flapkit/FLAP-0-BD3/hardware/bd3_rev01/exports/BD3_A3CY050B_B18A_REV01_20251206_TOP.jpeg

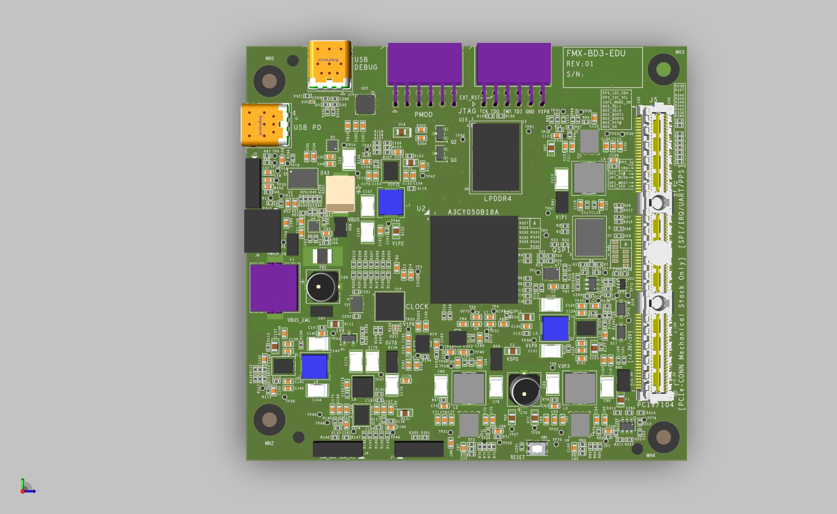
hardware/bd3_rev01/exports/BD3_A3CY050B_B18A_REV01_20251206_TOP.jpeg
