flapkit/FLAP-0-BD3/README.md

# FLAP-0 BD3  
**Open FPGA CubeSat Development Board**

<br>


<br>

## Overview

FLAP-0 BD3 is an open-source FPGA-based CubeSat development board designed for education, research, and early-stage space systems prototyping. The board enables experimentation with reconfigurable logic, control systems, sensor interfacing, and hardware–software co-design using fully open design files and documentation.

BD3 serves as the foundational hardware platform in the FLAP-0 family.

## Intended Use

- CubeSat avionics learning and prototyping  
- FPGA-based reconfigurable logic experimentation  
- Control systems and payload interfacing  
- Hardware–software co-design education  
- Ground-in-the-loop and hardware-in-the-loop testing  

## Repository Contents

- Schematics  
- PCB layout files  
- Bill of materials  
- Assembly outputs  
- Software and reference designs  
- Documentation and lab materials  

All files are provided in editable source formats.

## Licensing

- Hardware license: CERN-OHL-S v2  
- Software license: MIT  
- Documentation license: CC-BY-SA-4.0  

## Open Source Hardware Certification

FLAP-0 BD3 is certified as **Open Source Hardware** by the Open Source Hardware Association (OSHWA)

- Certification authority. OSHWA  
- Project name. FLAP-0 BD3 – Open FPGA CubeSat Board  
- Hardware version. BD3 Rev 01  
- Certification UID. To be added once issued  
- Documentation repository. https://github.com/flapkit/FLAP-0-BD3  

All design files, schematics, PCB layouts, bill of materials, and documentation are publicly available in editable formats in accordance with OSHWA certification requirements.

## Disclaimer

FLAP-0 BD3 is a foundational FPGA CubeSat development board intended for education, research, and space systems prototyping, and it does not claim or provide space-qualified capabilities.

## Citation

If you use FLAP-0 BD3 in academic or research work, please cite the repository and reference this hardware version.

## Contact

 Email: info@flapkit.org
