flapkit/FLAP-0-BD3/CERTIFICATION.md

# Open Source Hardware Certification

FLAP-0 BD3 is certified as **Open Source Hardware** by the Open Source Hardware Association (OSHWA).

## Certification Details

- **Certification Authority**: OSHWA
- **Project Name**: FLAP-0 BD3 – Open FPGA CubeSat Board
- **Hardware Version**: BD3 Rev 01
- **Certification UID**: To be added once issued
- **Documentation Repository**: https://github.com/flapkit/FLAP-0-BD3

## Compliance

All design files, schematics, PCB layouts, bill of materials, and documentation are publicly available in editable formats in accordance with OSHWA certification requirements.

## License

- **Hardware**: CERN-OHL-S v2 (see LICENSE-HARDWARE)
- **Software**: MIT (see LICENSE-SOFTWARE)
- **Documentation**: CC-BY-SA-4.0 (see LICENSE-DOCUMENTATION)

## Certification Requirements Met

- [x] Hardware design files available in editable formats
- [x] Documentation provided in open formats
- [x] Bill of materials (BOM) provided
- [x] Assembly instructions provided
- [x] Clear licensing for hardware, software, and documentation
- [x] Source files maintained in public repository
