flapkit/FLAP-0-BD3/hardware/bd3_rev01/bom/BD3_A3CY050B_REV01_20251206.xlsx

BD3_A3CY050B_REV01 Revised: December 06, 2025
Revision: 01
Item | Quantity | Reference | Part | Description | PCB Footprint | Manufacture | Manufacture PN | Distributer | Distr PN
1 | 6 | C1,C16,C17,C28,C29,C35 | 4.7uF | CAP-CER,SMD;4.7uF,20%,0402,6.3V,X5R | C0402 | TAIYO YUDEN | JMK105BBJ475MV-F | DIGIKEY | 587-2787-1-ND
2 | 39 | C2,C59,C60,C72,C73,C76,C86,C91,C92,C94,C104,C108,C109,C111,C121,C126,C127,C136,C138,C141,C150,C152,C153,C164,C167,C168,C169,C170,C178,C179,C180,C184,C189,C190,C193,C279,C280,C286,C297 | 0.1uF | CAP-CER,SMD;0.1uF,10%,0603,50V,X7R | C0603 | MURATA | GRM188R71H104KA93D | DIGIKEY | 490-1519-2-ND
3 | 8 | C3,C87,C88,C105,C122,C135,C149,C163 | 1uF | CAP-CER,SMD;1uF,10%,0603,50V,X5R | C0603 | MURATA | GRM188R61H105KAALD | DIGIKEY | 490-10732-2-ND
4 | 8 | C4,C5,C6,C7,C8,C9,C14,C15 | 47uF | CAP CER 47UF 6.3V X5R 0603 | C0603 | Murata Electronics | ZRB18AR60J476ME01L | Digikey | 490-13255-1-ND
5 | 17 | C10,C11,C12,C13,C18,C20,C27,C30,C36,C37,C194,C219,C240,C254,C260,C266,C276 | 10uF | CAP CER 10UF 10V X5R 0402 | C0402 | Samsung Electro-Mechanics | CL05A106MP8NUB8 | Digikey | 1276-6830-1-ND
6 | 18 | C19,C21,C22,C23,C24,C25,C26,C31,C32,C33,C34,C38,C39,C40,C41,C42,C43,C44 | 1uF | CAP CER 1UF 10V X5R 0201 | C0201 | Taiyo Yuden | LMK063BBJ105MPLF | Digikey | 587-6263-1-ND
7 | 15 | C45,C46,C48,C49,C50,C84,C85,C102,C103,C119,C120,C134,C148,C162,C301 | 0.01uF | CAP-CER,SMD;0.01uF,10%,0603,100V,X7R | C0603 | MURATA | GRM188R72A103KA01D | DIGIKEY | 490-6438-2-ND
8 | 20 | C47,C61,C71,C74,C75,C89,C90,C93,C106,C107,C110,C124,C125,C139,C140,C154,C155,C166,C171,C300 | 10uF | CAP CER 10UF 35V X5R 0603 | C0603 | Murata Electronics | GRM188R6YA106MA73D | Digikey | 490-13248-1-ND
9 | 3 | C51,C52,C53 | 22uF | CAP-CER,SMD;22uF,10%,1210,25V,X5R | C1210 | MURATA | GRM32ER61E226KE15L | DIGIKEY | 490-3889-1-ND
10 | 2 | C54,C55 | 330pF | CAP CER 330PF 50V X7R 0603 | C0603 | YAGEO | CC0603KRX7R9BB331 | Digikey | 311-1186-1-ND
11 | 3 | C56,C57,C58 | 10uF | CAP CER 10UF 6.3V X5R 0603 | C0603 | Murata Electronics | GRM188R60J106ME84D | Digikey | 490-7316-1-ND
12 | 1 | C62 | 2200pF | CAP-CER,SMD;2200pF,10%,0402,50V,X7R | C0402 | MURATA | GRM155R71H222KA01D | DIGIKEY | 490-1305-2-ND
13 | 12 | C63,C82,C83,C100,C101,C117,C118,C133,C147,C161,C290,C294 | 1000pF | CAP-CER,SMD;1000pF,10%,0402,50V,X7R | C0402 | MURATA | GRM155R71H102KA01D | DIGIKEY | 490-1303-2-ND
14 | 2 | C64,C284 | 0.01uF | CAP-CER,SMD;0.01uF,10%,0402,50V,X7R | C0402 | MURATA | GRM155R71H103KA88J | DIGIKEY | 490-6351-2-ND
15 | 4 | C65,C66,C67,C68 | 4.7uF | CAP CER 4.7UF 50V X7R 1206 | C1206 | Murata Electronics | GRM31CR71H475KA12L | Digikey | 490-6521-1-ND
16 | 2 | C69,C70 | 47uF | CAP ALUM 47UF 20% 50V SMD | EEE-FN1H470XP | Panasonic Electronic Components | EEE-FN1H470XP | Digikey | 10-EEE-FN1H470XPCT-ND
17 | 5 | C77,C95,C128,C142,C156 | 33pF | CAP-CER,SMD;33pF,1%,0402,50V,NP0 | C0402 | MURATA | GRM1555C1H330FA01D | DIGIKEY | 490-6231-1-ND
18 | 30 | C78,C79,C80,C81,C96,C97,C98,C99,C113,C114,C115,C116,C129,C130,C131,C132,C143,C144,C145,C146,C157,C158,C159,C160,C172,C173,C174,C175,C176,C177 | 47uF | CAP-CER,SMD;47uF,10%,1210,16V,X5R | C1210 | MURATA | GRM32ER61C476KE15K | DIGIKEY | 490-6538-1-ND
19 | 3 | C112,C187,C281 | 100pF | CAP-CER,SMD;100pF,5%,0402,50V,NP0 | C0402 | MURATA | GRM1555C1H101JA01D | DIGIKEY | 490-5922-1-ND
20 | 3 | C123,C137,C151 | 0.47uF | CAP-CER,SMD;0.47uF,10%,0805,50V,X7R | C0805 | MURATA | GRM21BR71H474KA88K | DIGIKEY | 490-8319-2-ND
21 | 1 | C165 | 0.22uF | CAP-CER,SMD;0.22uF,10%,0402,16V,X7R | C0402 | MURATA | GRM155R71C224KA12D | DIGIKEY | 490-5418-2-ND
22 | 7 | C181,C185,C186,C188,C191,C192,C282 | 2.2uF | CAP-CER,SMD;2.2uF,10%,0603,16V,X5R | C0603 | MURATA | GRM188R61C225KE15D | DIGIKEY | 490-3296-2-ND
23 | 3 | C182,C298,C299 | 47pF | CAP-CER,SMD;47pF,5%,0402,50V,X5R | C0402 | MURATA | GRM1555C1H470JA01D | DIGIKEY | 490-5942-1-ND
24 | 1 | C183 | 4.7uF | CAP CER 4.7UF 10V X5R 0402 | C0402 | Murata Electronics | GRM155R61A475MEAAD | Digikey | 490-14306-1-ND
25 | 52 | C195,C196,C197,C198,C199,C200,C201,C202,C203,C204,C205,C206,C207,C208,C209,C210,C211,C212,C213,C214,C215,C216,C217,C218,C220,C221,C222,C223,C224,C225,C226,C227,C228,C229,C230,C231,C232,C233,C234,C235,C236,C237,C238,C239,C241,C242,C243,C244,C245,C246,C247,C248 | 0.1uF | CAP-CER,SMD;0.1uF,10%,0201,10V,X5R | C0201 | MURATA | GRM033R61A104KE15D | DIGIKEY | 490-5881-1-ND
26 | 2 | C251,C252 | 18pF | CAP-CER,SMD;18pF,1%,0402,50V,NP0 | C0402 | MURATA | GRM1555C1H180FA01D | DIGIKEY | 490-6203-1-ND
27 | 13 | C253,C255,C256,C259,C261,C262,C263,C264,C265,C267,C269,C275,C277 | 1uF | CAP-CER,SMD;1uF,10%,0402,10V,X5R | C0402 | MURATA | GRM155R61A105KE15D | DIGIKEY | 490-3890-1-ND
28 | 18 | C257,C258,C268,C270,C271,C272,C273,C274,C278,C283,C287,C288,C289,C291,C292,C293,C295,C296 | 0.1uF | CAP-CER,SMD;0.1uF,10%,0402,25V,X7R | C0402 | TDK | C1005X7R1E104K050BB | DIGIKEY | 445-7348-2-ND
29 | 1 | C285 | 1000pF | CAP-CER,SMD;1000pF,10%,0402,25V,X5R | C0402 | MURATA | GRM155R61E102KA01D | DIGIKEY | 490-6315-2-ND
30 | 2 | C302,C303 | 2200pF | CAP-CER,SMD;2200pF,10%,1808,,2KV,X7R | PA_SMC1808A | YAGEO | CC1808KKX7RDBB222 | DIGIKEY | 311-4538-2-ND
31 | 4 | D1,D2,D3,D4 | PESD2V0Y1BSFYL | 3V (Typ) Clamp 6A (8/20µs) Ipp Tvs Diode Surface Mount DSN0603-2 | PESD2V0Y1BSFYL | Nexperia USA Inc. | PESD2V0Y1BSFYL | Digikey | 1727-PESD2V0Y1BSFYLCT-ND
32 | 1 | D5 | 22V, TVS2200DRVR | UNIDIR PRECISION SURGE DIODE | TVS2200DRVR | Texas Instruments | TVS2200DRVR | Digikey | 296-52187-1-ND
33 | 25 | D8,D9,D10,D11,D12,D13,D14,D15,D20,D23,D24,D25,D26,D27,D28,D29,D33,D34,D35,D36,D37,D38,D39,D40,D41 | GG040203100N2P | TVS DIODE 3.3VWM 10VC 0402 | GG040203100N2P | KYOCERA AVX | 478-GG040203100N2PCT-ND | Digikey | 478-GG040203100N2PCT-ND
34 | 1 | D16 | RED GREEN | LED-SMD;2.1V-1.95V,20mA-20mA,0805,GREEN-RED,APHBM2012SURKCGKC | LED_RG_0805 | KINGBRIGHT | APHBM2012SURKCGKC | DIGIKEY | 754-1093-2-ND
35 | 3 | D17,D18,D19 | 1N5819 | DIODE SCHOTTKY 40V 1A SOD123 | 1N5819_SOD123 | Diodes | 1N5819HW-7-F | Digikey | 1N5819HW-FDICT-ND
36 | 1 | D30 | ESD441DPLR | TVS DIODE 5.5VWM 7.6VC 2X2SON | ESD441DPLR | Texas Instruments | ESD441DPLR | Digikey | 296-ESD441DPLRCT-ND
37 | 2 | D31,D32 | ESD321DPYR | TVS DIODE 3.6VWM 6.8VC 2X1SON | ESD321DPYR | Texas Instruments | ESD321DPYR | Digikey | 296-51108-1-ND
38 | 2 | D42,D43 | B560C-13-F | DIODE SCHOTTKY 60V 5A SMC | B560C-13-F | Diodes Incorporated | B560C-13-F | DIGIKEY | B560C-FDICT-ND
39 | 1 | FB1 | 600 Ohm @ 100 MHz | FERRITE BEAD 600 OHM 0402 1LN | FB0402 | Murata Electronics | BLM15PX601SN1D | Digikey | 490-9657-1-ND
40 | 3 | FB2,FB3,FB10 | 26 Ohms @ 100 MHz | FERRITE BEAD 26 OHM 0603 1LN | FB0603 | Murata Electronics | BLM18KG260TN1D | Digikey | 490-5252-1-ND
41 | 5 | FB4,FB6,FB7,FB8,FB9 | 22 Ohms @ 100 MHz | FERRITE BEAD 22 OHM 0603 1LN | FB0603 | Murata Electronics | BLM18SN220TZ1D | Digikey | 490-13960-1-ND
42 | 1 | FB5 | 56 Ohms @ 100 MHz | FERRITE BEAD 56 OHM 1612 1LN | FB1612 | Würth Elektronik | 74279223560 | Digikey | 732-3421-1-ND
43 | 2 | F1,F2 | PTSLR08058V400 | PTC RESET FUSE 4A 8V 0805 | PTSLR08058V400 | Eaton - Electronics Division | PTSLR08058V400 | Digikey | 283-PTSLR08058V400CT-ND
44 | 2 | J1,J6 | PPPC062LJBN-RC | CONN HDR 12POS 0.1 GOLD PCB R/A | PPPC062LJBN-RC | Sullins Connector Solutions | PPPC062LJBN-RC | Digikey | S5559-ND
45 | 2 | J2,J10 | 12402012E212A | CONN RCP USB2.0 TYP C 24P SMD RA | 12402012E212A | Amphenol ICC (Commercial Products) | 12402012E212A | Digikey | 664-12402012E212ACT-ND
46 | 3 | J3,J4,J7 | CONN 4POS 2.54MM | CONN HEADER VERT 4POS 2.54MM | 1X4POS_2P54MM | Würth Elektronik | 61300411121 | Digikey | 732-5317-ND
47 | 1 | J5 | ASP-129637-03 | CONN HDR 156POS SMD GOLD | ASP-129637-03 | Samtec Inc. | ASP-129637-03 | Digikey | SAM10405-ND
48 | 1 | J8 | CSS-1210TB | SWITCH SLIDE SPDT 100MA 12V | CSS-1210TB | Nidec Components Corporation | CSS-1210TB | Digikey | 563-1091-1-ND
49 | 1 | L1 | 4.7uH | FIXED IND 4.7UH 10A 15.5MOHM SMD | L_PA4342_472NLT | Pulse Electronics | PA4342.472NLT | Digikey | 553-3001-1-ND
50 | 3 | L2,L3,L4 | 0.68uH | IND 7X6.6X1.8MM 0.68UH20% 10.5A | L_7M0x6M6x2M0 | Bourns Inc. | SRP7020TA-R68M | Digikey | 118-SRP7020TA-R68MCT-ND
51 | 3 | L5,L6,L7 | 5.6uH | IND SMD 5.6UH 3.6A | L_5M7x5M2x3M0 | Bourns Inc. | SRP5030CC-5R6M | Digikey | 118-SRP5030CC-5R6MCT-ND
52 | 1 | L8 | 100nH | FIXED IND 100NH 25.8A 1.8MOHM SM | L_4M0x4Mx3M2 | Coilcraft | XEL4030-101MEC | Digikey | 2457-XEL4030-101MEC-ND
53 | 4 | MH1,MH2,MH3,MH4 | MH_D170C600 | MH-PLATE;170MIL_600MIL | M3_MH
54 | 3 | Q1,Q2,Q3 | SSM3K2615R,LF | MOSFET N-CH 60V 2A SOT23 | SSM3K2615R | Toshiba Semiconductor and Storage | SSM3K2615R,LF | Digikey | SSM3K2615RLFCT-ND
55 | 51 | R1,R2,R3,R7,R11,R12,R14,R15,R16,R17,R18,R26,R27,R28,R30,R45,R48,R54,R94,R123,R127,R129,R149,R157,R240,R293,R294,R295,R296,R299,R300,R301,R307,R309,R312,R317,R336,R337,R338,R339,R340,R341,R342,R343,R344,R345,R346,R347,R348,R349,R350 | 10K | RES-SMD;10KOHM,1%,0402,1/16W | R0402 | YAGEO | RC0402FR-0710KL | DIGIKEY | 311-10.0KLRTR-ND
56 | 8 | R4,R5,R6,R8,R29,R31,R135,R141 | 22 | RES-SMD;22OHM,1%,0402,1/16W | R0402 | YAGEO | RC0402FR-0722RL | DIGIKEY | 311-22.0LRTR-ND
57 | 1 | R9 | 2K | RES-SMD;2KOHM,1%,0402,1/16W | R0402 | YAGEO | RC0402FR-072KL | DIGIKEY | 311-2KLRTR-ND
58 | 36 | R10,R13,R67,R68,R73,R75,R78,R79,R84,R85,R88,R89,R90,R95,R96,R97,R98,R100,R102,R108,R110,R119,R121,R130,R132,R133,R139,R140,R146,R147,R148,R154,R160,R161,R162,R163 | 0 | RES-SMD;0OHM,JUM,0402,1/16W | R0402 | YAGEO | RC0402JR-070RL | DIGIKEY | 311-0.0JRCT-ND
59 | 12 | R19,R20,R21,R22,R23,R24,R305,R306,R310,R311,R313,R315 | 4.7K | RES-SMD;4.7KOHM,1%,0402,1/16W | R0402 | YAGEO | RC0402FR-074K7L | DIGIKEY | 311-4.7KLRTR-ND
60 | 28 | R25,R71,R82,R93,R105,R113,R124,R136,R151,R152,R155,R158,R180,R195,R196,R197,R198,R200,R201,R202,R204,R205,R206,R207,R208,R209,R210,R239 | 1K | RES-SMD;1KOHM,1%,0402,1/16W | R0402 | YAGEO | RC0402FR-071KL | DIGIKEY | 311-1.00KLRTR-ND
61 | 3 | R32,R156,R159 | 240 | RES-SMD;240OHM,1%,0402,1/16W | R0402 | YAGEO | RC0402FR-07240RL | DIGIKEY | 311-240LRTR-ND
62 | 8 | R33,R34,R166,R167,R186,R297,R308,R314 | 0 | RES-SMD;0OHM,JUM,0402,1/10W | R0402 | PANASONIC | ERJ-2GE0R00X | DIGIKEY | P0.0JTR-ND
63 | 29 | R35,R36,R37,R38,R39,R40,R41,R42,R43,R44,R165,R169,R283,R284,R285,R286,R287,R288,R289,R290,R327,R328,R329,R330,R331,R332,R333,R334,R335 | 0 | RES-SMD;0OHM,JUM,0201,1/20W | R0201 | YAGEO | RC0201JR-070RL | DIGIKEY | YAG1244CT-ND
64 | 2 | R47,R55 | 200K | RES-SMD;200KOHM,5%,0402,1/16W | R0402 | YAGEO | RC0402JR-07200KL | DIGIKEY | 311-200KJRCT-ND
65 | 2 | R49,R50 | 169K | RES 169K OHM 1% 1/16W 0402 | R0402 | YAGEO | RC0402FR-07169KL | Digikey | YAG3000CT-ND
66 | 2 | R51,R52 | 3.3K | RES-SMD;3.3KOHM,1%,0603,1/10W | R0603 | YAGEO | RC0603FR-073K3L | DIGIKEY | 311-3.30KHRTR-ND
67 | 2 | R56,R57 | 40.2K | RES SMD 40.2K OHM 1% 1/16W 0402 | R0402 | YAGEO | AC0402FR-0740K2L | Digikey | YAG3486CT-ND
68 | 1 | R58 | 0 | RES-SPECIAL;0OHM,JUM,R10A,10A | R10A | SELF DEFINE | R-0OHM-PCB-10A
69 | 9 | R59,R65,R70,R74,R81,R116,R138,R144,R145 | 100K | RES-SMD;100KOHM,1%,0402,1/16W | R0402 | YAGEO | RC0402FR-07100KL | DIGIKEY | 311-100KLRTR-ND
70 | 1 | R60 | 97.6K | RES-SMD;97.6KOHM,1%,0402,1/16W | R0402 | YAGEO | RC0402FR-0797K6L | DIGIKEY | 311-97.6KLRTR-ND
71 | 2 | R61,R76 | 15K | RES-SMD;15KOHM,1%,0402,1/16W | R0402 | YAGEO | RC0402FR-0715KL | DIGIKEY | 311-15.0KLRTR-ND
72 | 4 | R62,R106,R114,R117 | 20K | RES-SMD;20KOHM,1%,0402,1/16W | R0402 | YAGEO | RC0402FR-0720KL | DIGIKEY | 311-20.0KLRTR-ND
73 | 1 | R63 | 2.2K | RES-SMD;2.2KOHM,1%,0402,1/16W | R0402 | YAGEO | RC0402FR-072K2L | DIGIKEY | 311-2.20KLRTR-ND
74 | 1 | R64 | 5.76K | RES 5.76K OHM 1% 1/16W 0402 | R0402 | YAGEO | RC0402FR-075K76L | DIGIKEY | YAG3196CT-ND
75 | 9 | R66,R77,R87,R103,R111,R122,R131,R153,R242 | 0 | RES-SMD;0OHM,1%,0805,1/8W | R0805 | YAGEO | RC0805JR-070RL | DIGIKEY | 311-0.0ARCT-ND
76 | 4 | R69,R80,R91,R134 | 0 | RES 0 OHM JUMPER 1/2W 1210 | R1210 | YAGEO | RC1210JR-070RL | Digikey | YAG3375CT-ND
77 | 1 | R72 | 13.7K | RES SMD 13.7KOHM 0.1% 1/16W 0402 | R0402 | Panasonic Electronic Components | ERA-2AEB1372X | Digikey | P13.7KDCCT-ND
78 | 1 | R83 | 22.1K | RES-SMD;22.1KOHM,1%,0402,1/16W | R0402 | YAGEO | RC0402FR-0722K1L | DIGIKEY | 311-22.1KLRTR-ND
79 | 1 | R86 | 16.9K | RES SMD 16.9K OHM 1% 1/16W 0402 | R0402 | YAGEO | AC0402FR-0716K9L | Digikey | YAG5638CT-ND
80 | 1 | R92 | 8.45K | RES 8.45K OHM 1% 1/16W 0402 | R0402 | YAGEO | RC0402FR-078K45L | Digikey | YAG3254CT-ND
81 | 1 | R99 | 34.8k | RES 34.8K OHM 1% 1/16W 0402 | R0402 | YAGEO | RC0402FR-0734K8L | Digikey | YAG3125CT-ND
82 | 9 | R101,R109,R120,R187,R190,R199,R203,R291,R292 | 0 | RES-SMD;0OHM,JUM,0603,1/10W | R0603 | YAGEO | RC0603JR-070RL | DIGIKEY | 311-0.0GRTR-ND
83 | 1 | R104 | 5.11K | RES-SMD;5.11KOHM,1%,0402,1/16W | R0402 | YAGEO | RC0402FR-075K11L | DIGIKEY | 311-5.11KLRTR-ND
84 | 3 | R107,R115,R126 | 71.5K | RES 71.5K OHM 1% 1/16W 0402 | R0402 | YAGEO | RC0402FR-0771K5L | Digikey | YAG3222CT-ND
85 | 1 | R112 | 25.5k | RES SMD 25.5K OHM 1% 1/16W 0402 | R0402 | YAGEO | AC0402FR-0725K5L | Digikey | YAG5657CT-ND
86 | 1 | R118 | 38.3k | RES 38.3K OHM 1% 1/16W 0402 | R0402 | YAGEO | RC0402FR-0738K3L | Digikey | YAG3141CT-ND
87 | 1 | R125 | 19.1K | RES-SMD;19.1KOHM,1%,0402,1/16W | R0402 | YAGEO | RC0402FR-0719K1L | DIGIKEY | 311-19.1KLRTR-ND
88 | 1 | R128 | 17.4K | RES-SMD;17.4KOHM,1%,0402,1/16W | R0402 | YAGEO | RC0402FR-0717K4L | DIGIKEY | 311-17.4KLRTR-ND
89 | 1 | R137 | 2.2 | RES 2.2 OHM 1% 1/16W 0402 | R0402 | YAGEO | RC0402FR-072R2L | Digikey | 311-2.20LRCT-ND
90 | 2 | R150,R241 | 560 | RES-SMD;560OHM,1%,0402,1/16W | R0402 | YAGEO | RC0402FR-07560RL | DIGIKEY | 311-560LRTR-ND
91 | 1 | R211 | 100 | RES-SMD;100OHM,1%,0201,1/20W | R0201 | YAGEO | RC0201JR-07100RL | DIGIKEY | 311-100NTR-ND
92 | 8 | R275,R276,R277,R278,R279,R280,R281,R282 | 10K | RES-SMD;10KOHM,1%,0201,1/20W | R0201 | YAGEO | RC0201FR-0710KL | DIGIKEY | 311-10.0KMCT-ND
93 | 1 | R298 | 130K | RES-SMD;130KOHM,1%,0402,1/16W | R0402 | YAGEO | RC0402FR-07130KL | DIGIKEY | YAG2969CT-ND
94 | 2 | R302,R304 | 1.5K | RES-SMD;1.5KOHM,1%,0603,1/10W | R0603 | YAGEO | RC0603FR-071K5L | DIGIKEY | 311-1.50KHRTR-ND
95 | 1 | R303 | 49.9K | RES-SMD;49.9KOHM,1%,0402,1/16W | R0402 | YAGEO | RC0402FR-0749K9L | DIGIKEY | 311-49.9KLRTR-ND
96 | 3 | R316,R319,R320 | 27 | RES-SMD;27OHM,1%,0402,1/16W | R0402 | SAMSUNG | RC1005F270CS | DIGIKEY | 1276-3907-1-ND
97 | 1 | R318 | 49.9 | RES-SMD;49.9OHM,1%,0402,1/16W | R0402 | YAGEO | RC0402FR-0749R9L | DIGIKEY | 311-49.9LRTR-ND
98 | 2 | R321,R322 | 5.1K | RES-SMD;5.1KOHM,1%,0402,1/16W | R0402 | YAGEO | RC0402FR-075K1L | DIGIKEY | 311-5.10KLRTR-ND
99 | 1 | R324 | 1M | RES-SMD;1MOHM,1%,1206,1/4W
 | PA_SMR1206 | STACKPOLE ELECTRONICS, INC. | RMCF1206FT1M00 | DIGIKEY
101 | 1 | R325 | 1M | RES D,1206, 1M OHM,1%,1/4W
 | PA_SMR1206 | STACKPOLE ELECTRONICS, INC. | RMCF1206FT1M00 | DIGIKEY
102 | 1 | SW1 | 435451019820 | Tactile Switch SPST-NO Top Actuated Surface Mount | 435451019820 | Würth Elektronik | 435451019820 | Digikey | 732-435451019820CT-ND
103 | 70 | TP1,TP2,TP3,TP4,TP5,TP6,TP7,TP8,TP9,TP10,TP11,TP12,TP13,TP14,TP18,TP19,TP20,TP21,TP22,TP23,TP24,TP25,TP26,TP27,TP28,TP29,TP30,TP31,TP32,TP33,TP34,TP35,TP36,TP37,TP38,TP39,TP40,TP41,TP42,TP43,TP44,TP45,TP46,TP47,TP48,TP49,TP50,TP51,TP52,TP53,TP54,TP55,TP56,TP57,TP58,TP59,TP60,TP61,TP62,TP63,TP66,TP67,TP68,TP69,TP70,TP71,TP72,TP73,TP74,TP75 | TP_50 | TP-SMD;50MIL | TP_50
104 | 1 | U1 | MT25QU512ABB8E12-0SIT | IC FLASH 512MBIT SPI 24TPBGA | MT25QU512A_24TPBGA | Micron Technology Inc. | MT25QU512ABB8E12-0SIT | Digikey | MT25QU512ABB8E12-0SIT-ND
105 | 1 | U2 | A3CY050B B18A | IC FGPA Altera Agilex 3 A3CY050B | A3CY100B_B18A | Altera | A3CY050B | Altera | A3CY050B
106 | 1 | U3 | USB, Type-C Controller | USB, Type-C Controller PMIC 38-WQFN (4x6) | TPS25730DREFR | Texas Instruments | TPS25730DREFR | Digikey | 296-TPS25730DREFRCT-ND
107 | 1 | U4 | LM73100RPWR | 2.7-V TO 23-V, 5.5-A IDEAL DIODE | VFQFN10_LM73100 | Texas Instruments | LM73100RPWR | Digikey | 296-LM73100RPWRCT-ND
108 | 3 | U5,U6,U7 | MPQ4371GVE-1000-AEC1-P | 36V, 6A TO 11A, LOW-EMI, SYNCHRO | QFN23_MPQ4371 | Monolithic Power Systems Inc. | MPQ4371GVE-1000-AEC1-P | Digikey | 1589-MPQ4371GVE-1000-AEC1-PCT-ND
109 | 3 | U8,U9,U10 | MPQ4324GLE-2001-AEC1-Z | 36V, 0.5A TO 4A PEAK, ULTRA-COMP | QFN12_MPQ4324 | Monolithic Power Systems Inc. | MPQ4324GLE-2001-AEC1-Z | Digikey | 1589-MPQ4324GLE-2001-AEC1-ZTR-ND
110 | 1 | U11 | MPQ2287GLE-0016-AEC1-Z | IC REG BUCK PROG 12A 18QFN | QFN18_MPQ2287 | Monolithic Power Systems Inc. | MPQ2287GLE-0016-AEC1-Z | N/A | N/A
111 | 1 | U12 | TLV75533PDYDR | IC REG LINEAR 3.3V 0.5A SOT23-5 | SOT23_5_TLV75533 | Texas Instruments | TLV75533PDYDR | Digikey | 296-TLV75533PDYDRCT-ND
112 | 2 | U13,U17 | TPS22917DBVR | IC PWR SWITCH P-CHAN 1:1 SOT23-6 | SOT23_6_TPS22917 | Texas Instruments | TPS22917DBVR | Digikey | 296-50498-1-ND
113 | 1 | U14 | TLV75518PDBVR | IC REG LINEAR 1.8V 500MA SOT23-5 | SOT23_5_TLV75533 | Texas Instruments | TLV75518PDBVR | Digikey | 296-50410-1-ND
114 | 1 | U15 | MT53E512M32D1ZW-046_ITB | SDRAM - Mobile LPDDR4 Memory IC 16Gbit Parallel 2.133 GHz 3.5 ns 200-TFBGA (10x14.5) | BGA200C65X80P22X12_1500X1000X114N
115 | 1 | U16 | SI5332L-D-GM3 | IC CLOCK GENERATOR 48QFN | SI5332L_48LGA | Skyworks Solutions Inc. | SI5332L-D-GM3 | Digikey | 863-SI5332L-D-GM3-ND
116 | 1 | U18 | TPS3895ADRYR | IC SUPERVISOR 1 CHANNEL 6SON | TPS3895ADRYR | Texas Instruments | TPS3895ADRYR | Digikey | 296-29806-1-ND
117 | 2 | U19,U20 | TPS3808G01DBVR | IC SUPERVISOR 1 CHANNEL SOT23-6 | TPS3808G01DBVR | Texas Instruments | TPS3808G01DBVR | Digikey | 296-17188-1-ND
118 | 1 | U21 | 74AUP1T34GW,125 | IC BUFF NON-INVERT 3.6V 5-TSSOP | 74AUP1T34GW | Nexperia USA Inc. | 74AUP1T34GW,125 | Digikey | 1727-6030-1-ND
119 | 1 | U22 | FT231XQ-T | IC USB SERIAL FULL UART 20QFN | FT231XQ-T | FTDI, Future Technology Devices International Ltd | FT231XQ-T | Digikey | 768-1155-ND
120 | 1 | Y1 | 100 MHz | 100 MHz XO (Standard) CMOS Oscillator 1.8V Enable/Disable 4-SMD, No Lead | 510KBB100M000CAG | Skyworks Solutions Inc. | 510KBB100M000CAG | Digikey | 863-510KBB100M000CAGTR-ND
121 | 1 | Y2 | 25.000MHz | CRYSTAL;25.0000MHz,10ppm,10PF,5MX3M2X1M05,405C11A25M00000 | XTAL4_5MX3M2X1M | CTS ELECTROCOMPONENTS | 405C11A25M00000 | DIGIKEY | CTX837CT-ND
