flapkit/FLAP-0-BD3/CHANGELOG.md

# Changelog

All notable changes to the FLAP-0 BD3 project will be documented in this file.

The format is based on [Keep a Changelog](https://keepachangelog.com/en/1.0.0/),
and this project adheres to [Semantic Versioning](https://semver.org/spec/v2.0.0.html).

## [Unreleased]

### Added
- Initial repository structure
- Hardware design files for BD3 Rev 01
- Manufacturing outputs and documentation
- OSHWA certification documentation

## [BD3 Rev 01] - 2024-01-01

### Added
- Initial release of FLAP-0 BD3 development board
- Complete hardware design files (schematics, PCB layout)
- Bill of materials (BOM)
- Assembly documentation
- Manufacturing files (Gerber, drill files, pick-and-place)
- Educational documentation and lab guides

[Unreleased]: https://github.com/flapkit/FLAP-0-BD3/compare/bd3-rev01...HEAD
[BD3 Rev 01]: https://github.com/flapkit/FLAP-0-BD3/releases/tag/bd3-rev01
