flapkit/FLAP-0-BD3/hardware/bd3_rev01/assembly/BD3_A3CY050B_B18A_REV01_20251206_ASSEMBLY_BOTTOM.PDF

# ASSEMBLY_BOTTOM

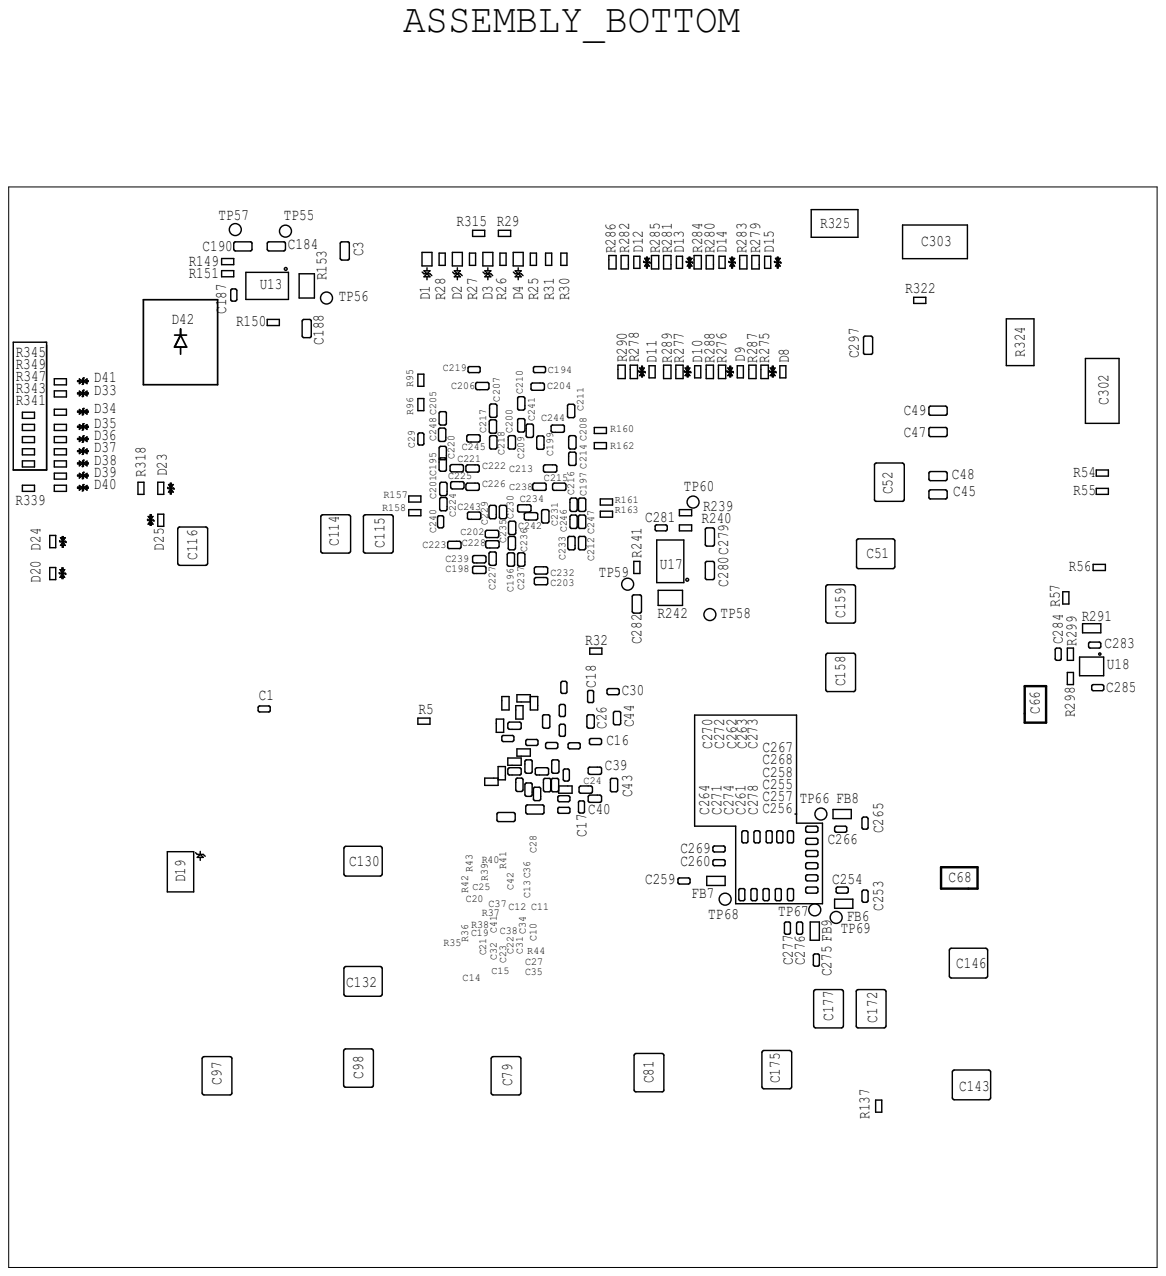
[picture p3: page 1]
