flapkit/FLAP-0-BD3/hardware/bd3_rev01/assembly/BD3_A3CY050B_B18A_REV01_20251206_ASSEMBLY_TOP.pdf

# ASSEMBLY_TOP

J10

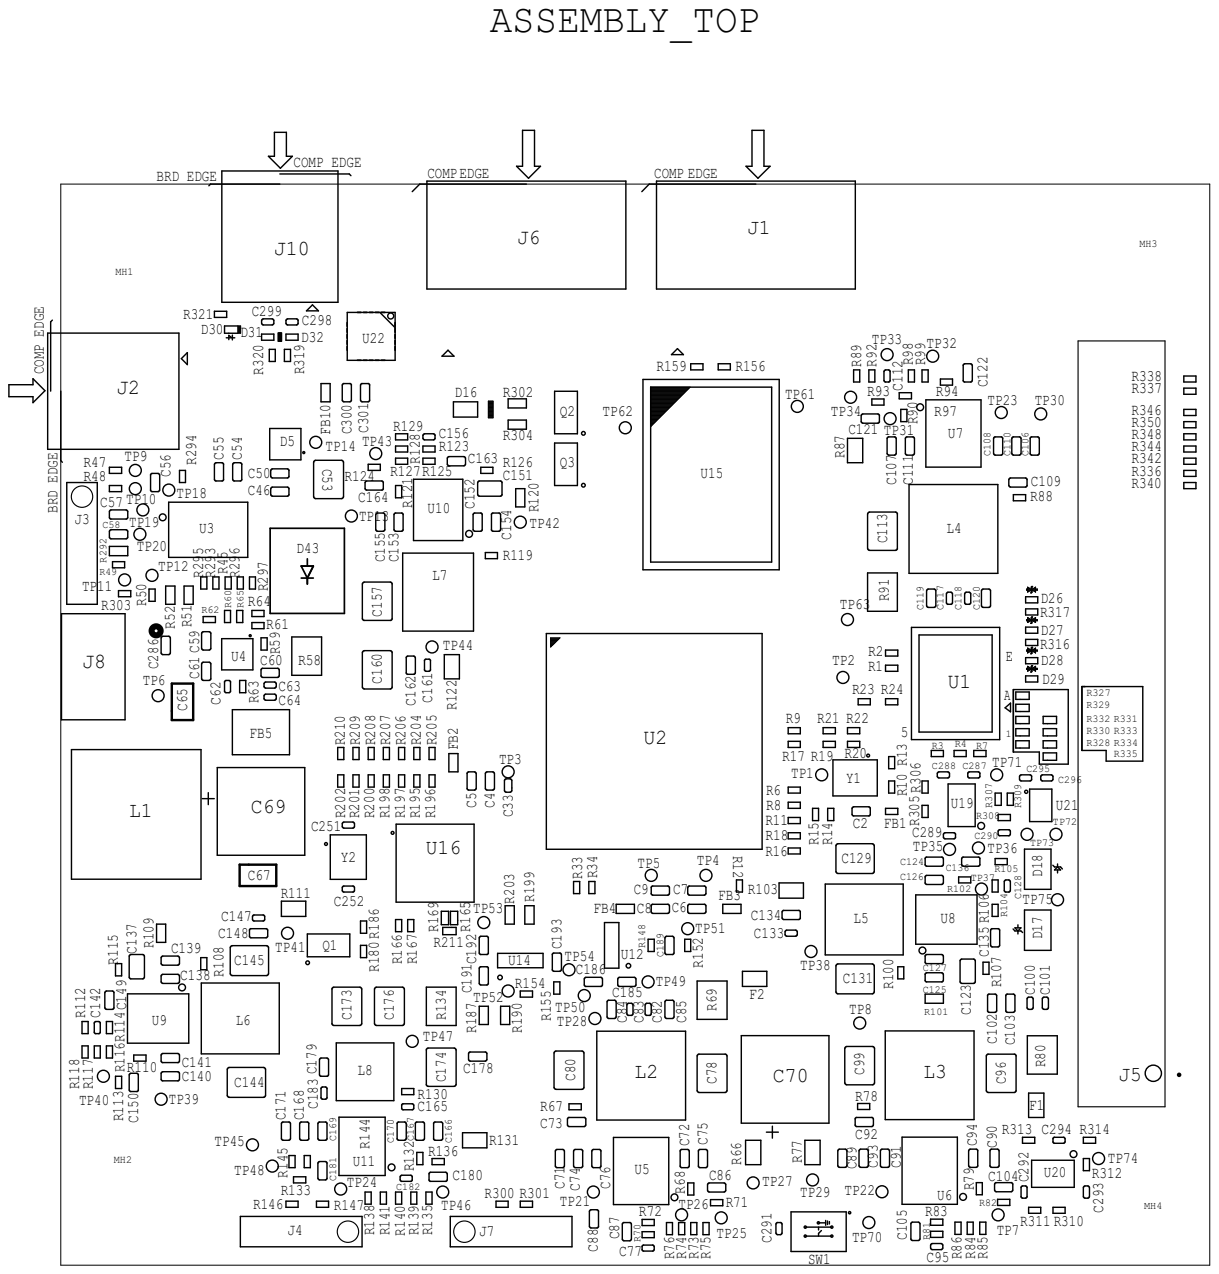
[picture p4: page 1]
