flapkit/FLAP-0-BD3/hardware/bd3_rev01/schematics/BD3_A3CY050B_REV01_20251206.pdf

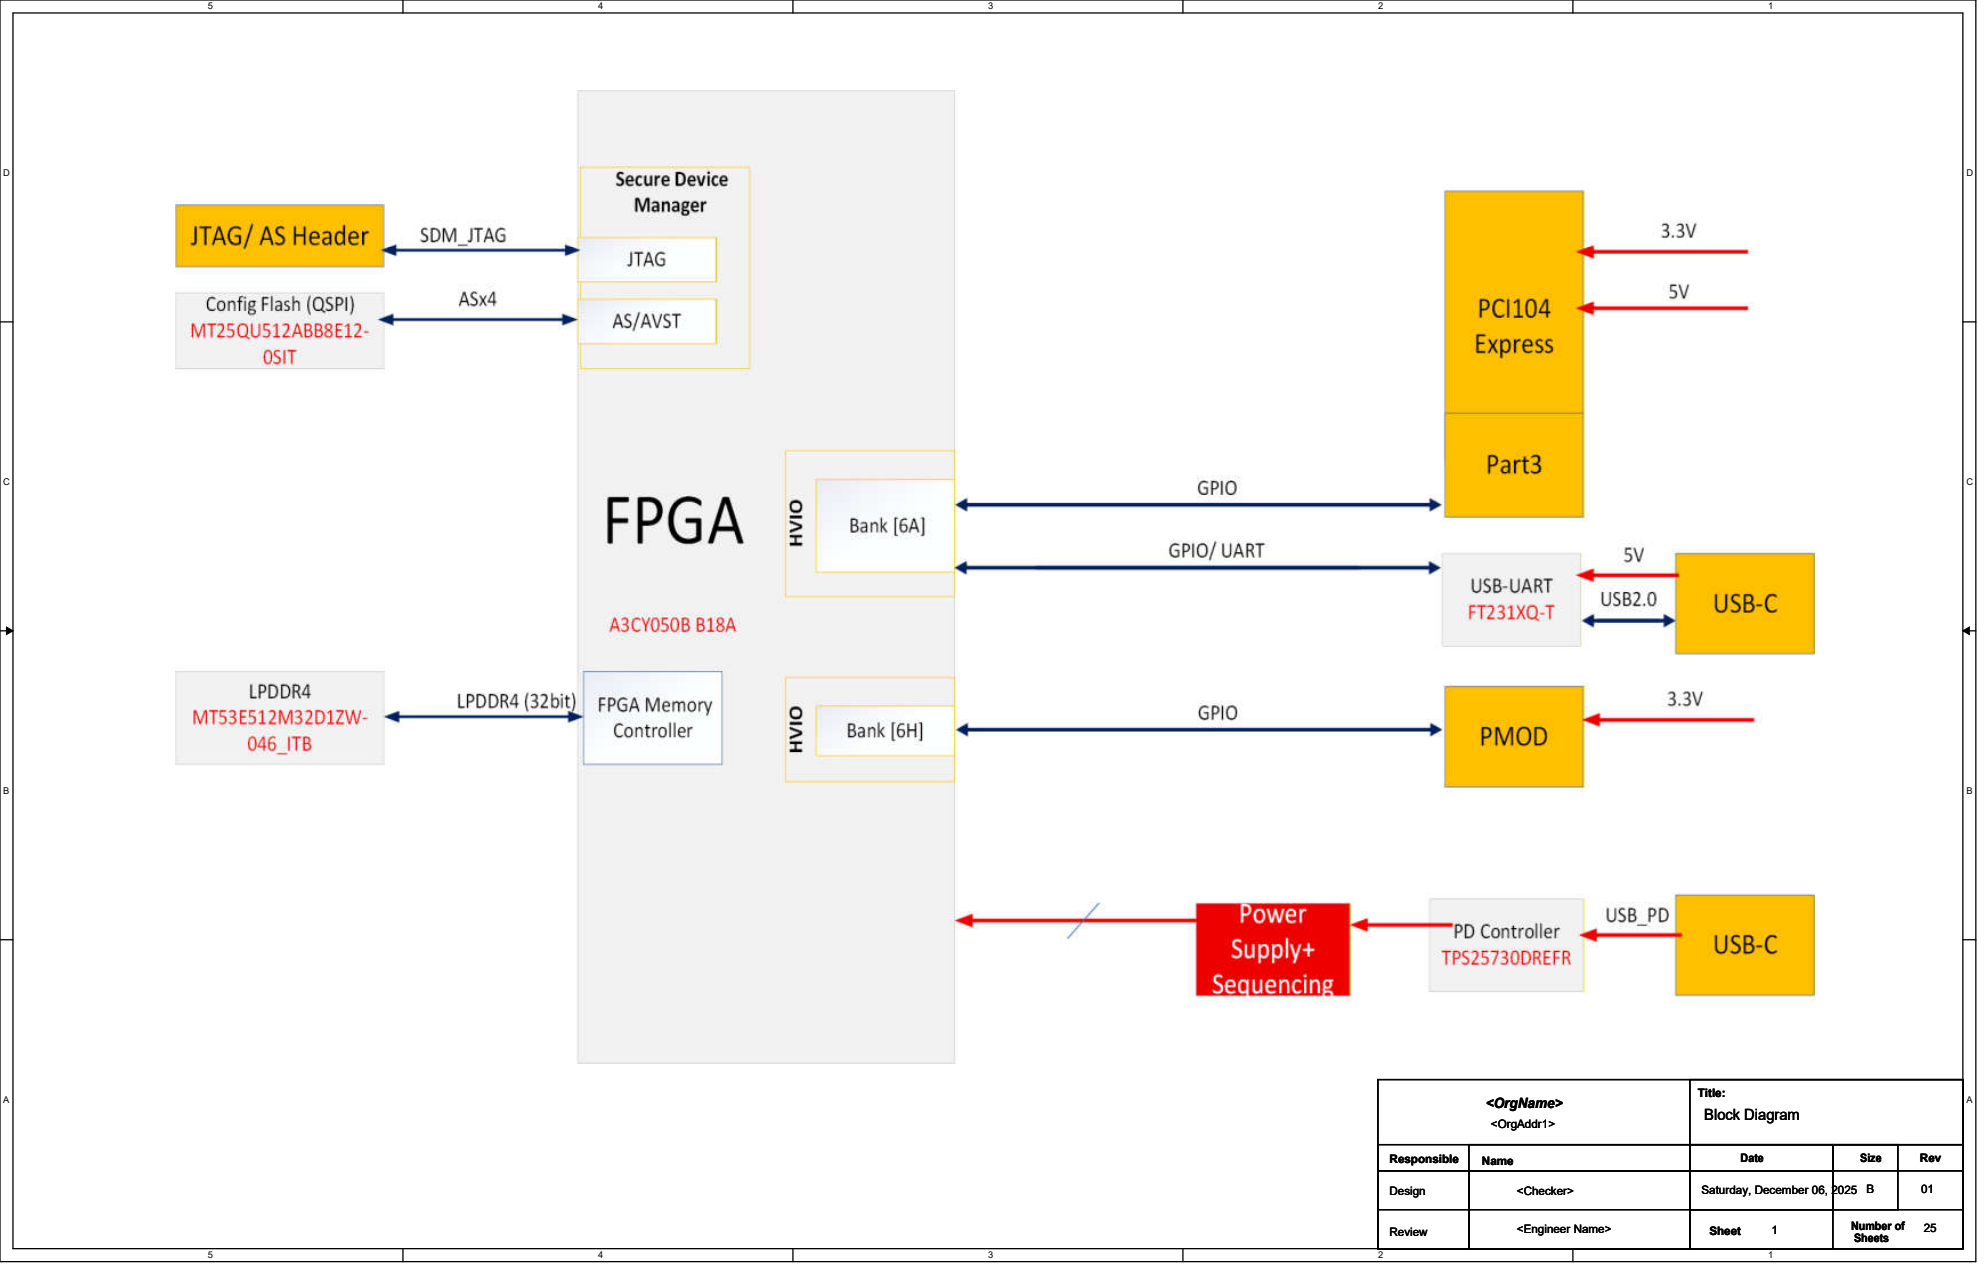
[picture p5: page 1]
A Title:; Size; Rev; Review; Sheet; Number of; Sheets; Design; Responsible; Name; Date; <OrgAddr1>; <Checker>; <Engineer Name>; Saturday, December 06, 2025; Title:

Block Diagram <OrgName>

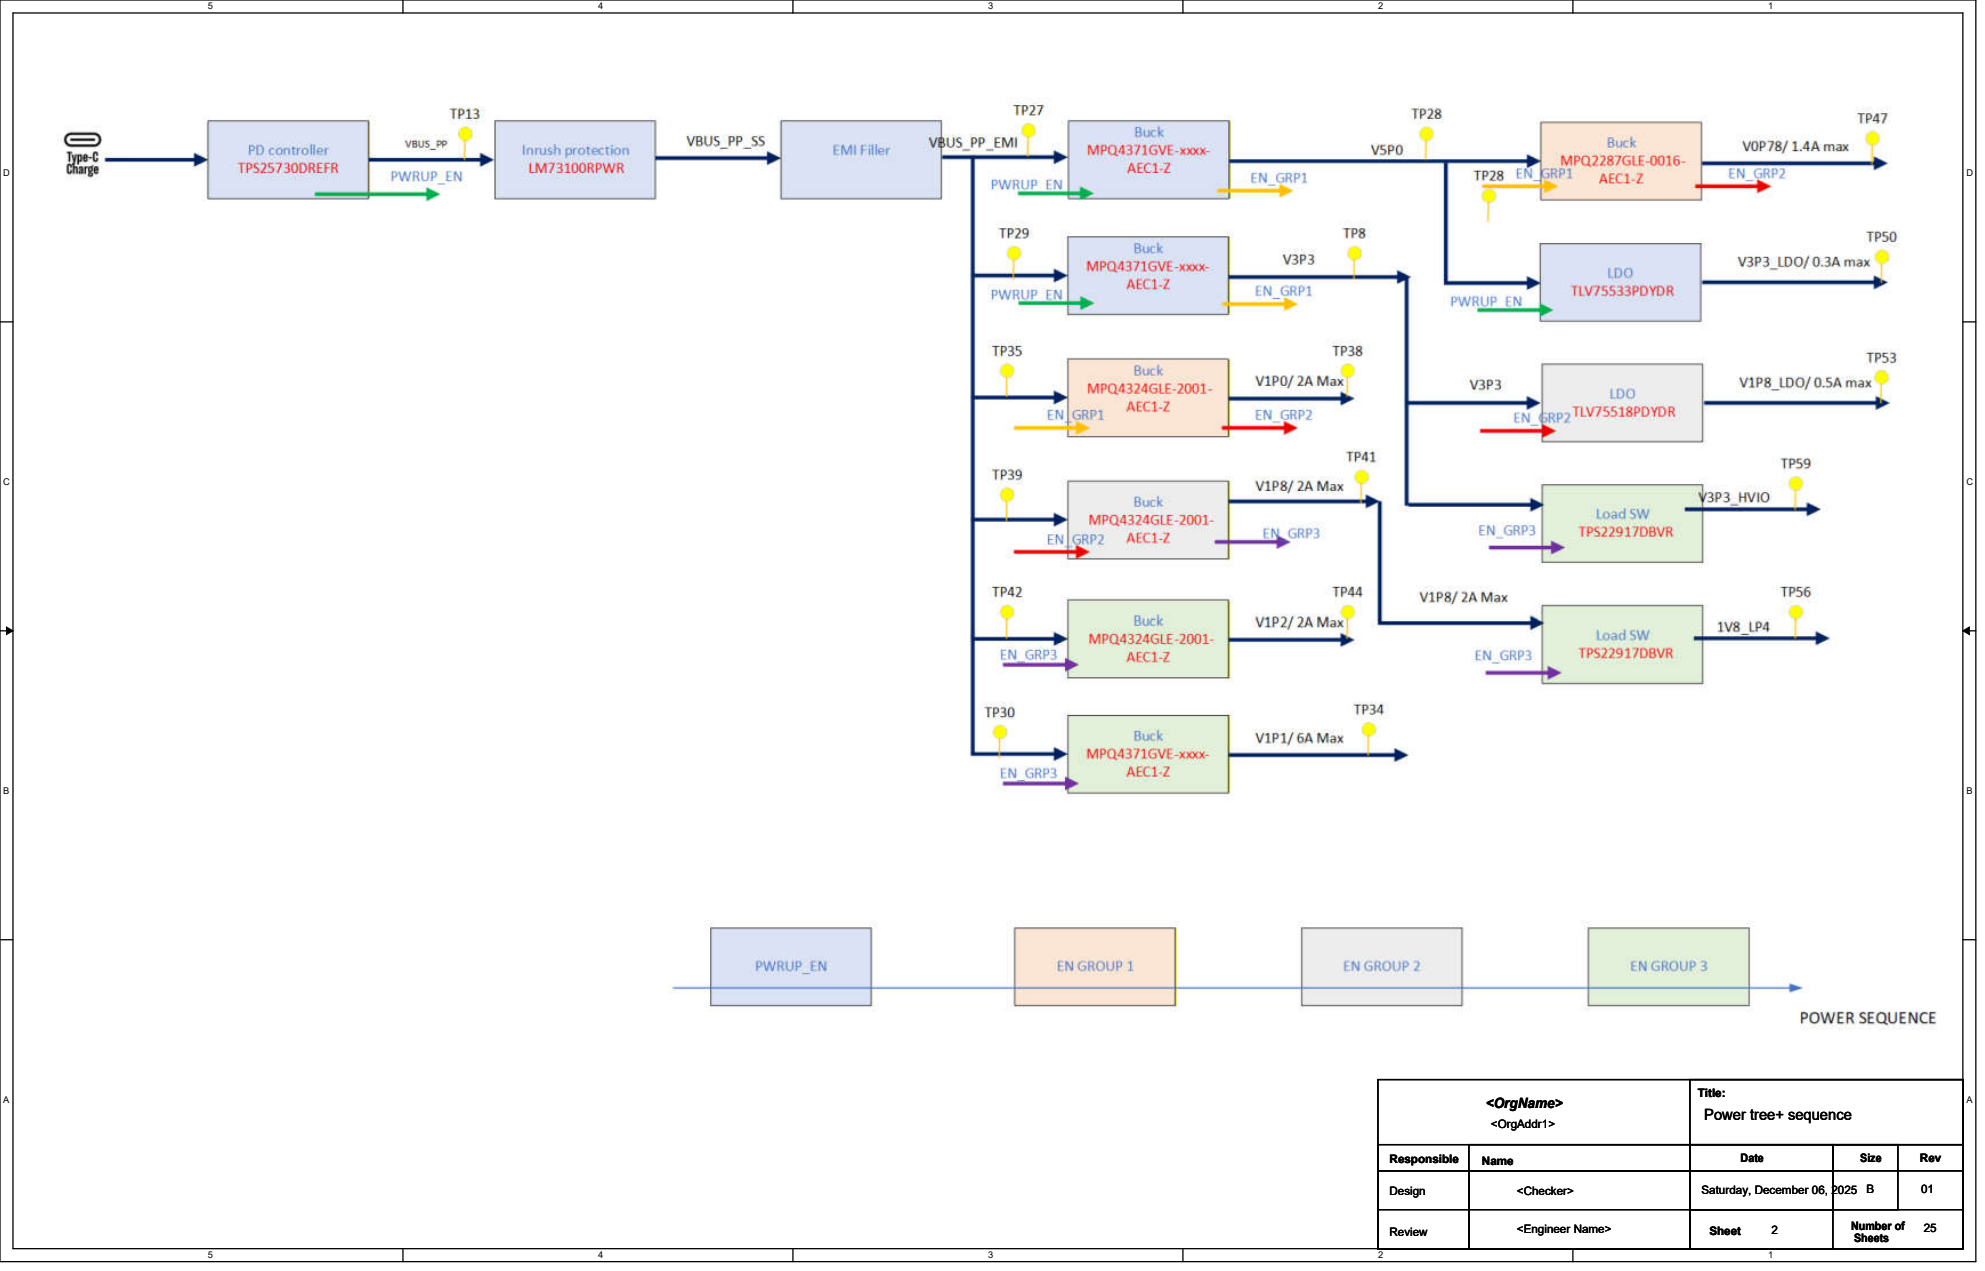
[picture p6: page 2]
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

Power tree+ sequence <OrgName>

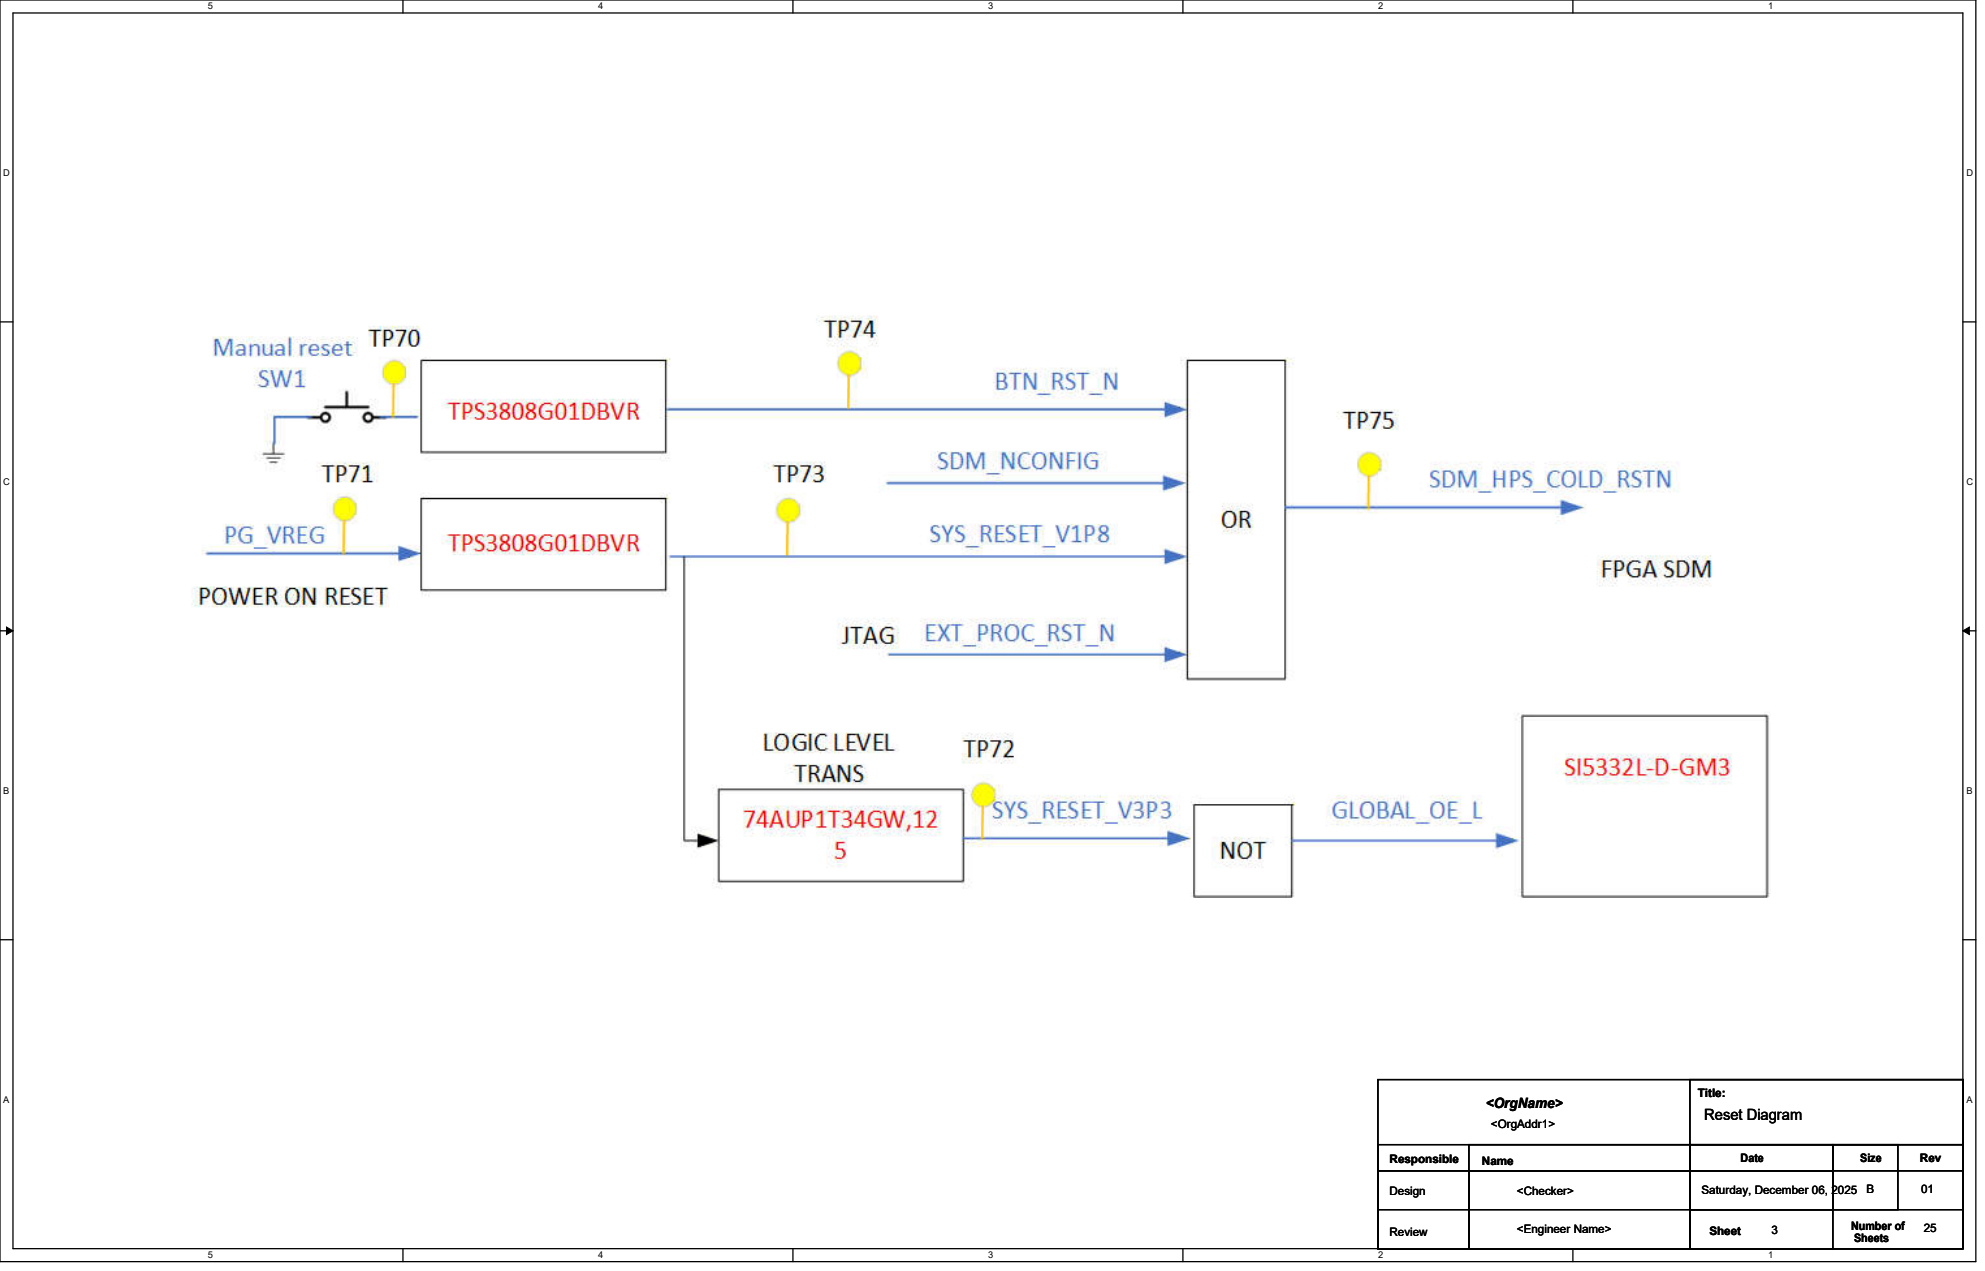
[picture p7: page 3]
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

Reset Diagram <OrgName>

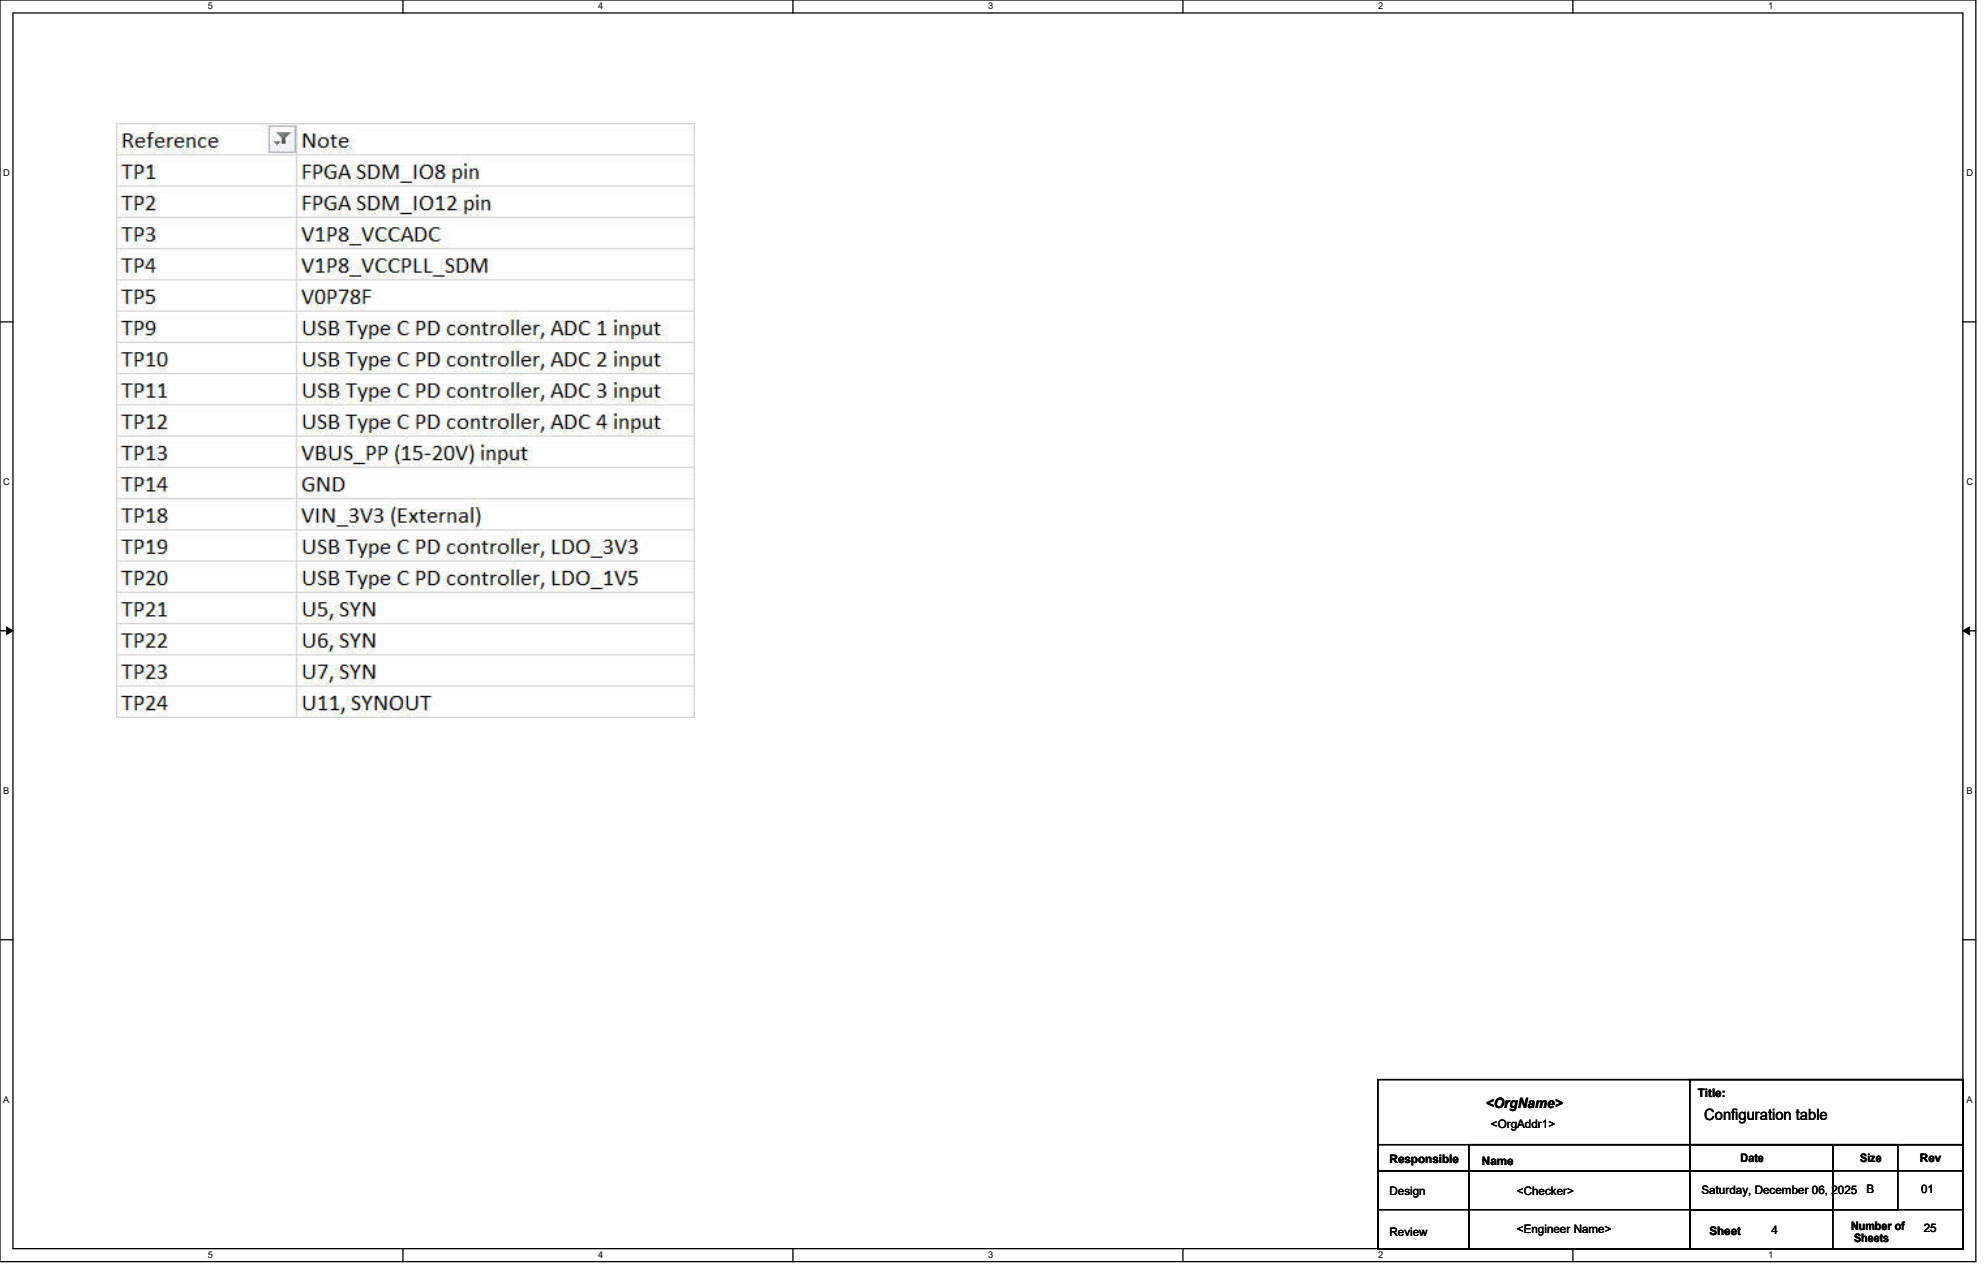
[picture p8: page 4]
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

Configuration table <OrgName>

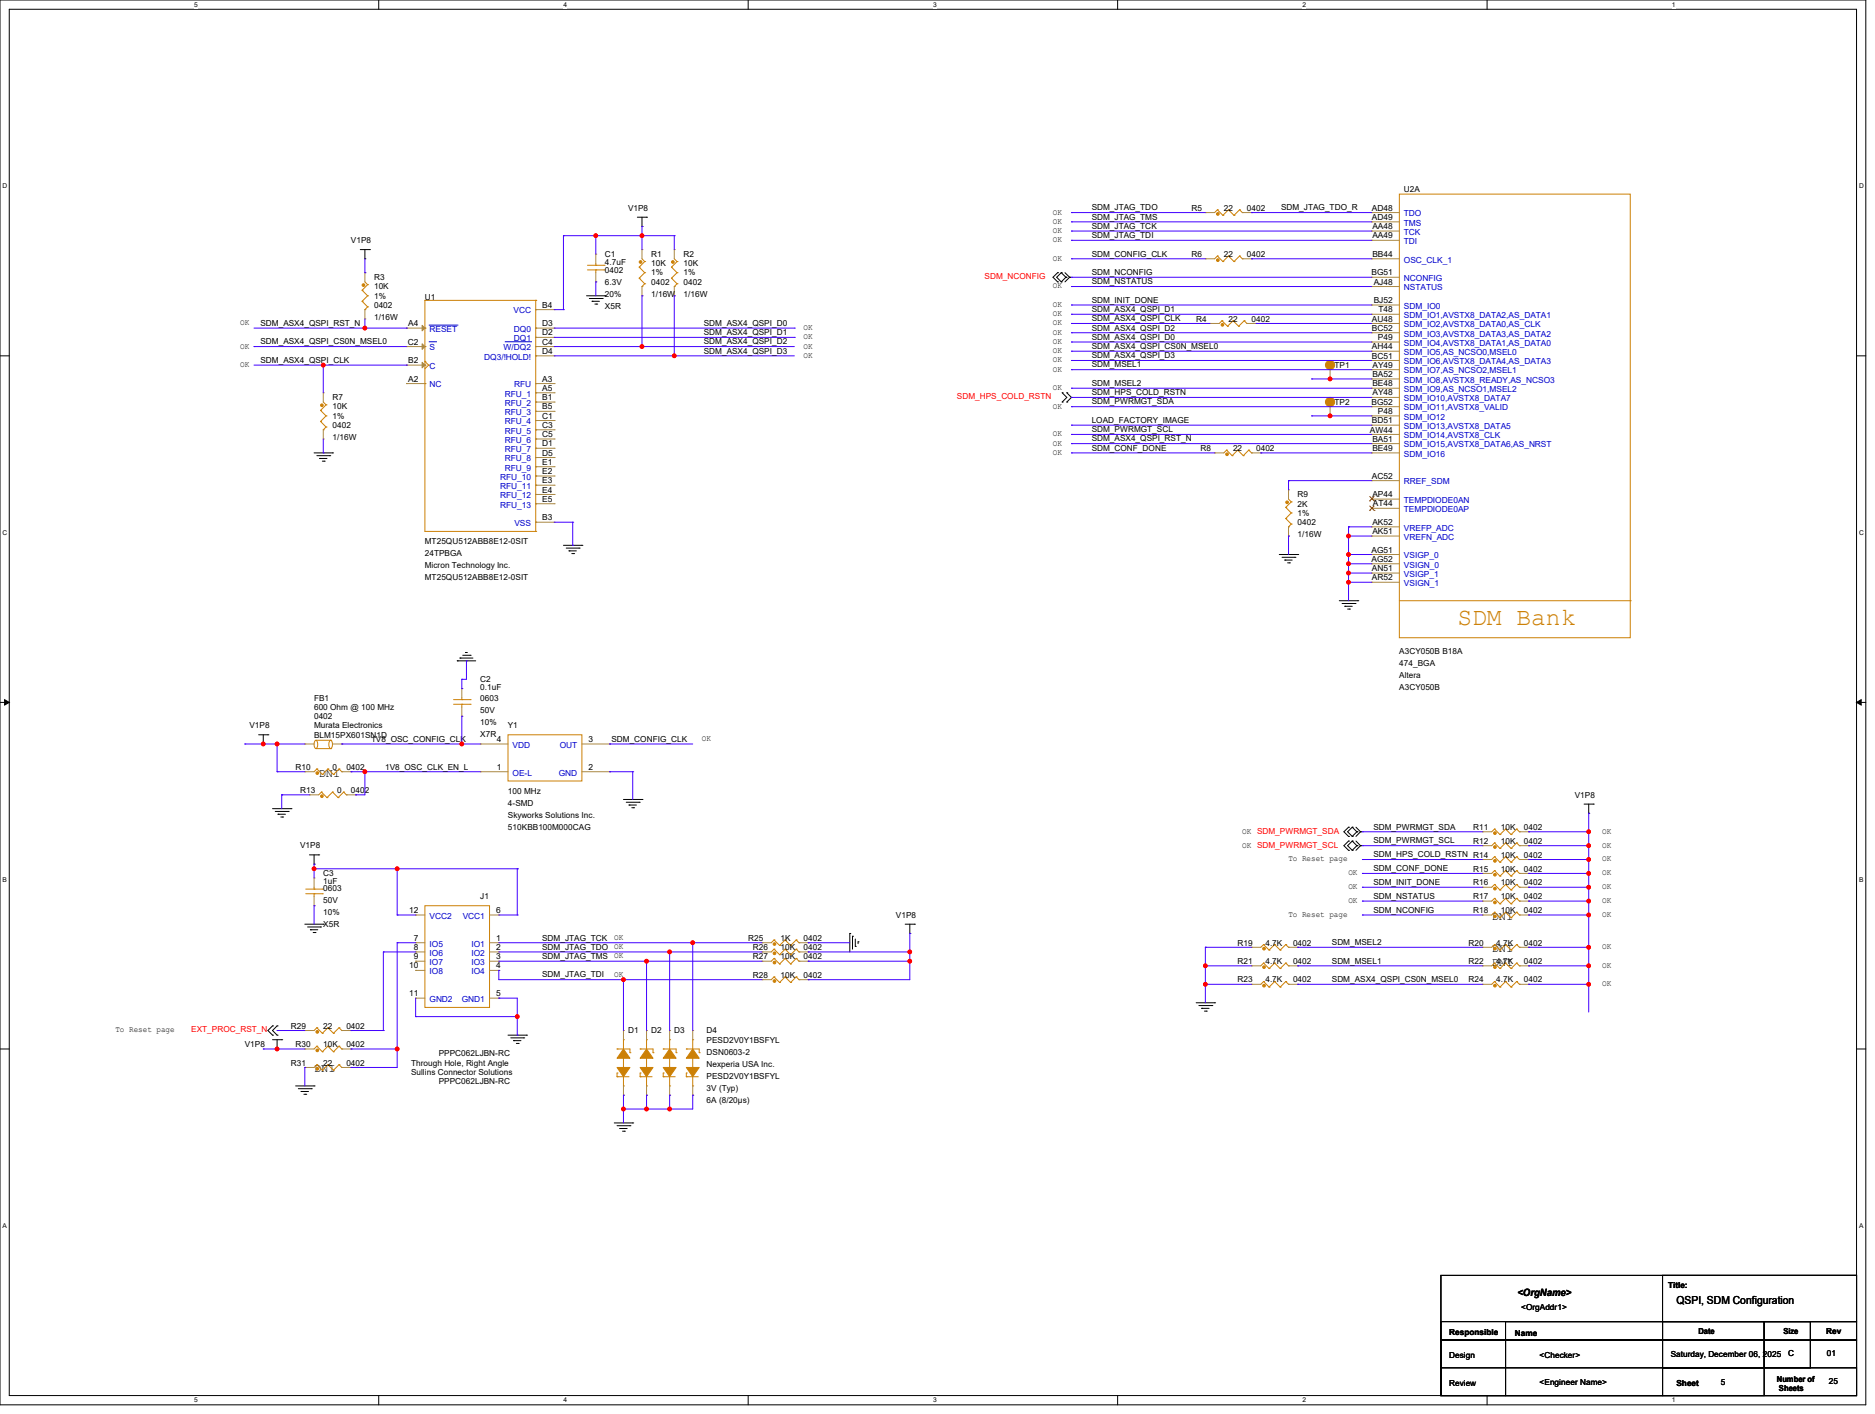
[picture p9: page 5]

Through Hole, Right Angle
Sullins Connector Solutions

QSPI, SDM Configuration <OrgName>
<OrgAddr1>

# Bank 3A, 1.1V

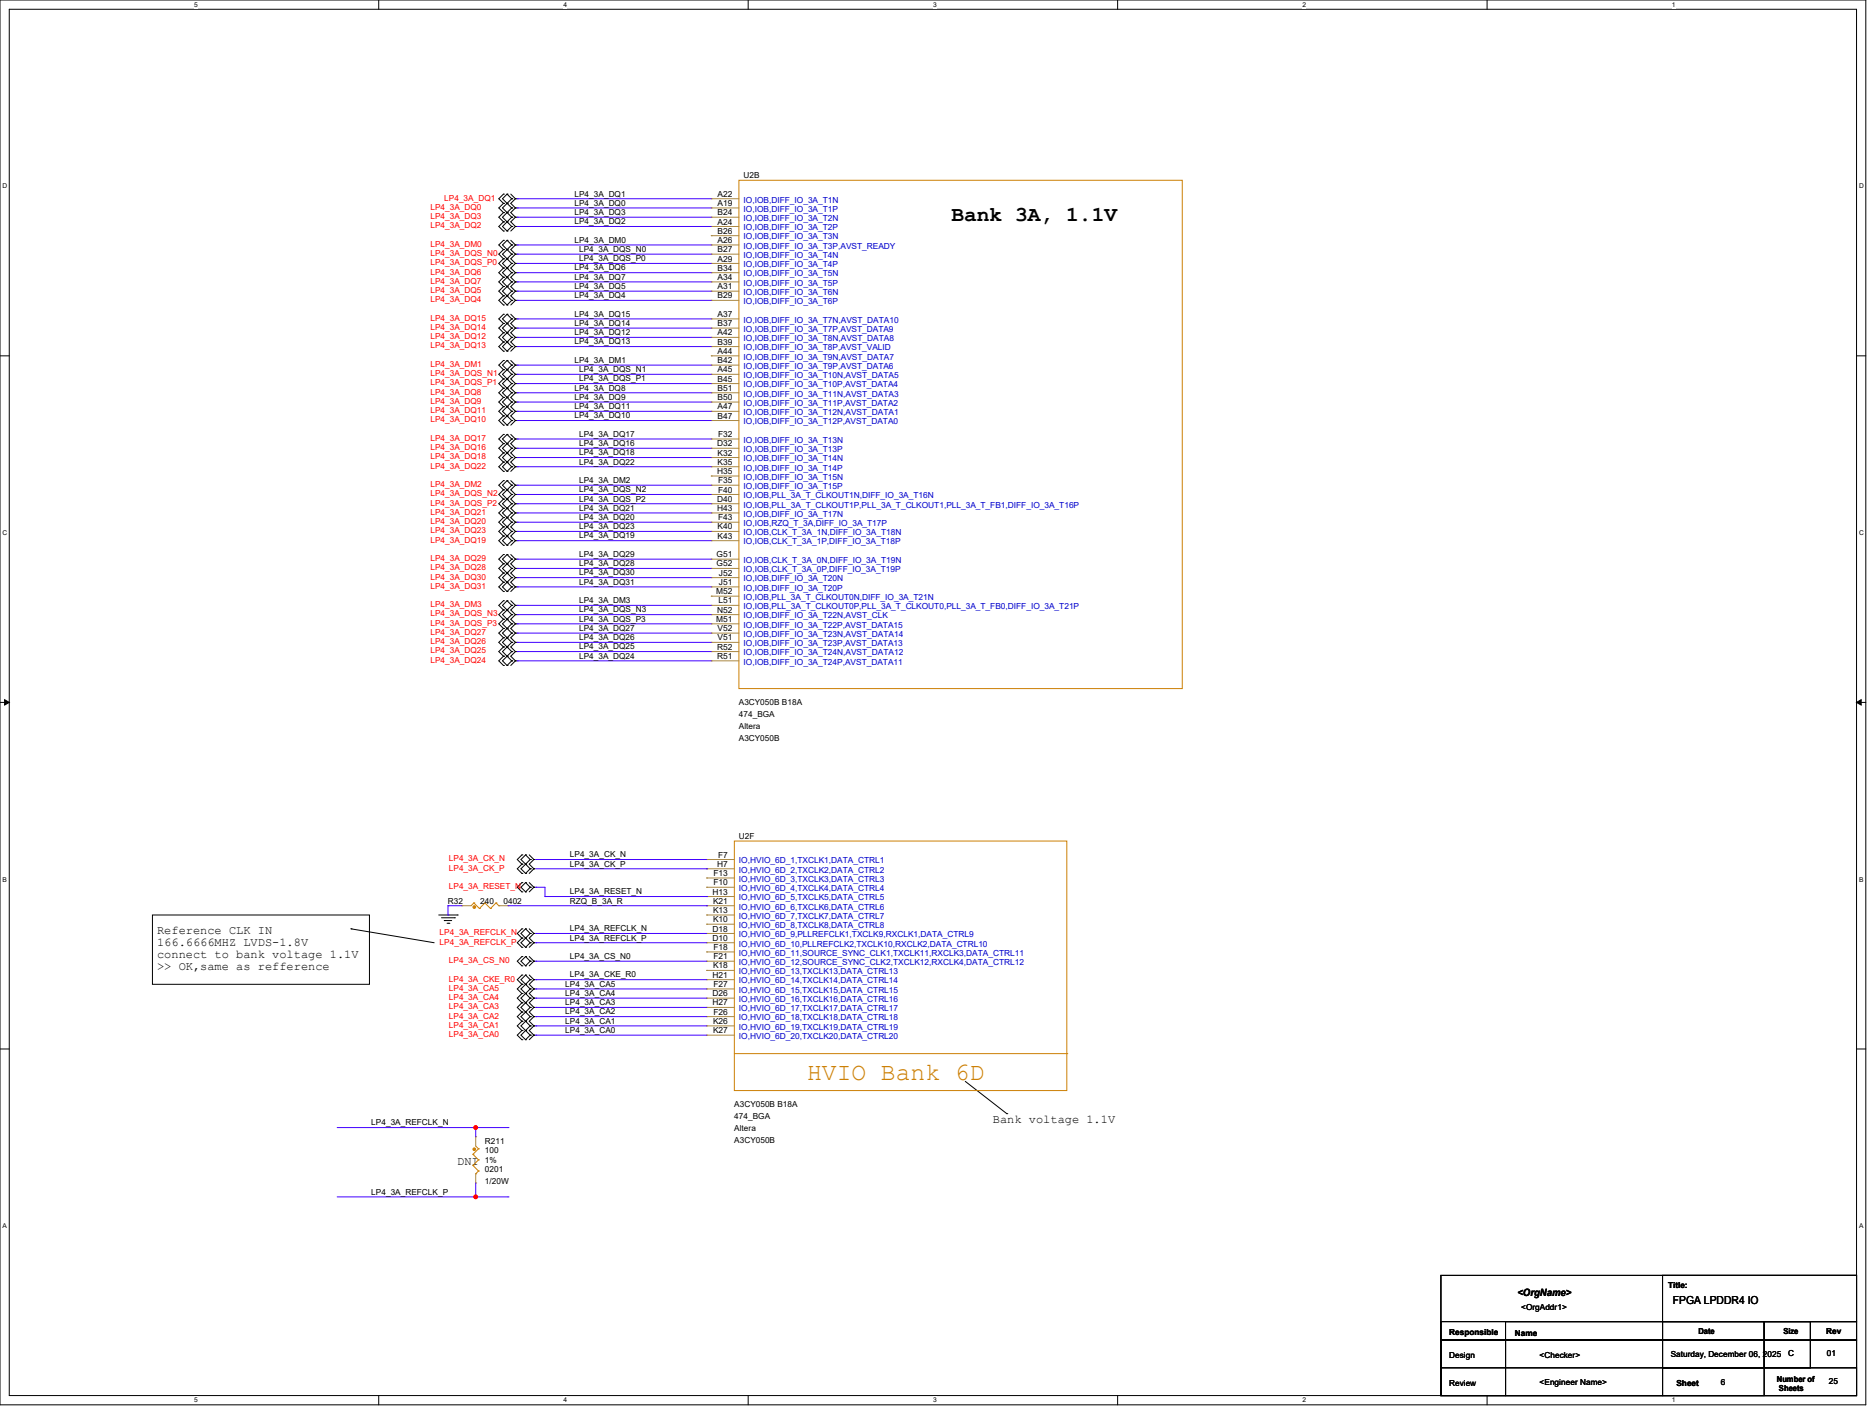
[picture p10: page 6]

Reference CLK IN
166.6666MHZ LVDS-1.8V
connect to bank voltage 1.1V
>> OK,same as refference

## HVIO Bank 6E

## HVIO Bank 6A

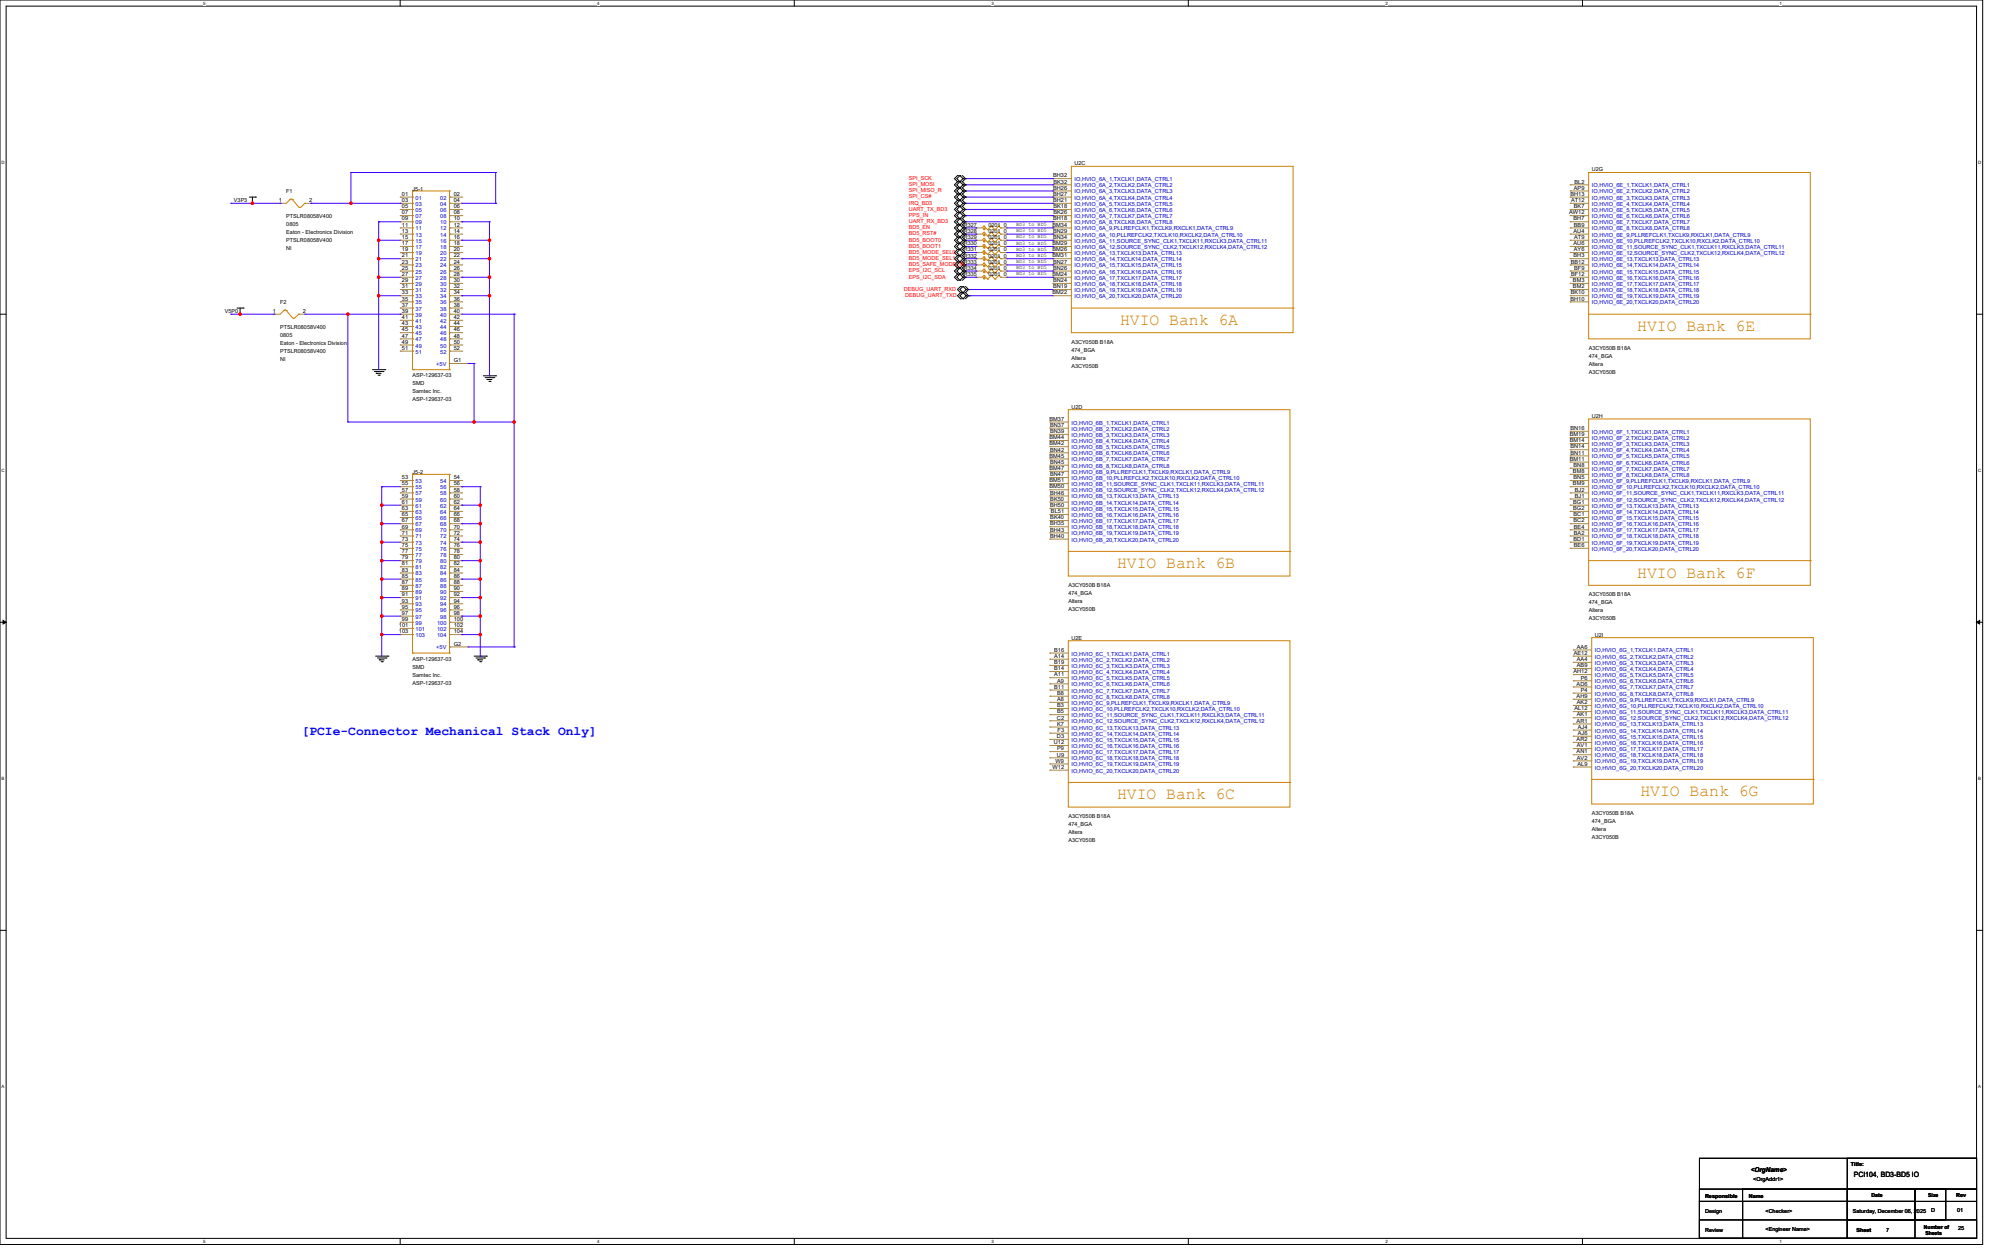
[picture p11: page 7]

[PCIe-Connector Mechanical Stack Only]

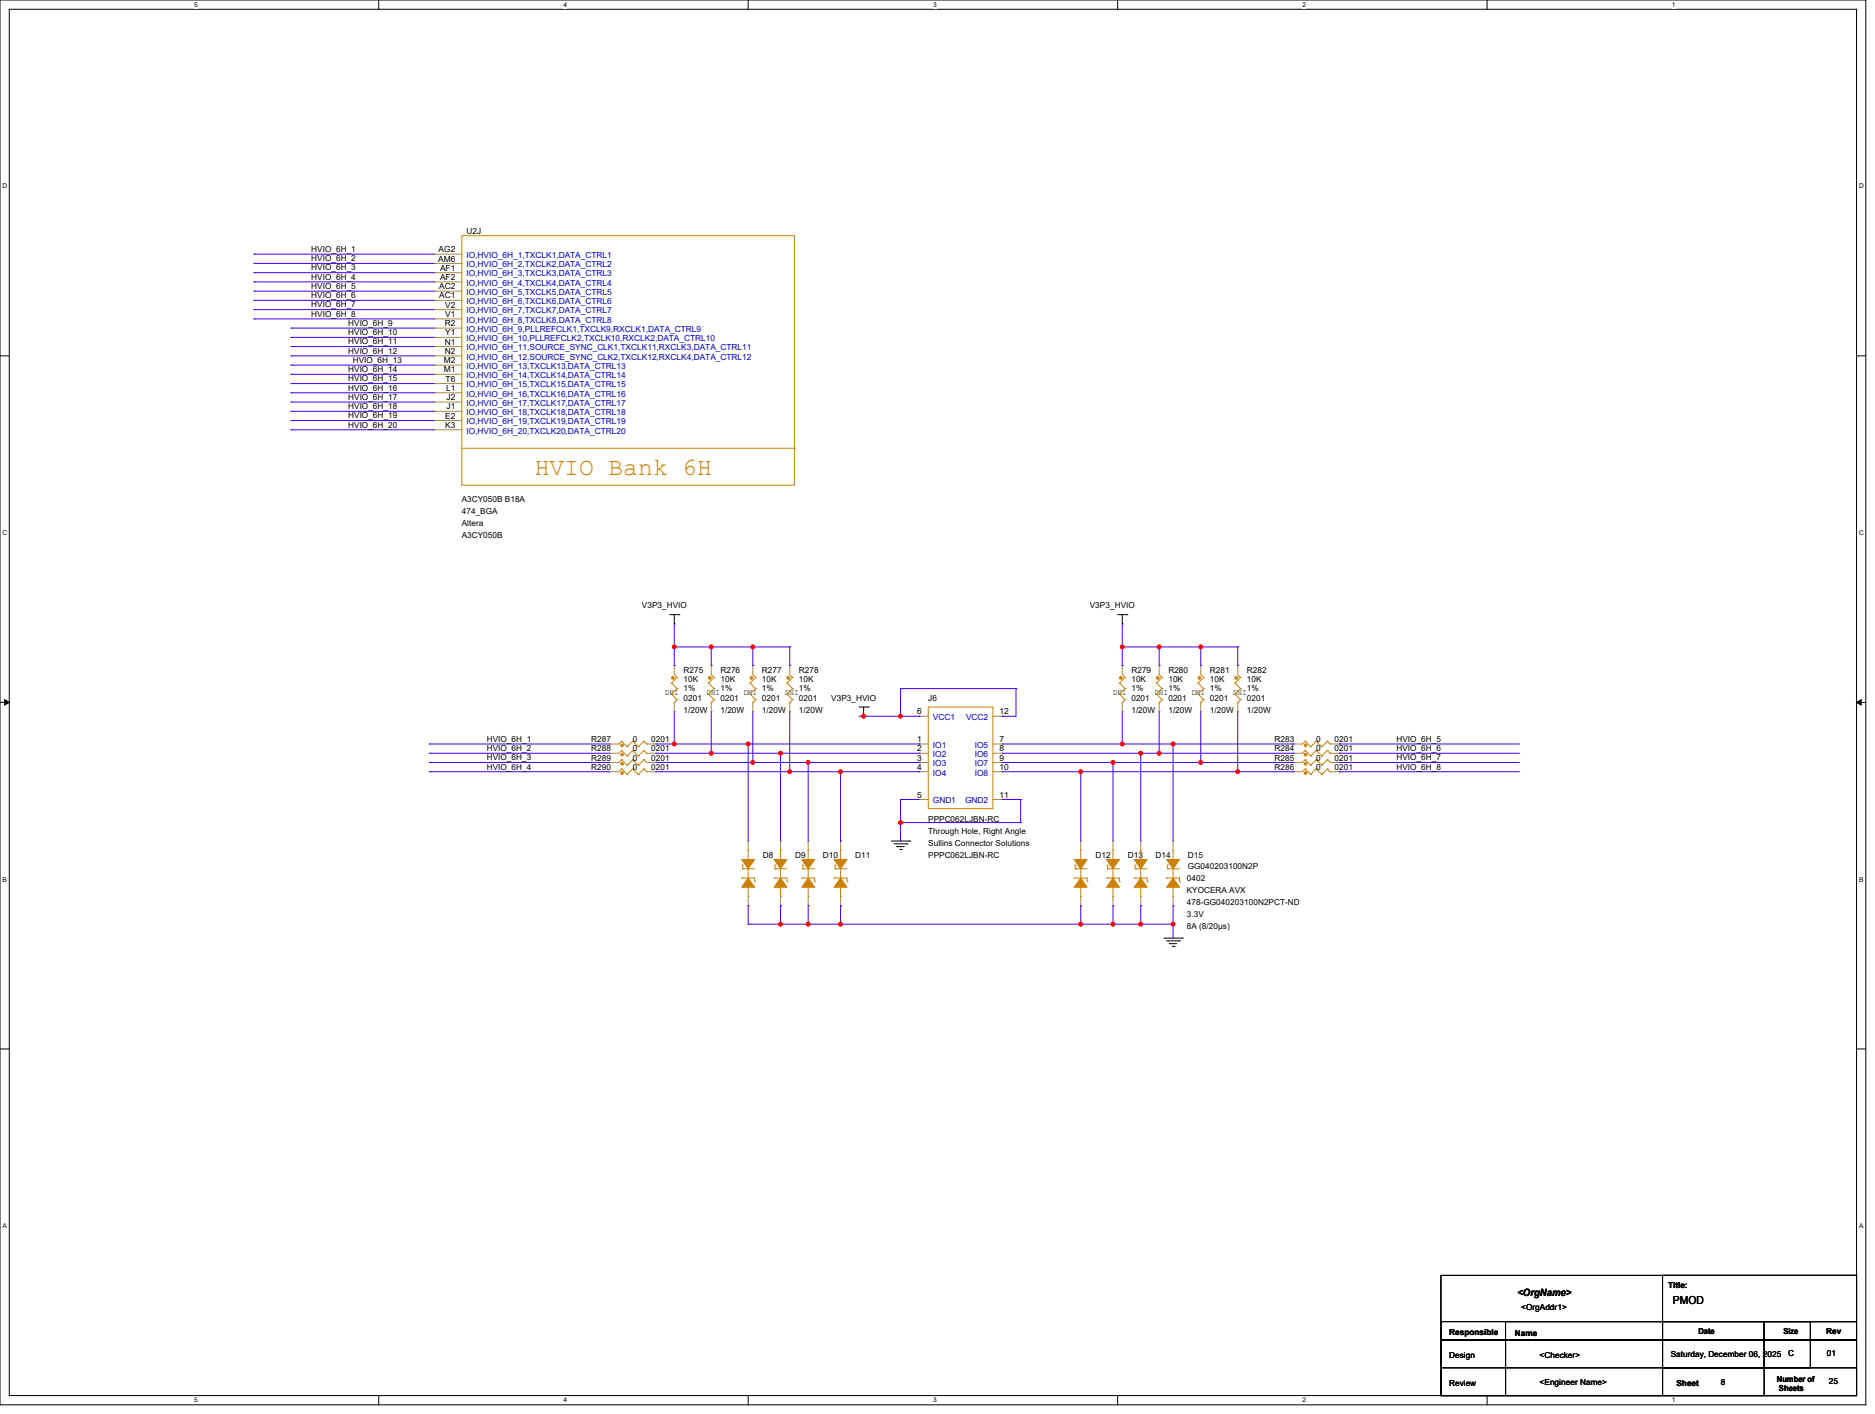
[picture p12: page 8]

PPPC062LJBN-RC
Through Hole, Right Angle
Sullins Connector Solutions

## Power supply from BD5 to BD3

### V3P3_HVIO

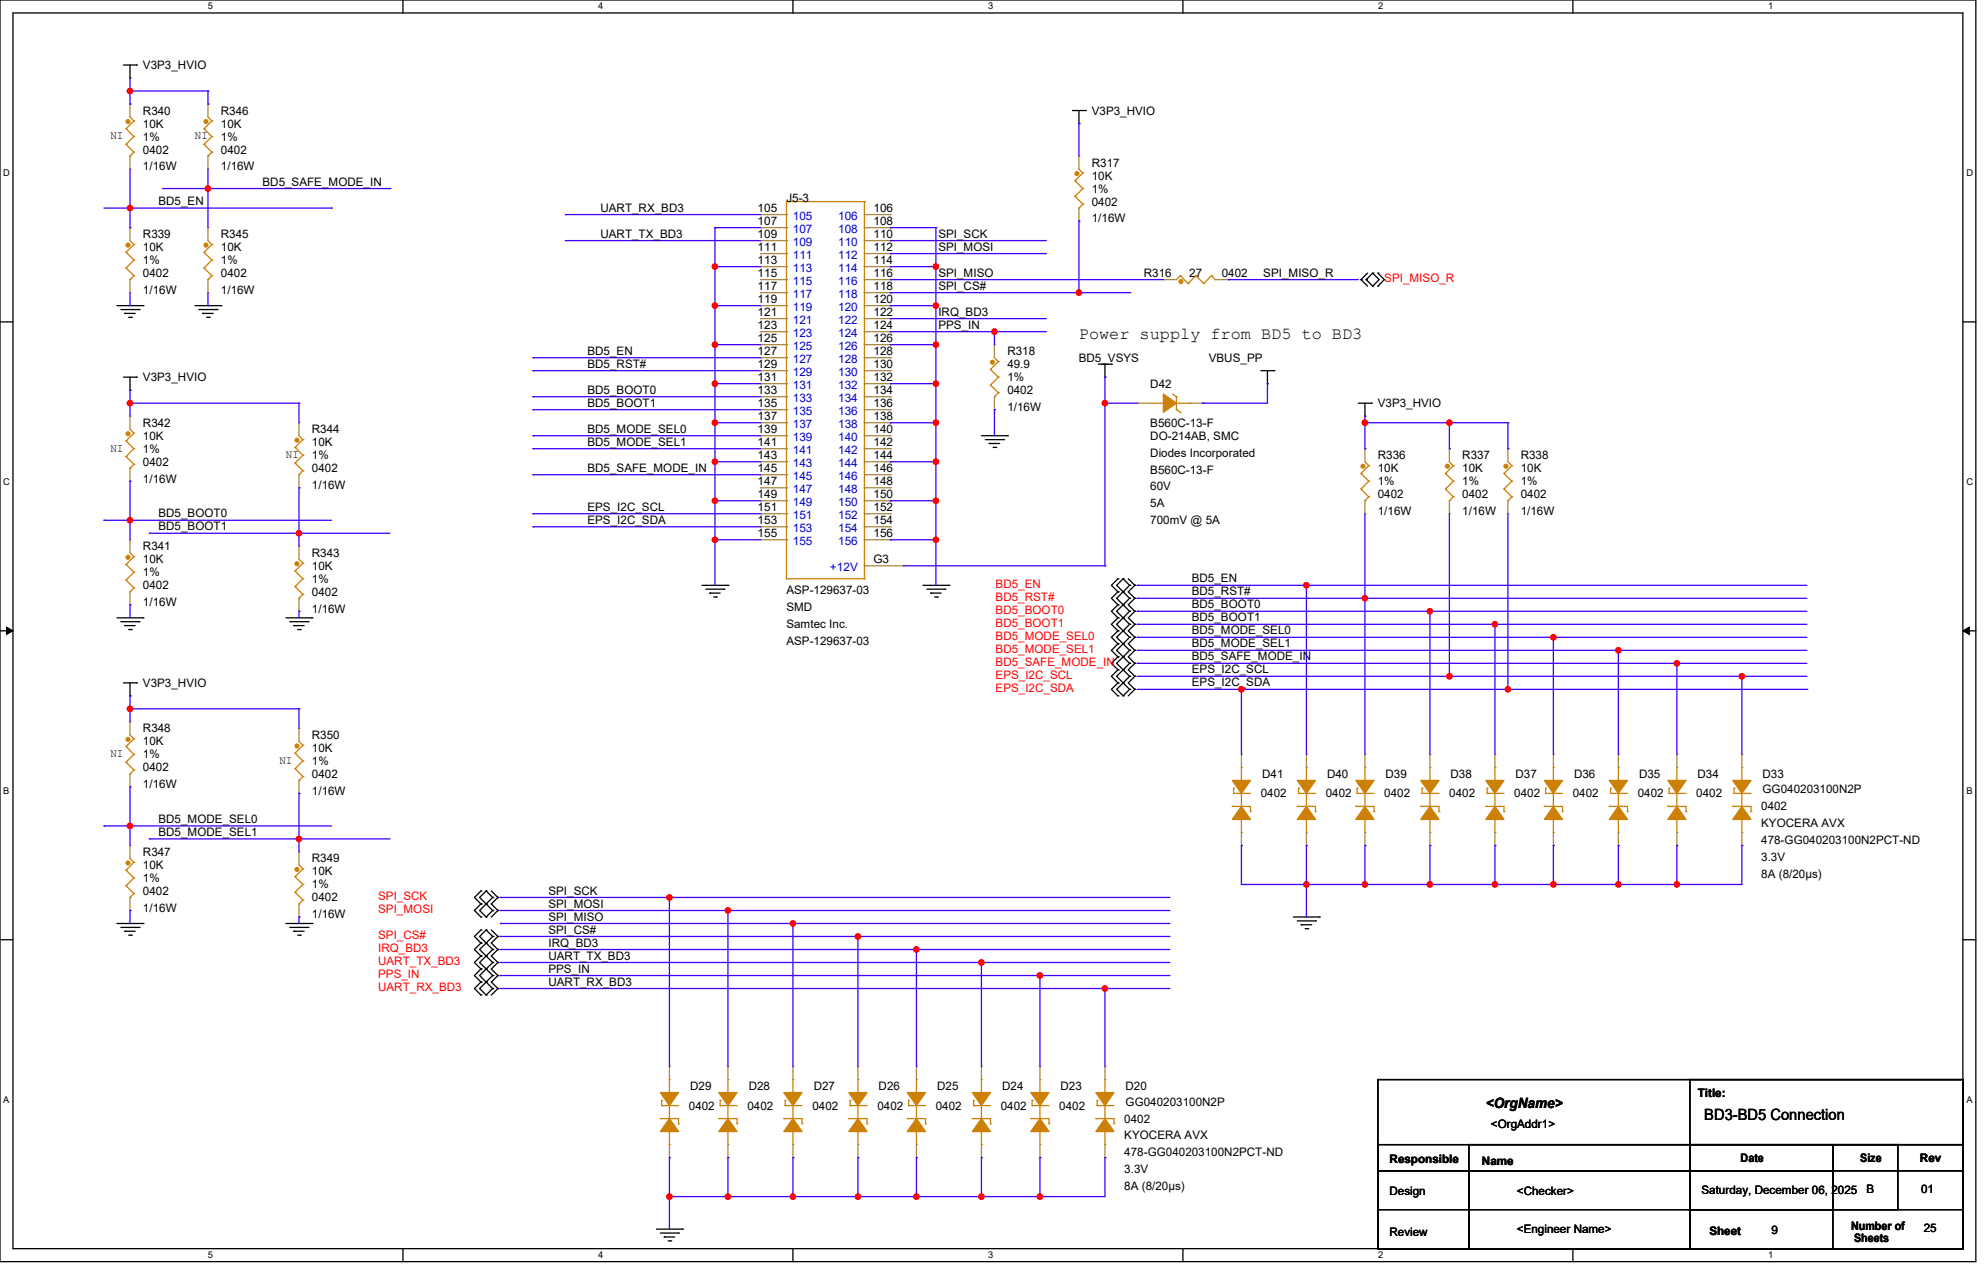
[picture p13: page 9]

R321
5.1K

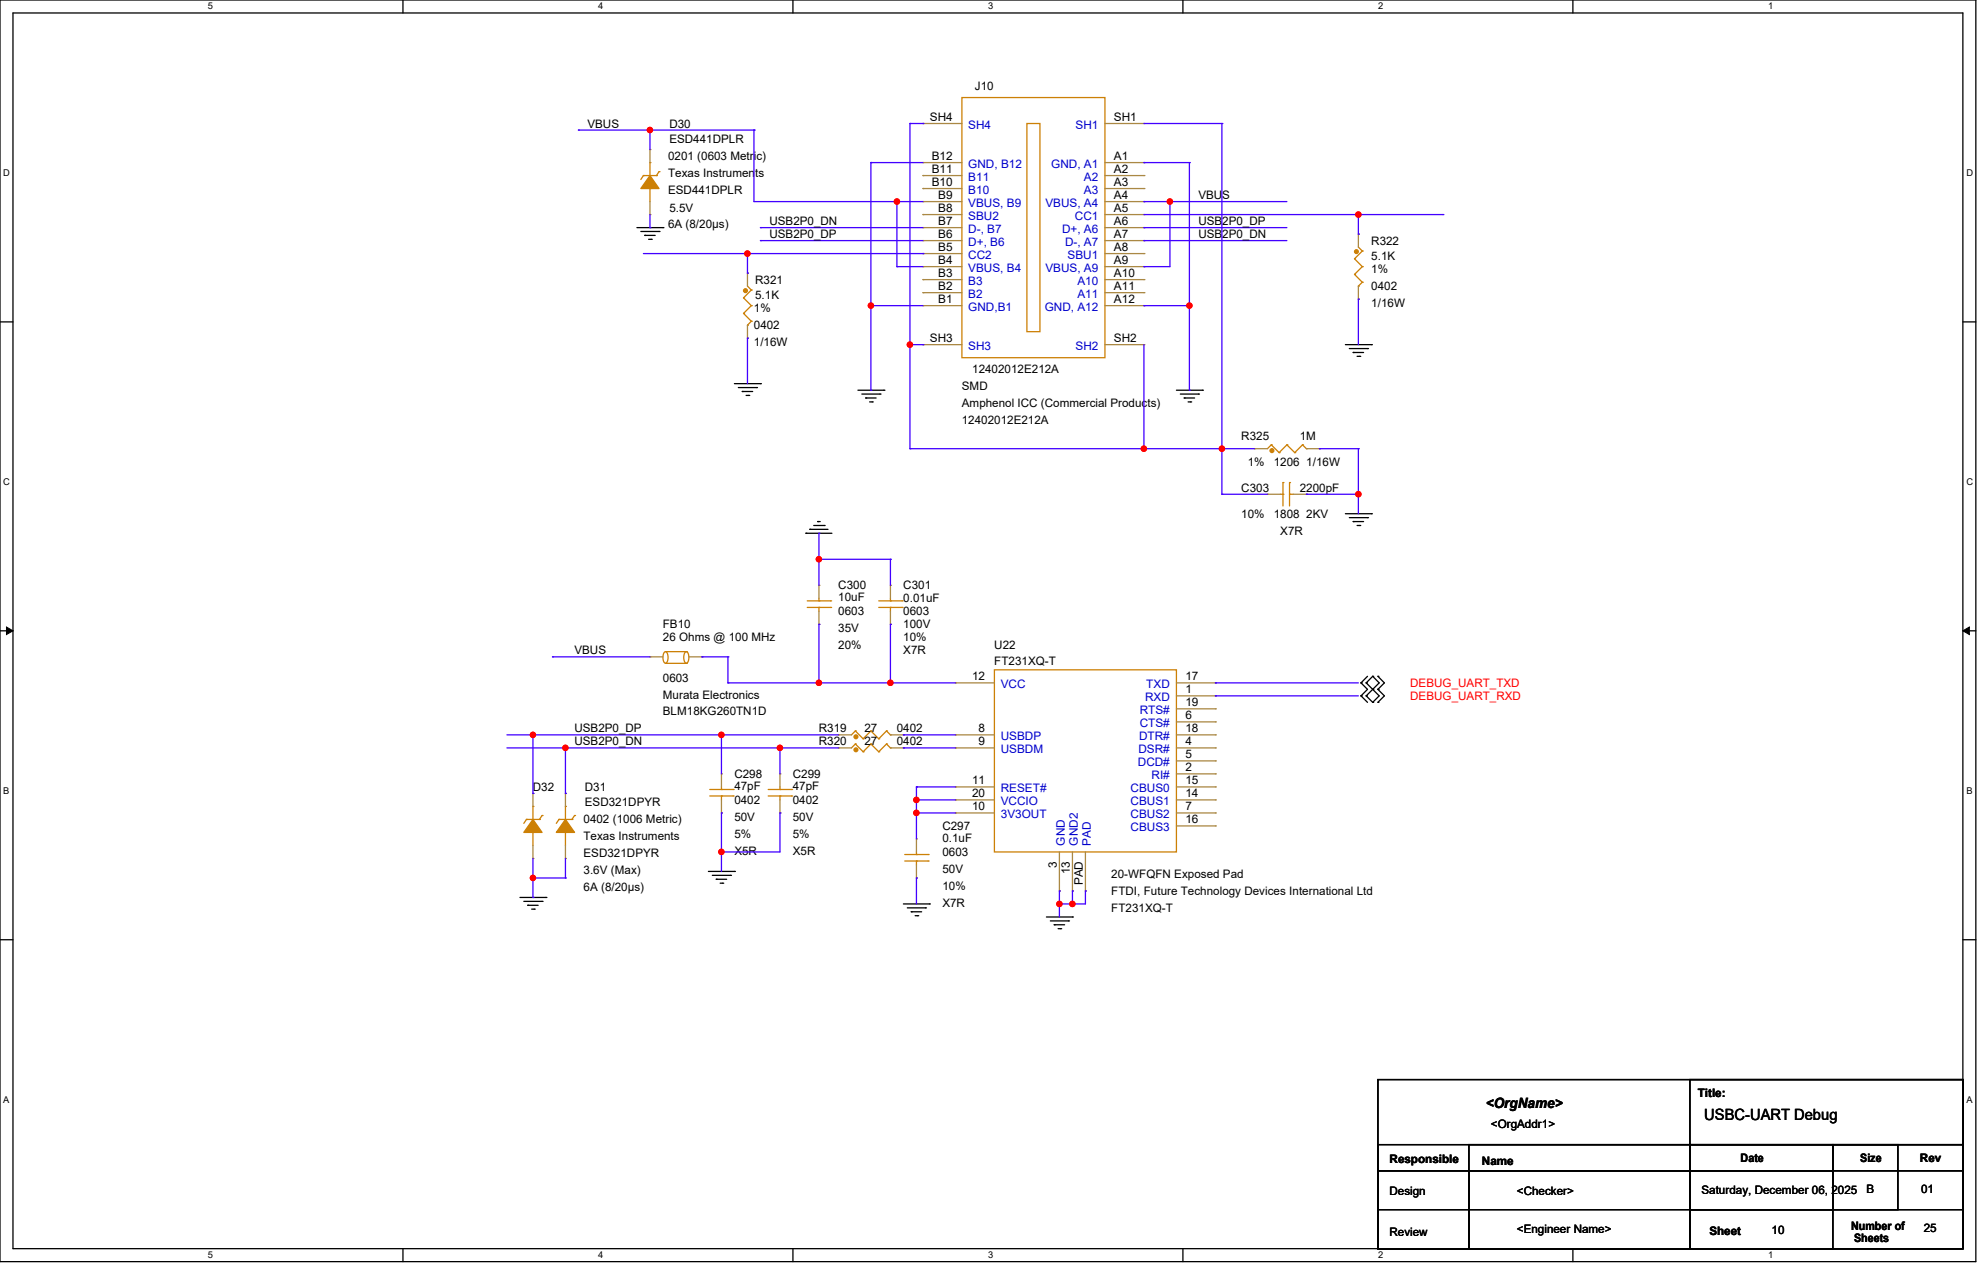
[picture p14: page 10]

20-WFQFN Exposed Pad
FTDI, Future Technology Devices International Ltd

USBC-UART Debug <OrgName>

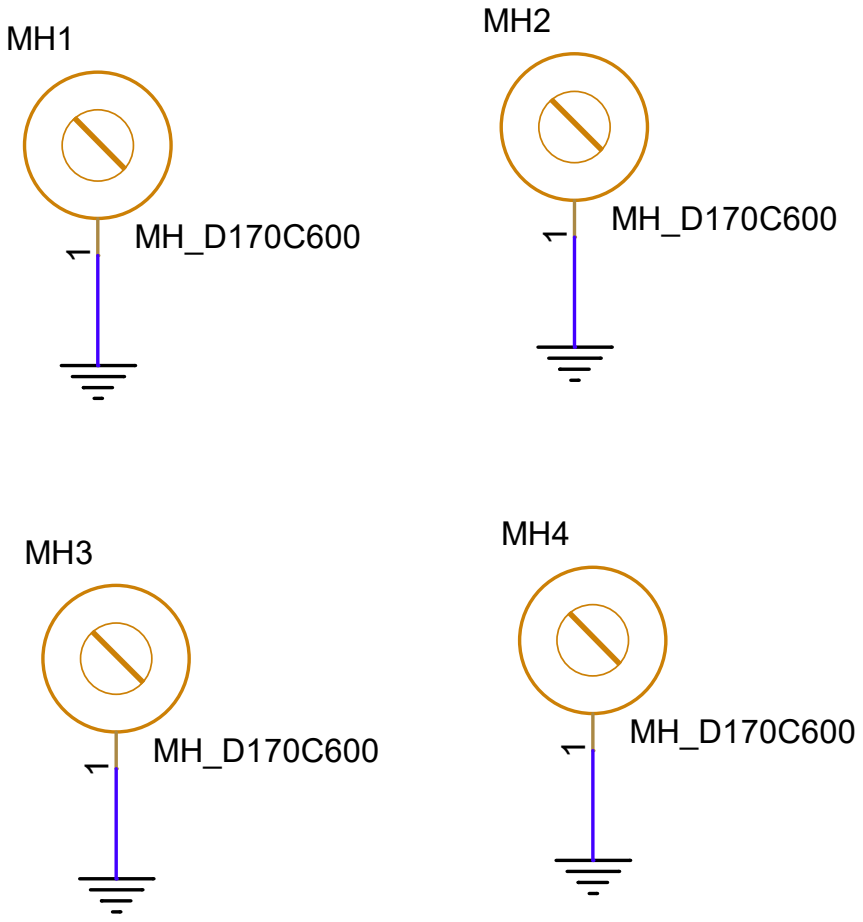
[picture p15: page 11]
Title: Mechanical <OrgName>

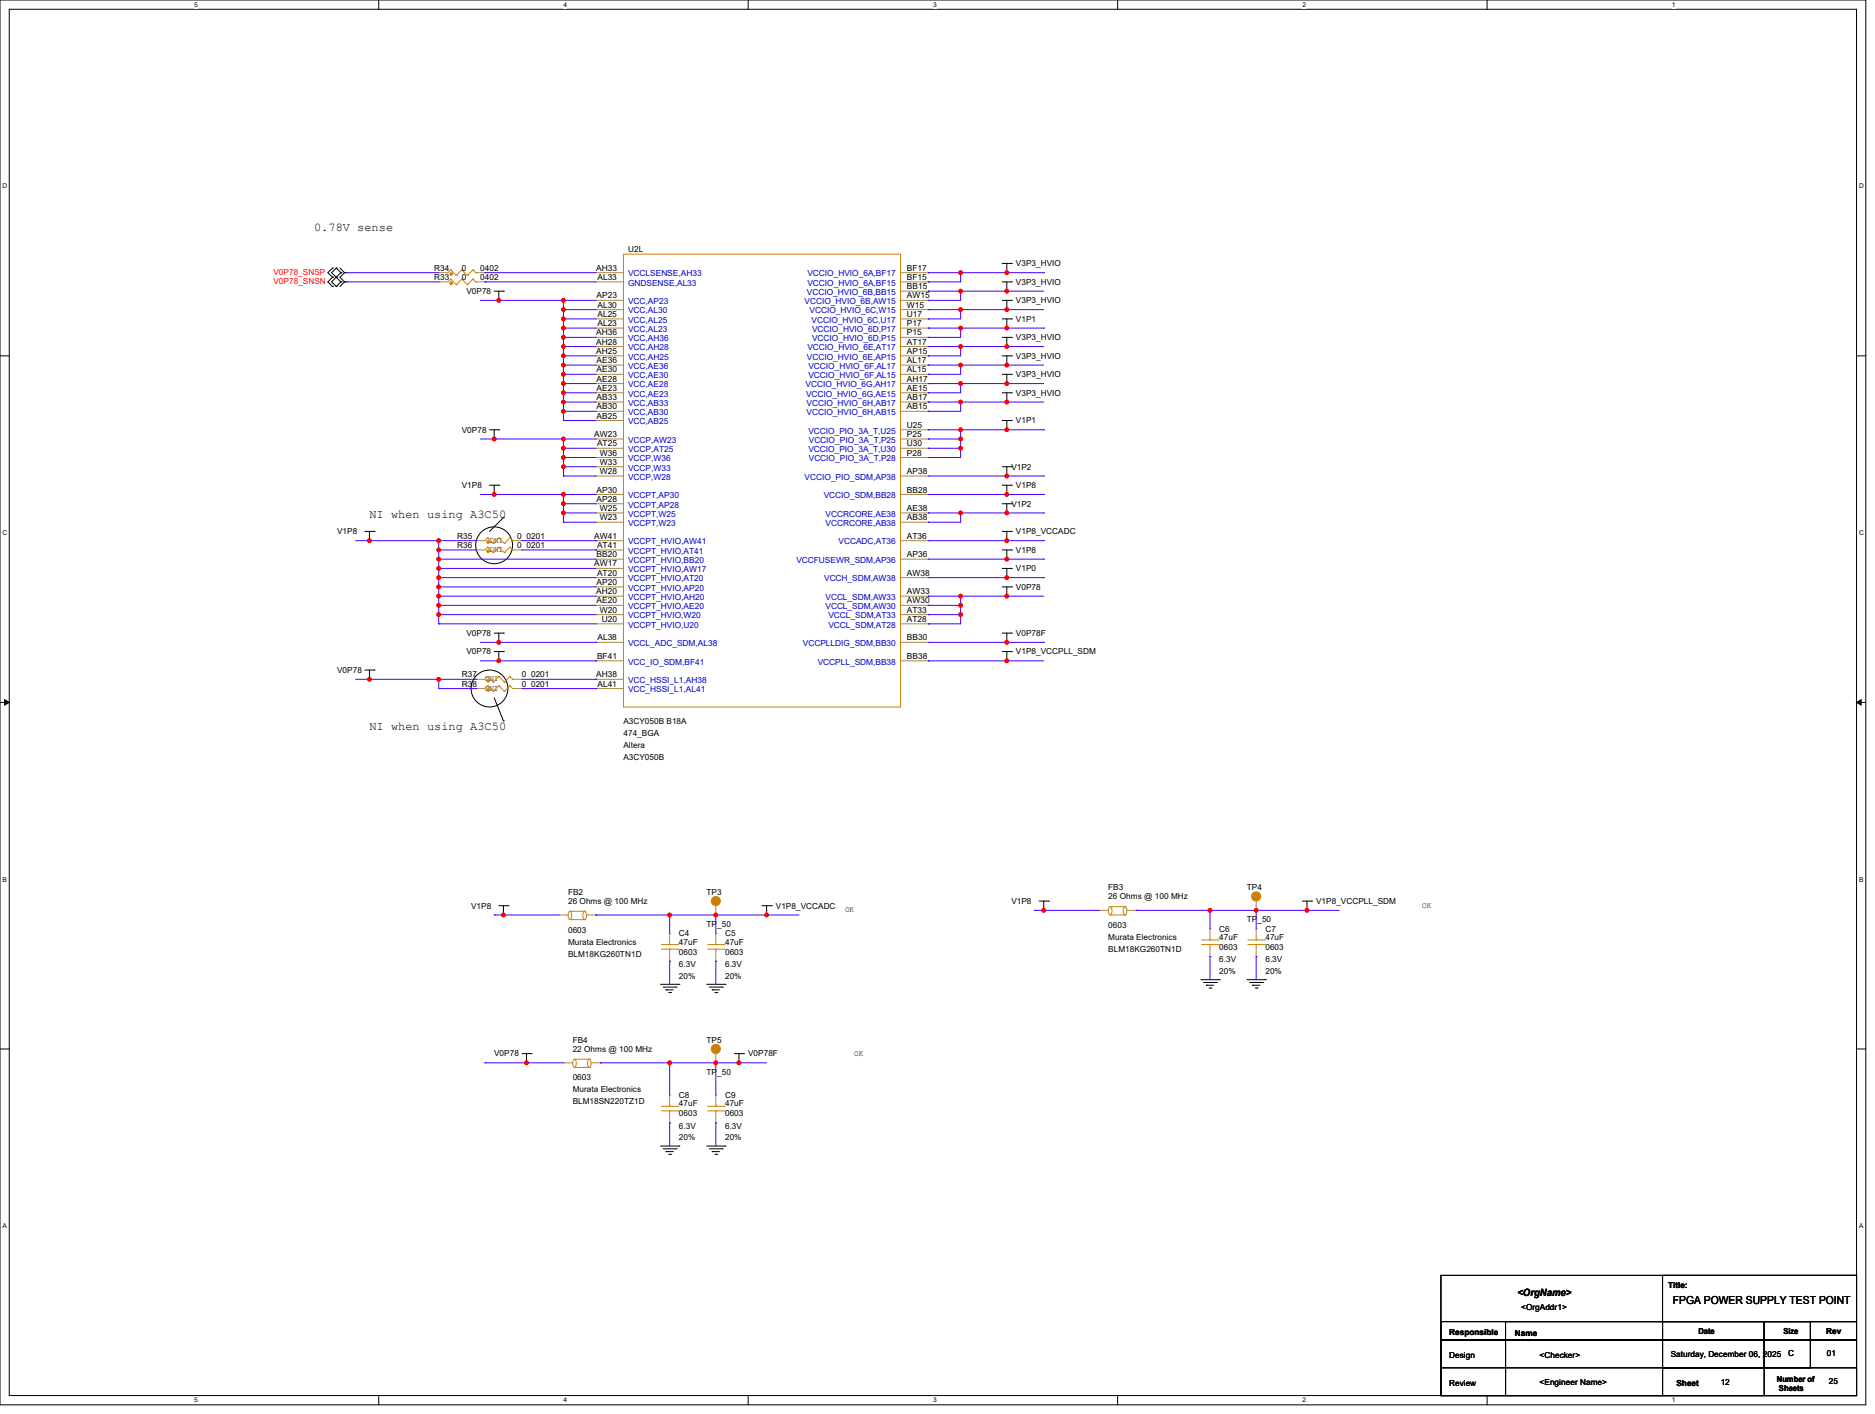
[picture p16: page 12]

FPGA POWER SUPPLY TEST POINT <OrgName>

U2K

### DNU,AV52 AV52

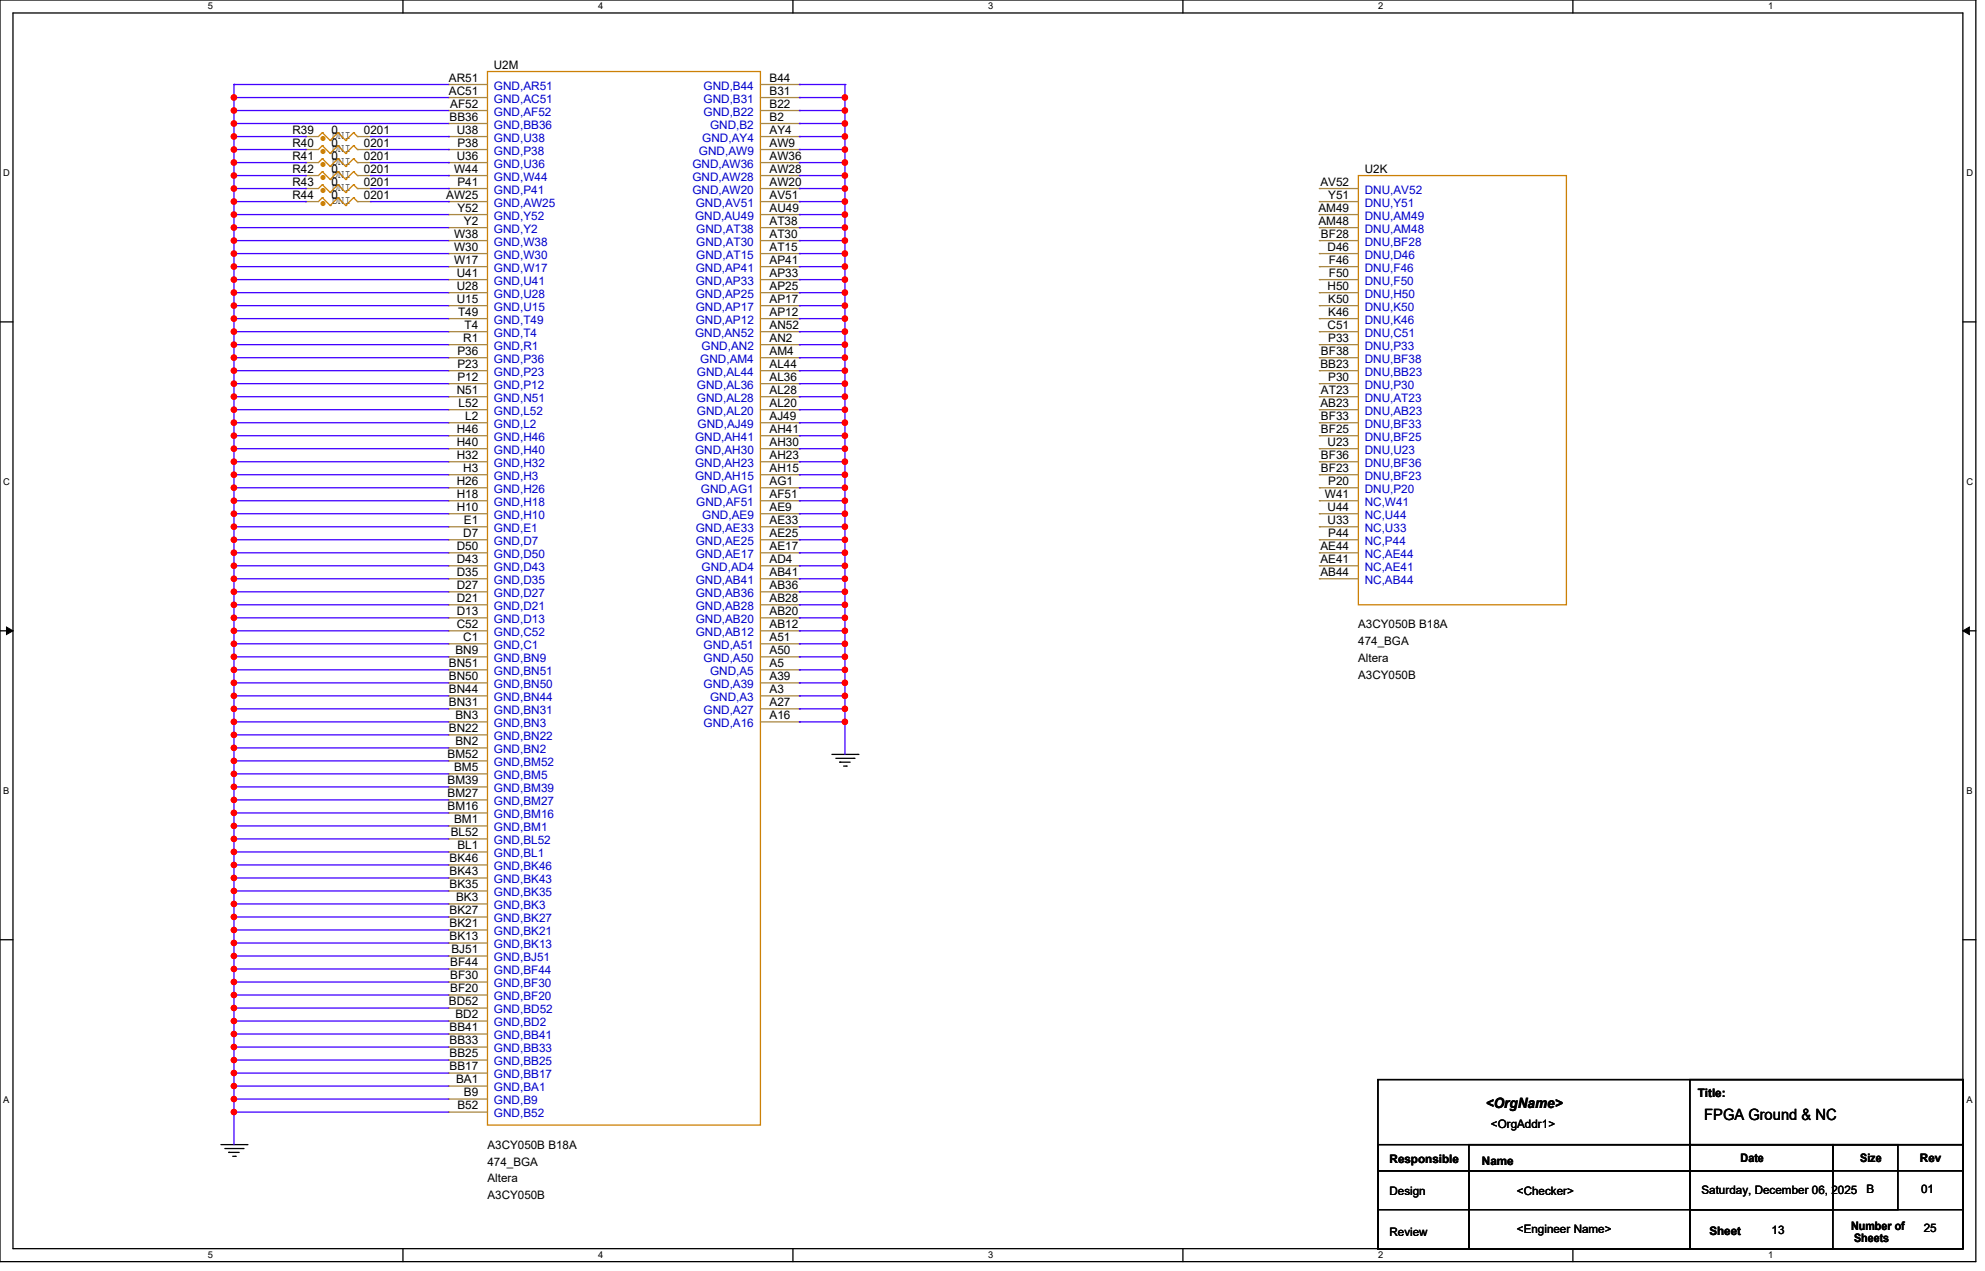
[picture p17: page 13]

FPGA Ground & NC <OrgName>

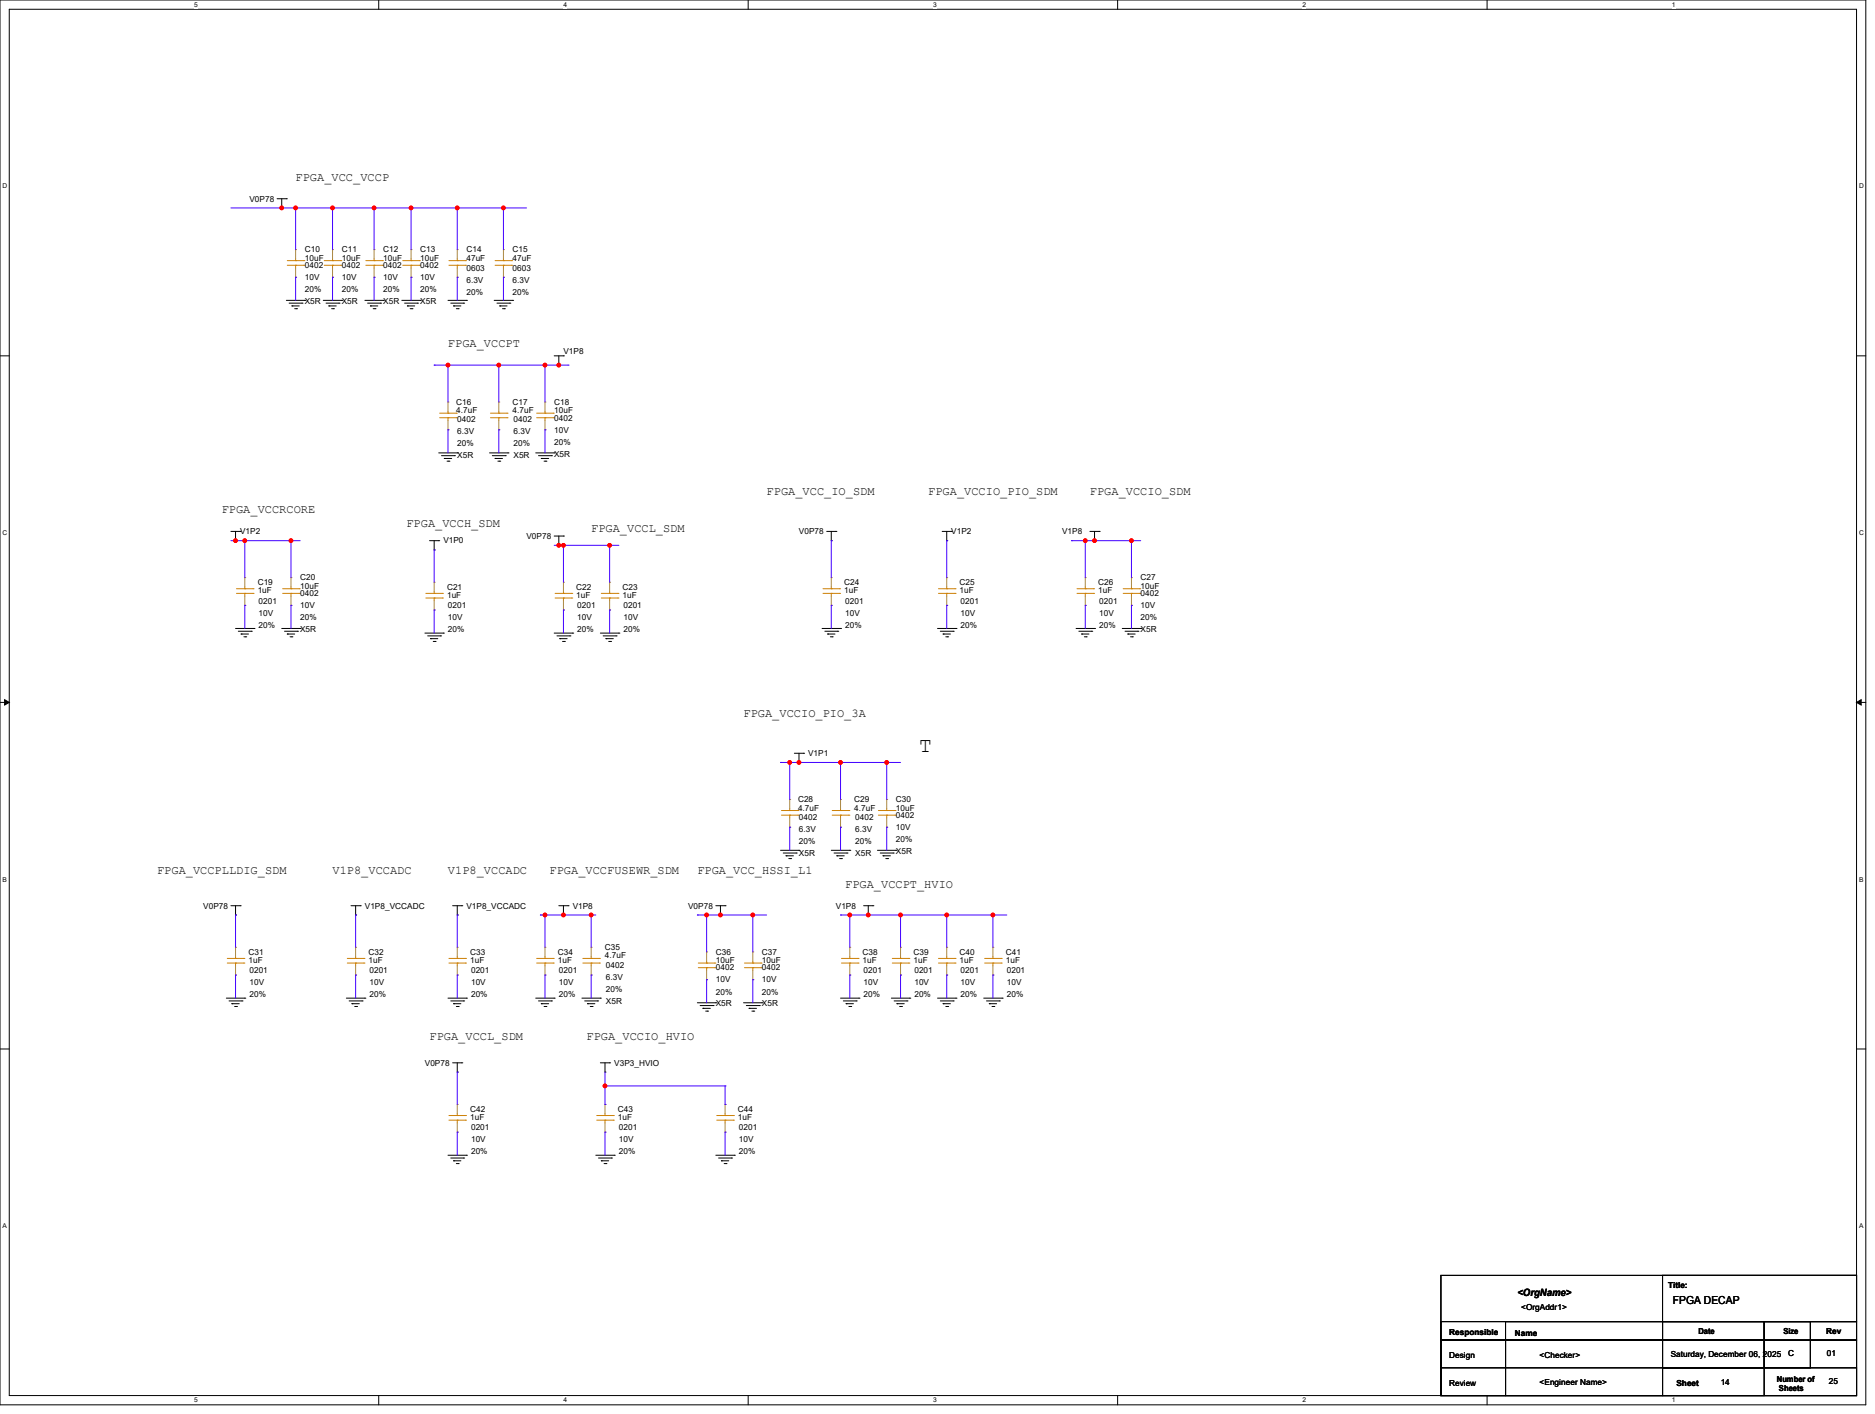
[picture p18: page 14]

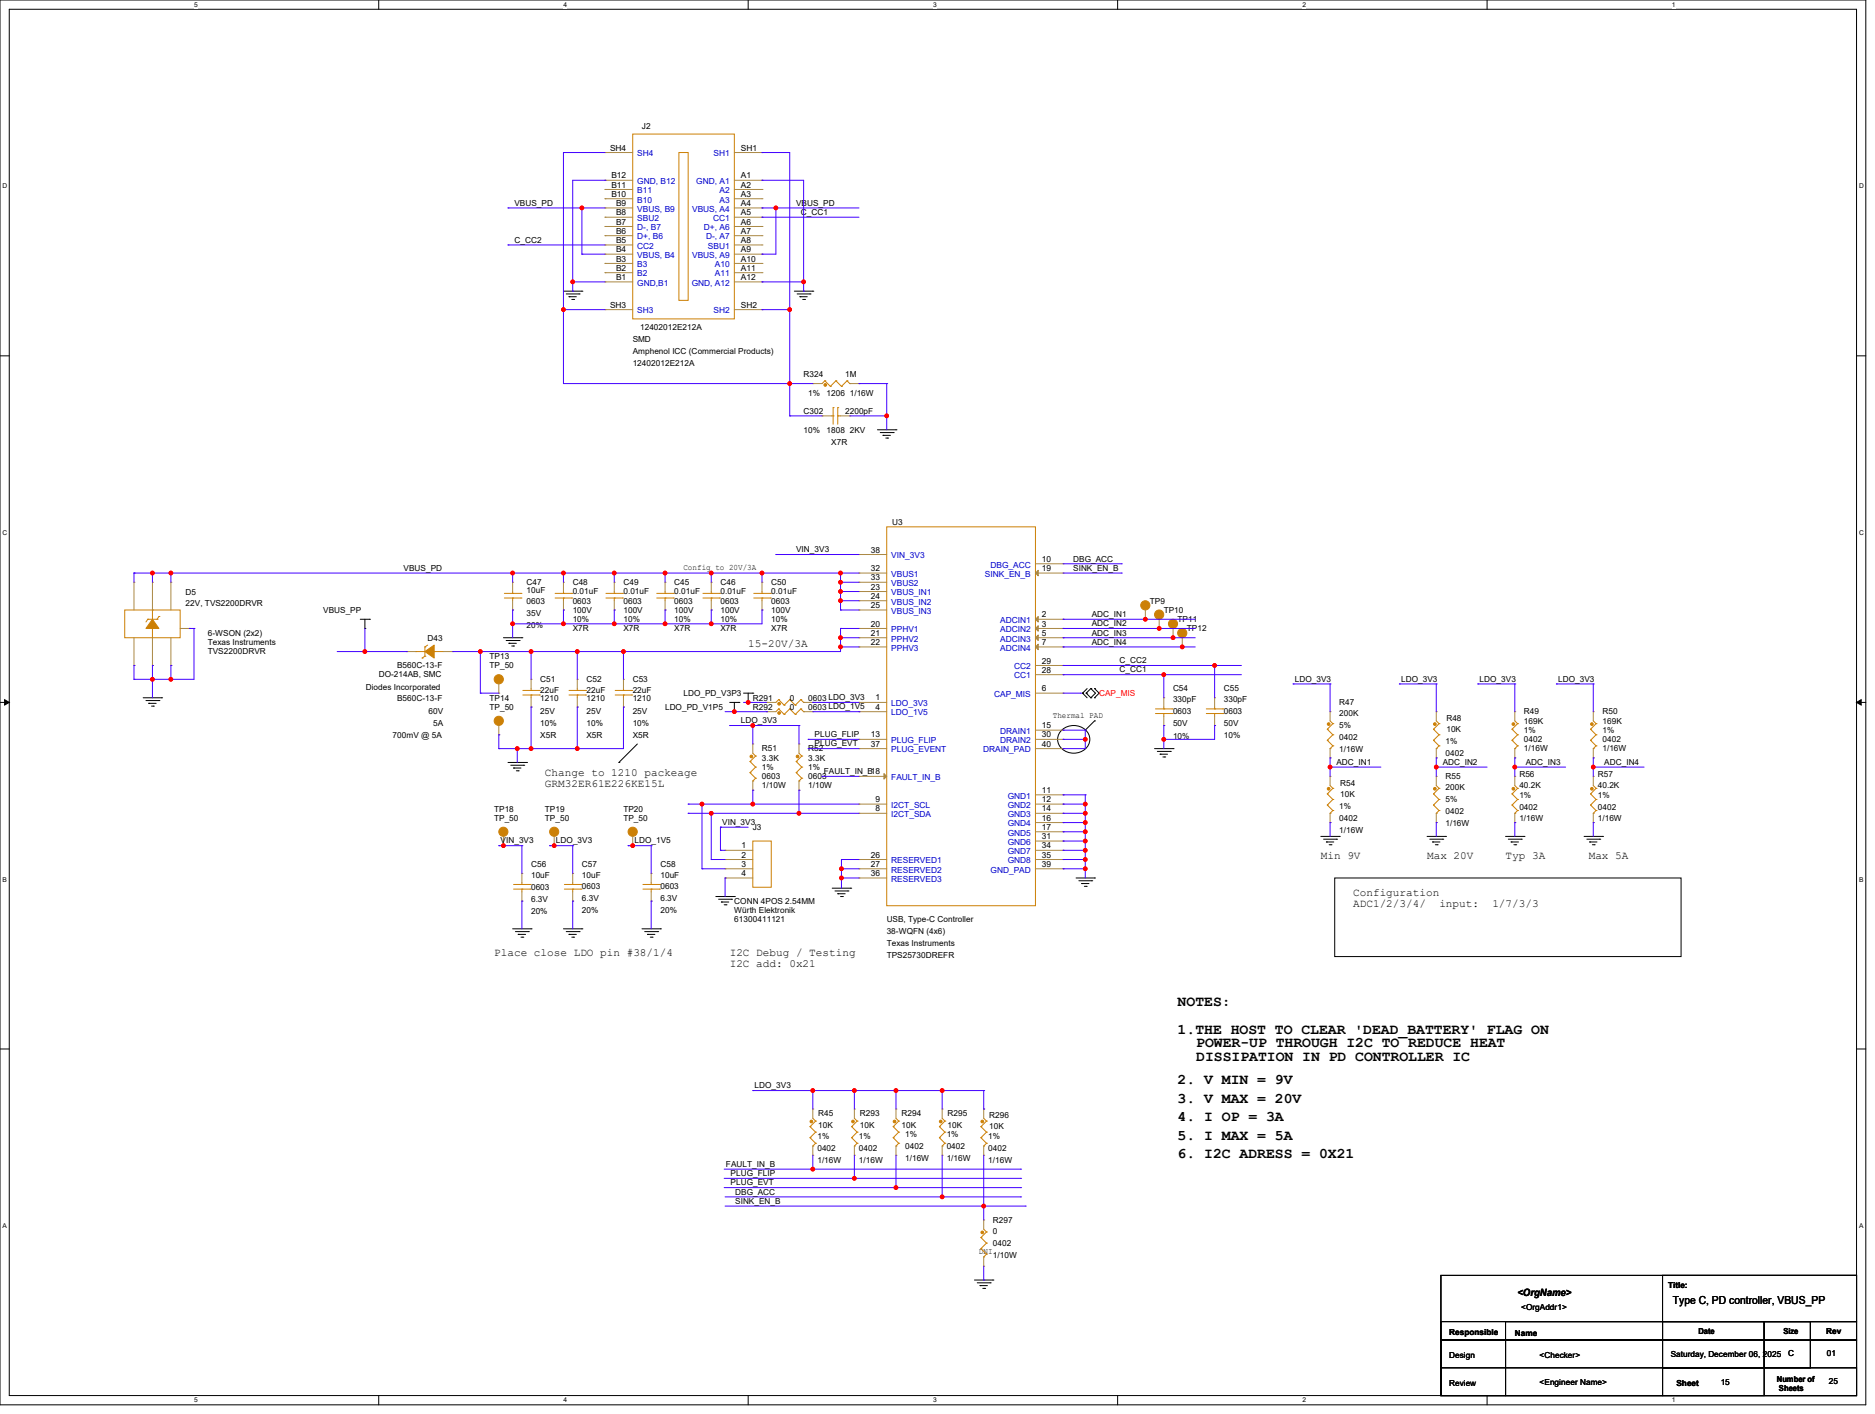
[picture p19: page 15]

Place close LDO pin #38/1/4

1.THE HOST TO CLEAR 'DEAD_BATTERY' FLAG ON POWER-UP THROUGH I2C TO REDUCE HEAT

DISSIPATION IN PD CONTROLLER IC

Type C, PD controller, VBUS_PP <OrgName>

### VBUS_PP

### VBUS_PP_SS

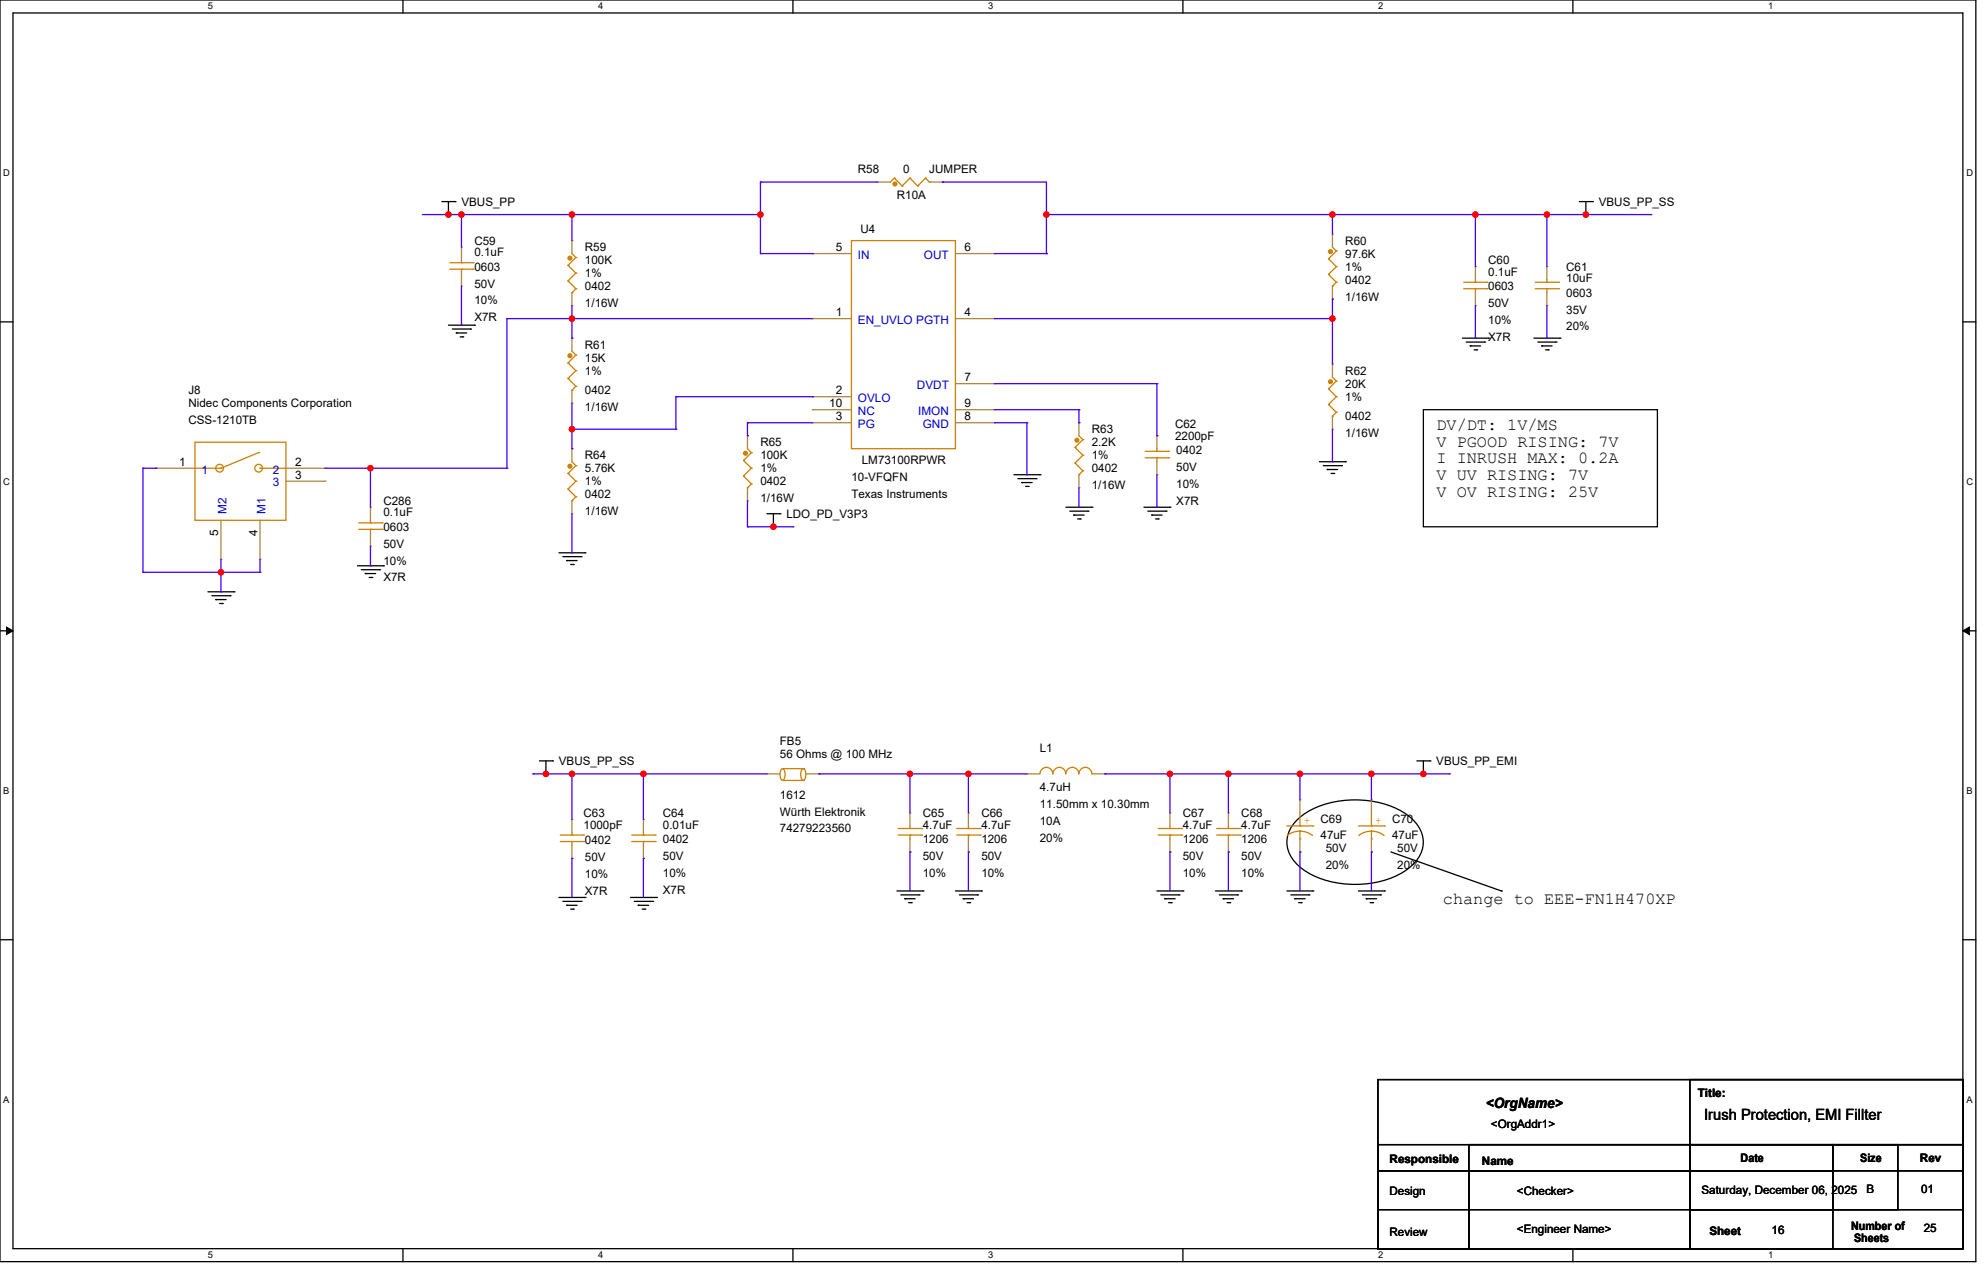
[picture p20: page 16]

Irush Protection, EMI Fillter <OrgName>

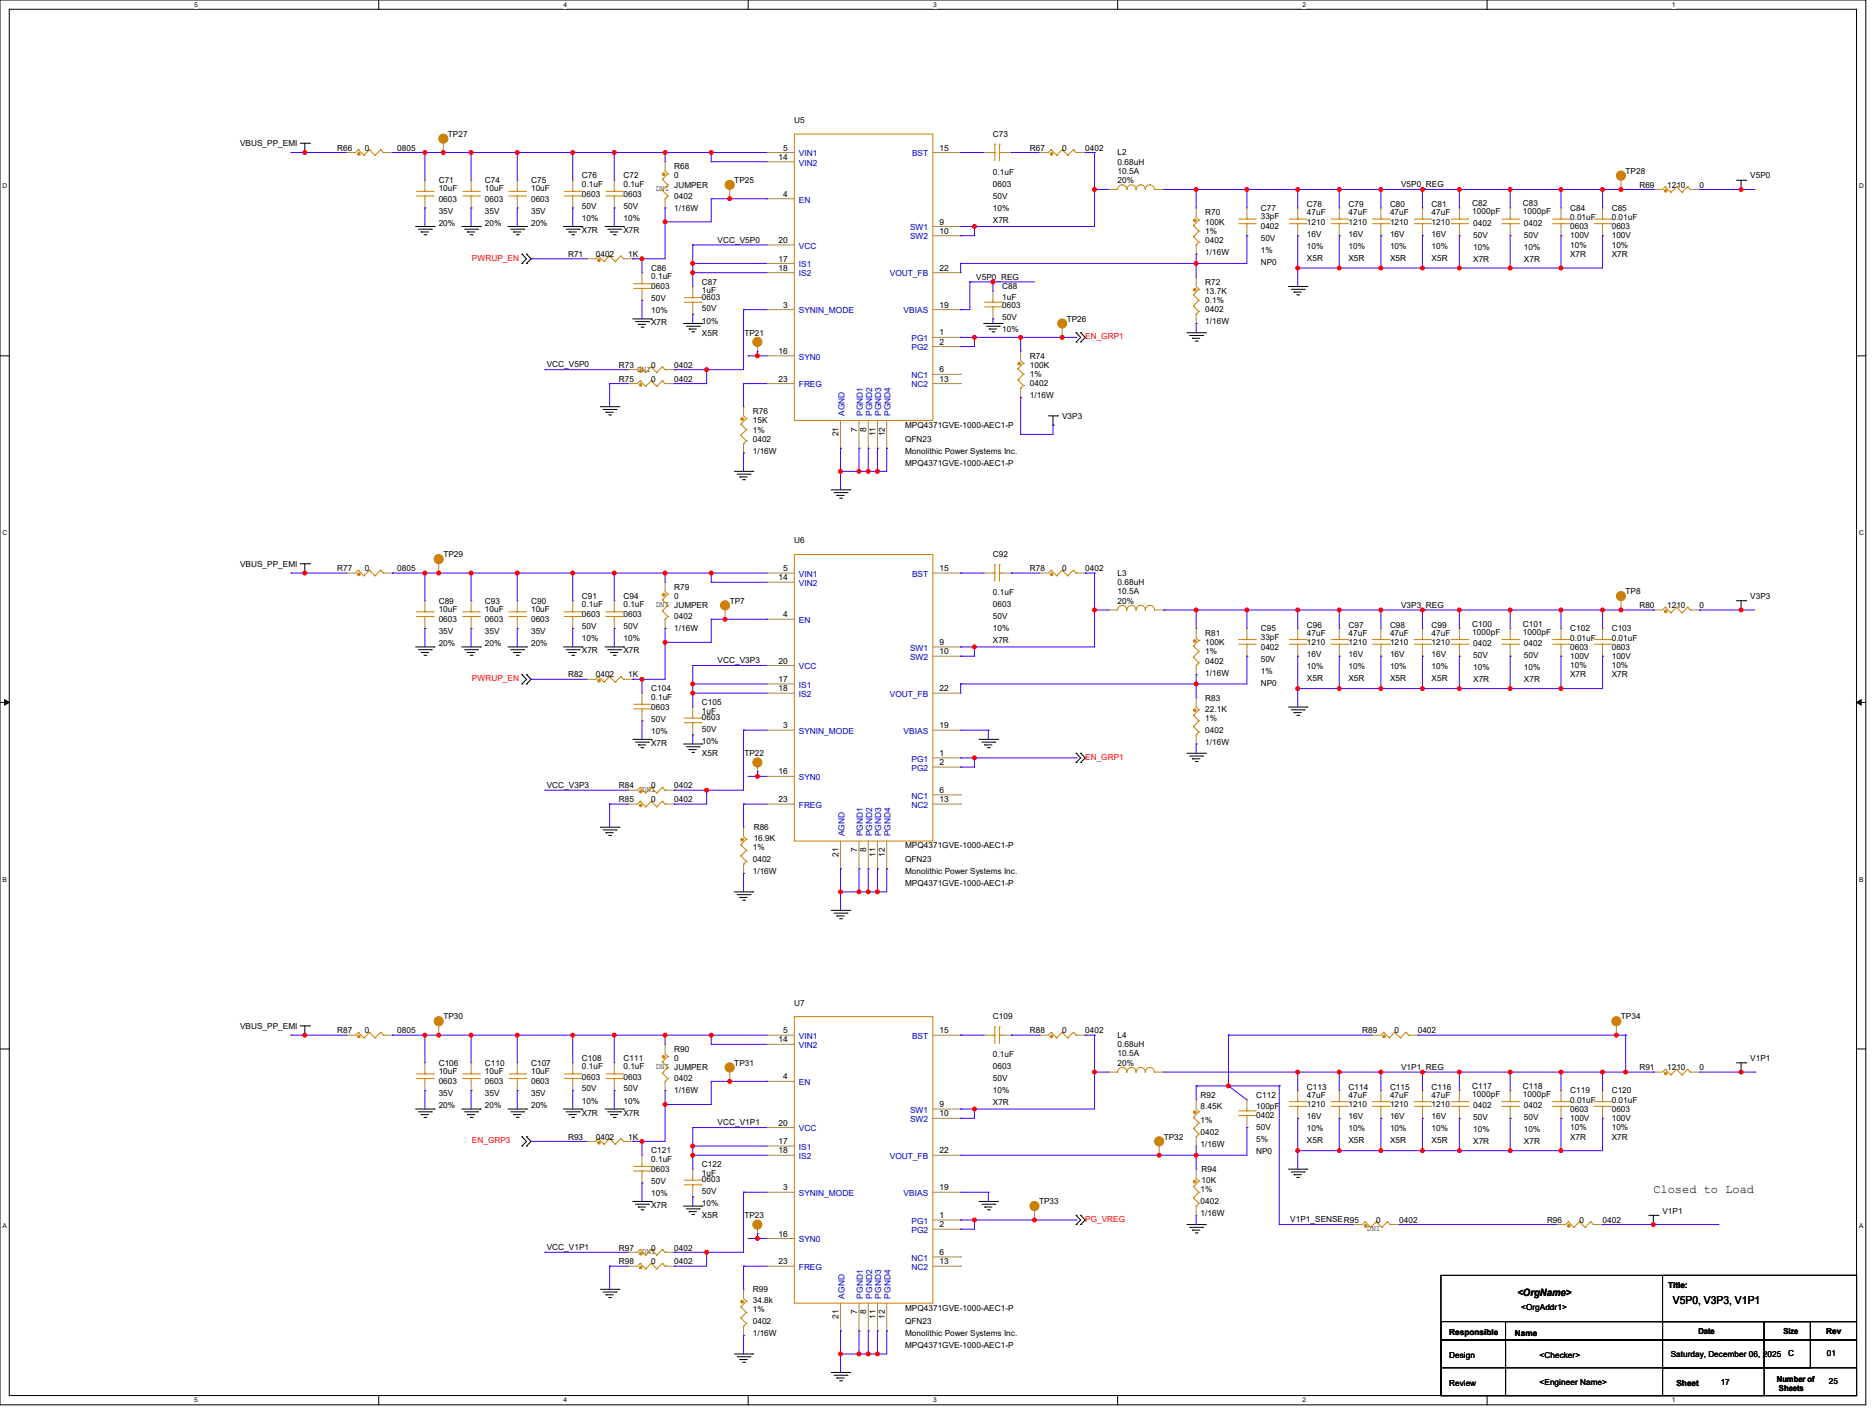
[picture p21: page 17]

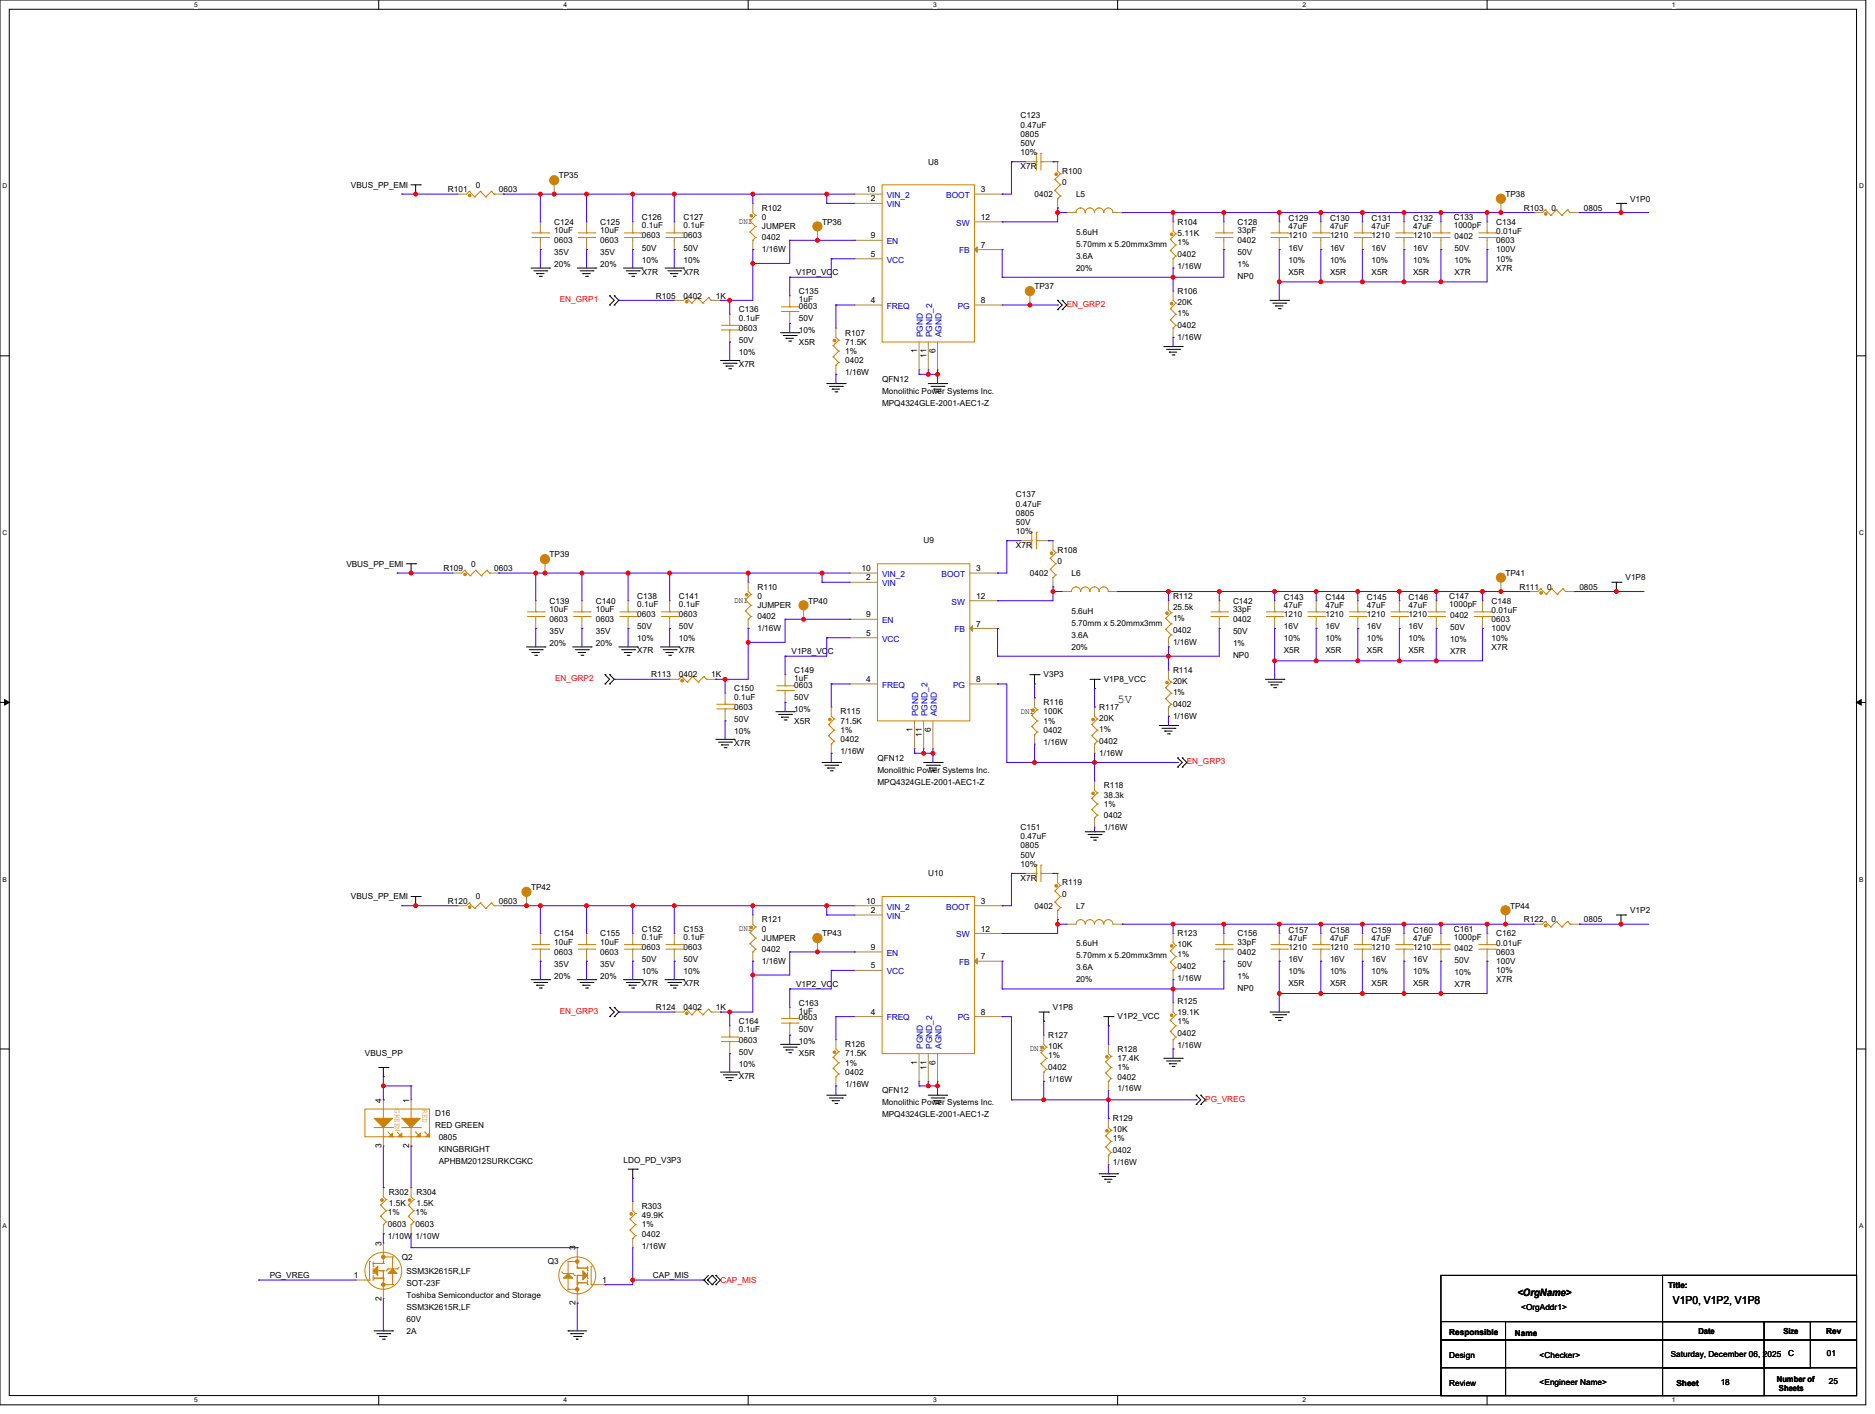
[picture p22: page 18]

QFN12
Monolithic Power Systems Inc.

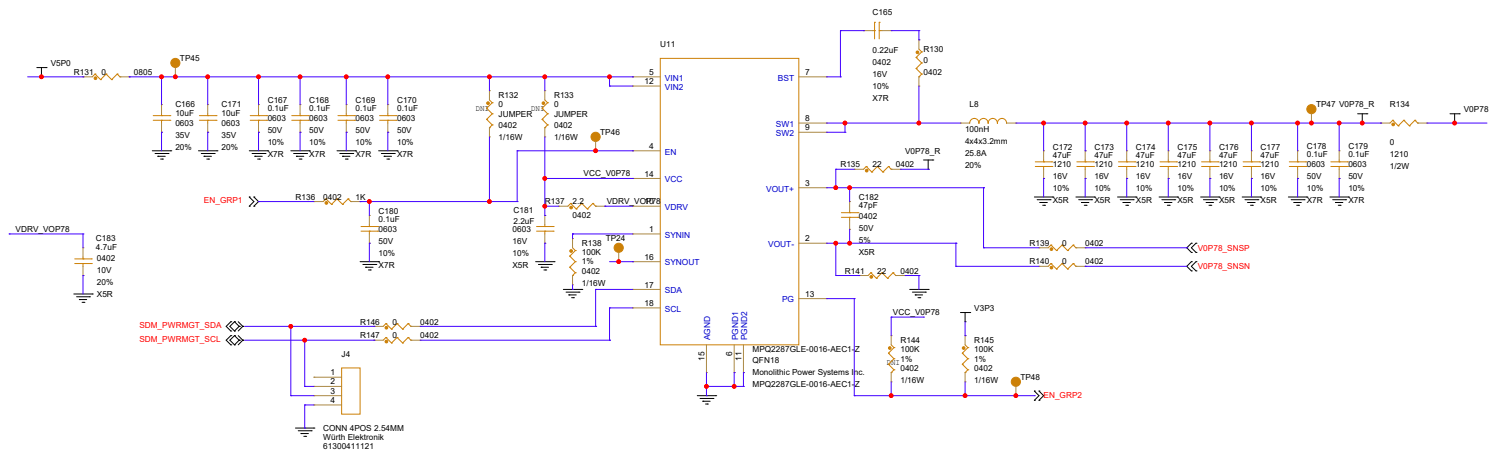
[picture p23: page 19]

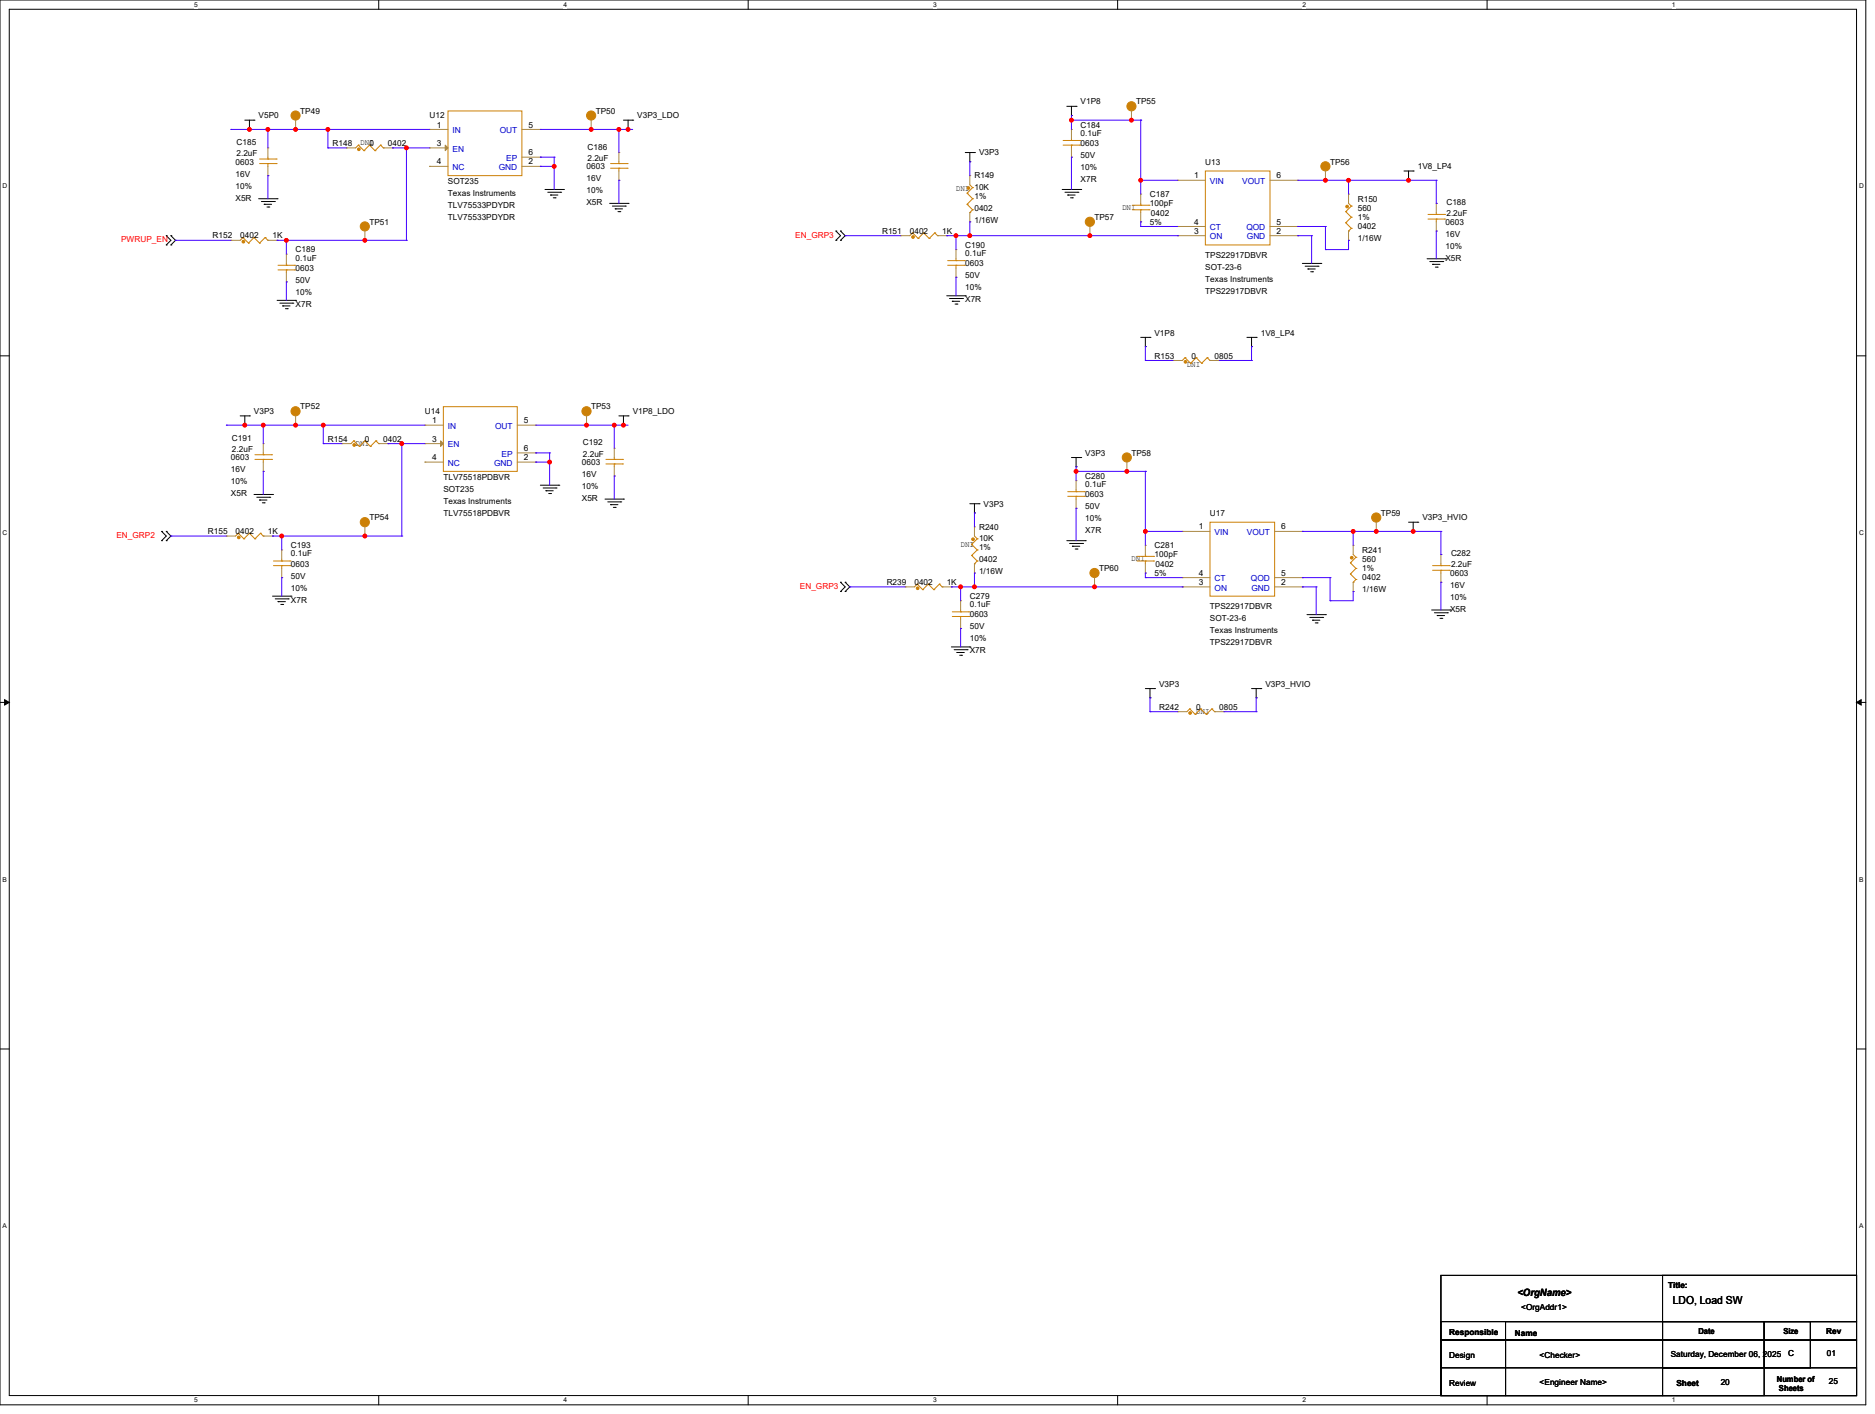
[picture p24: page 20]

LDO, Load SW <OrgName>

### 1V8_LP4

V1P1

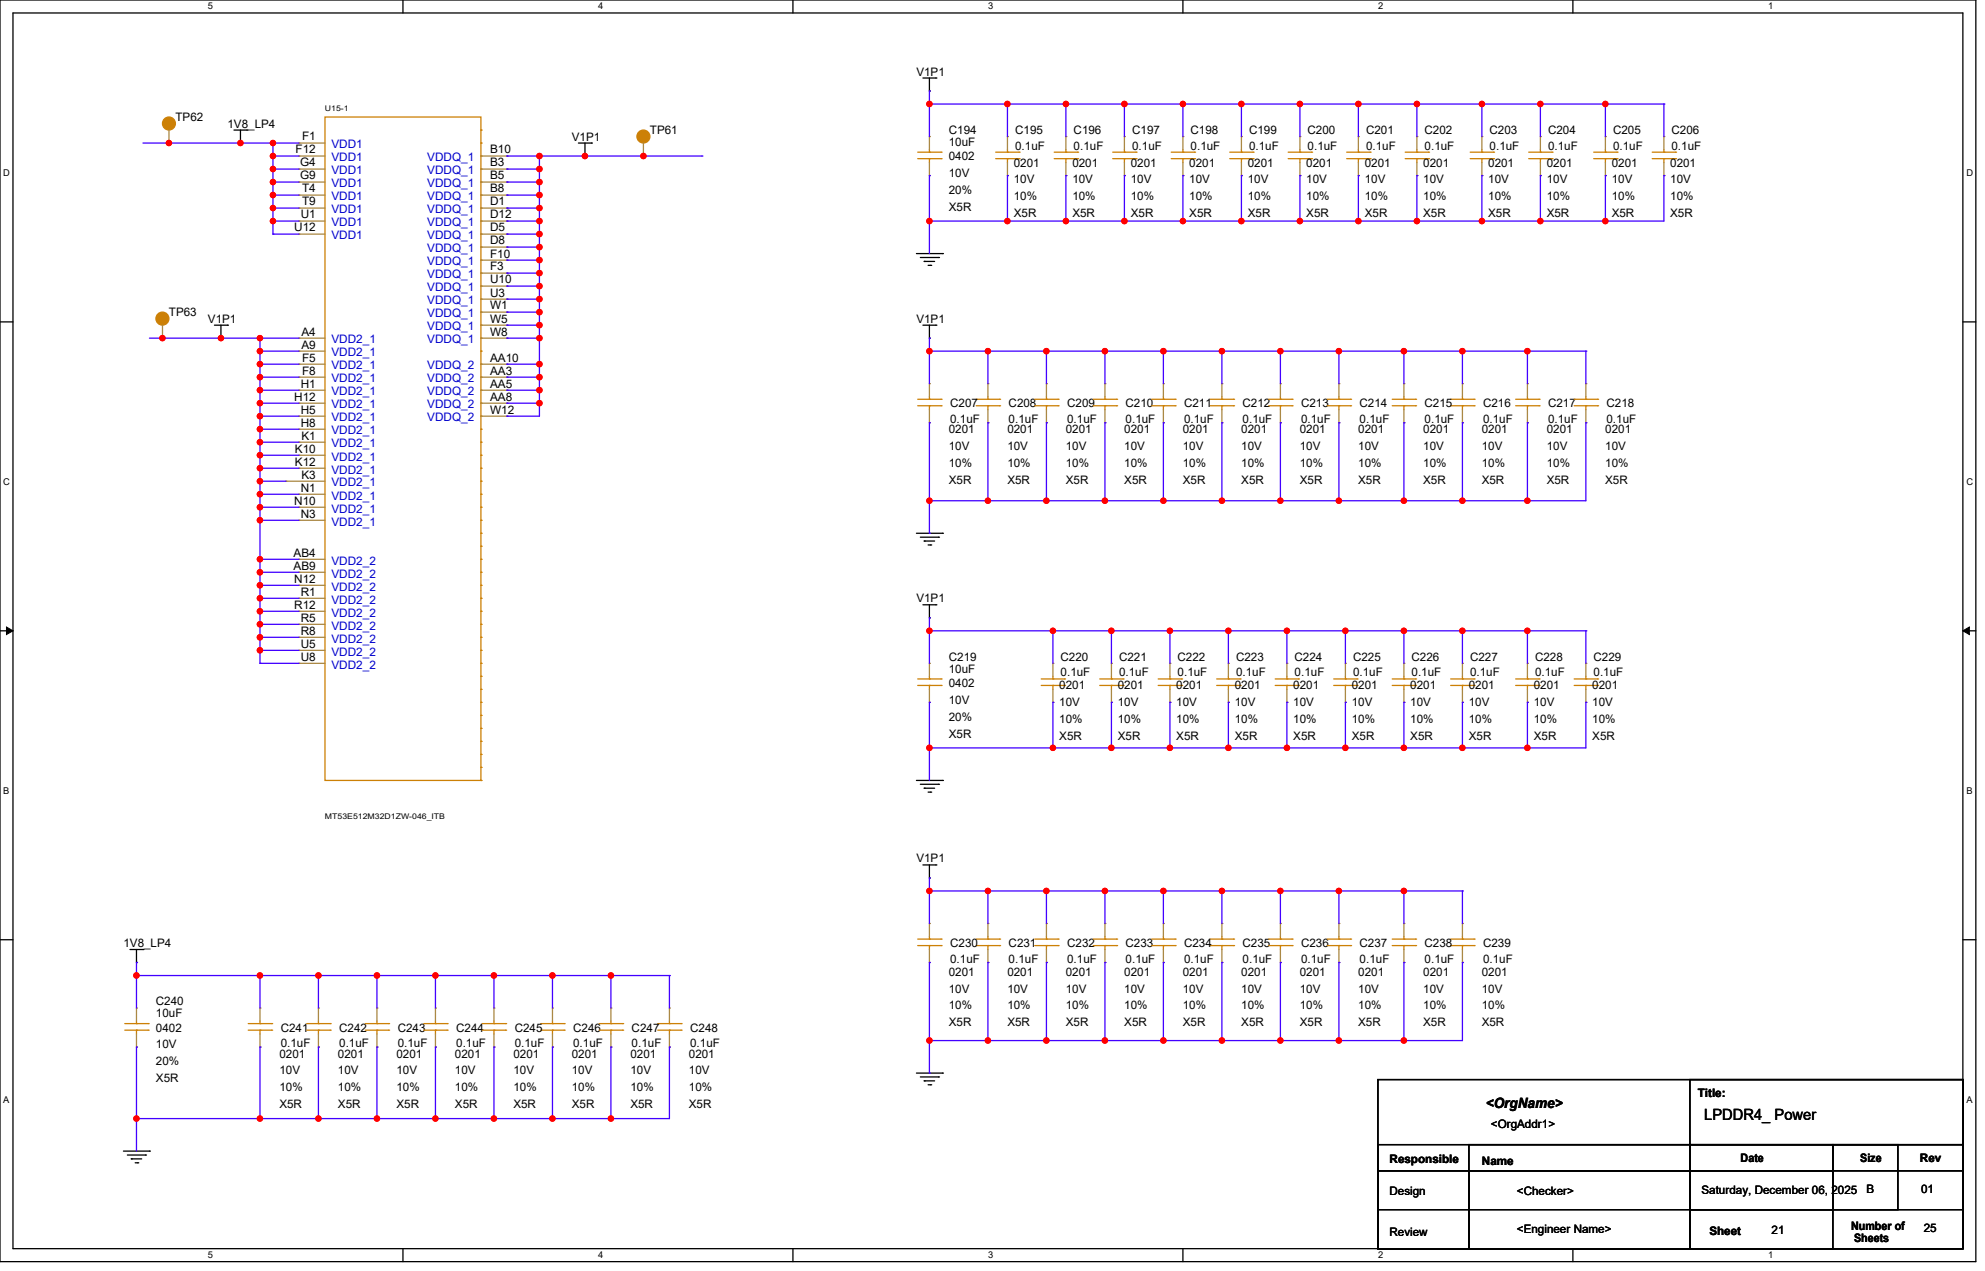
[picture p25: page 21]

V1P1

### LP4_3A_CA0

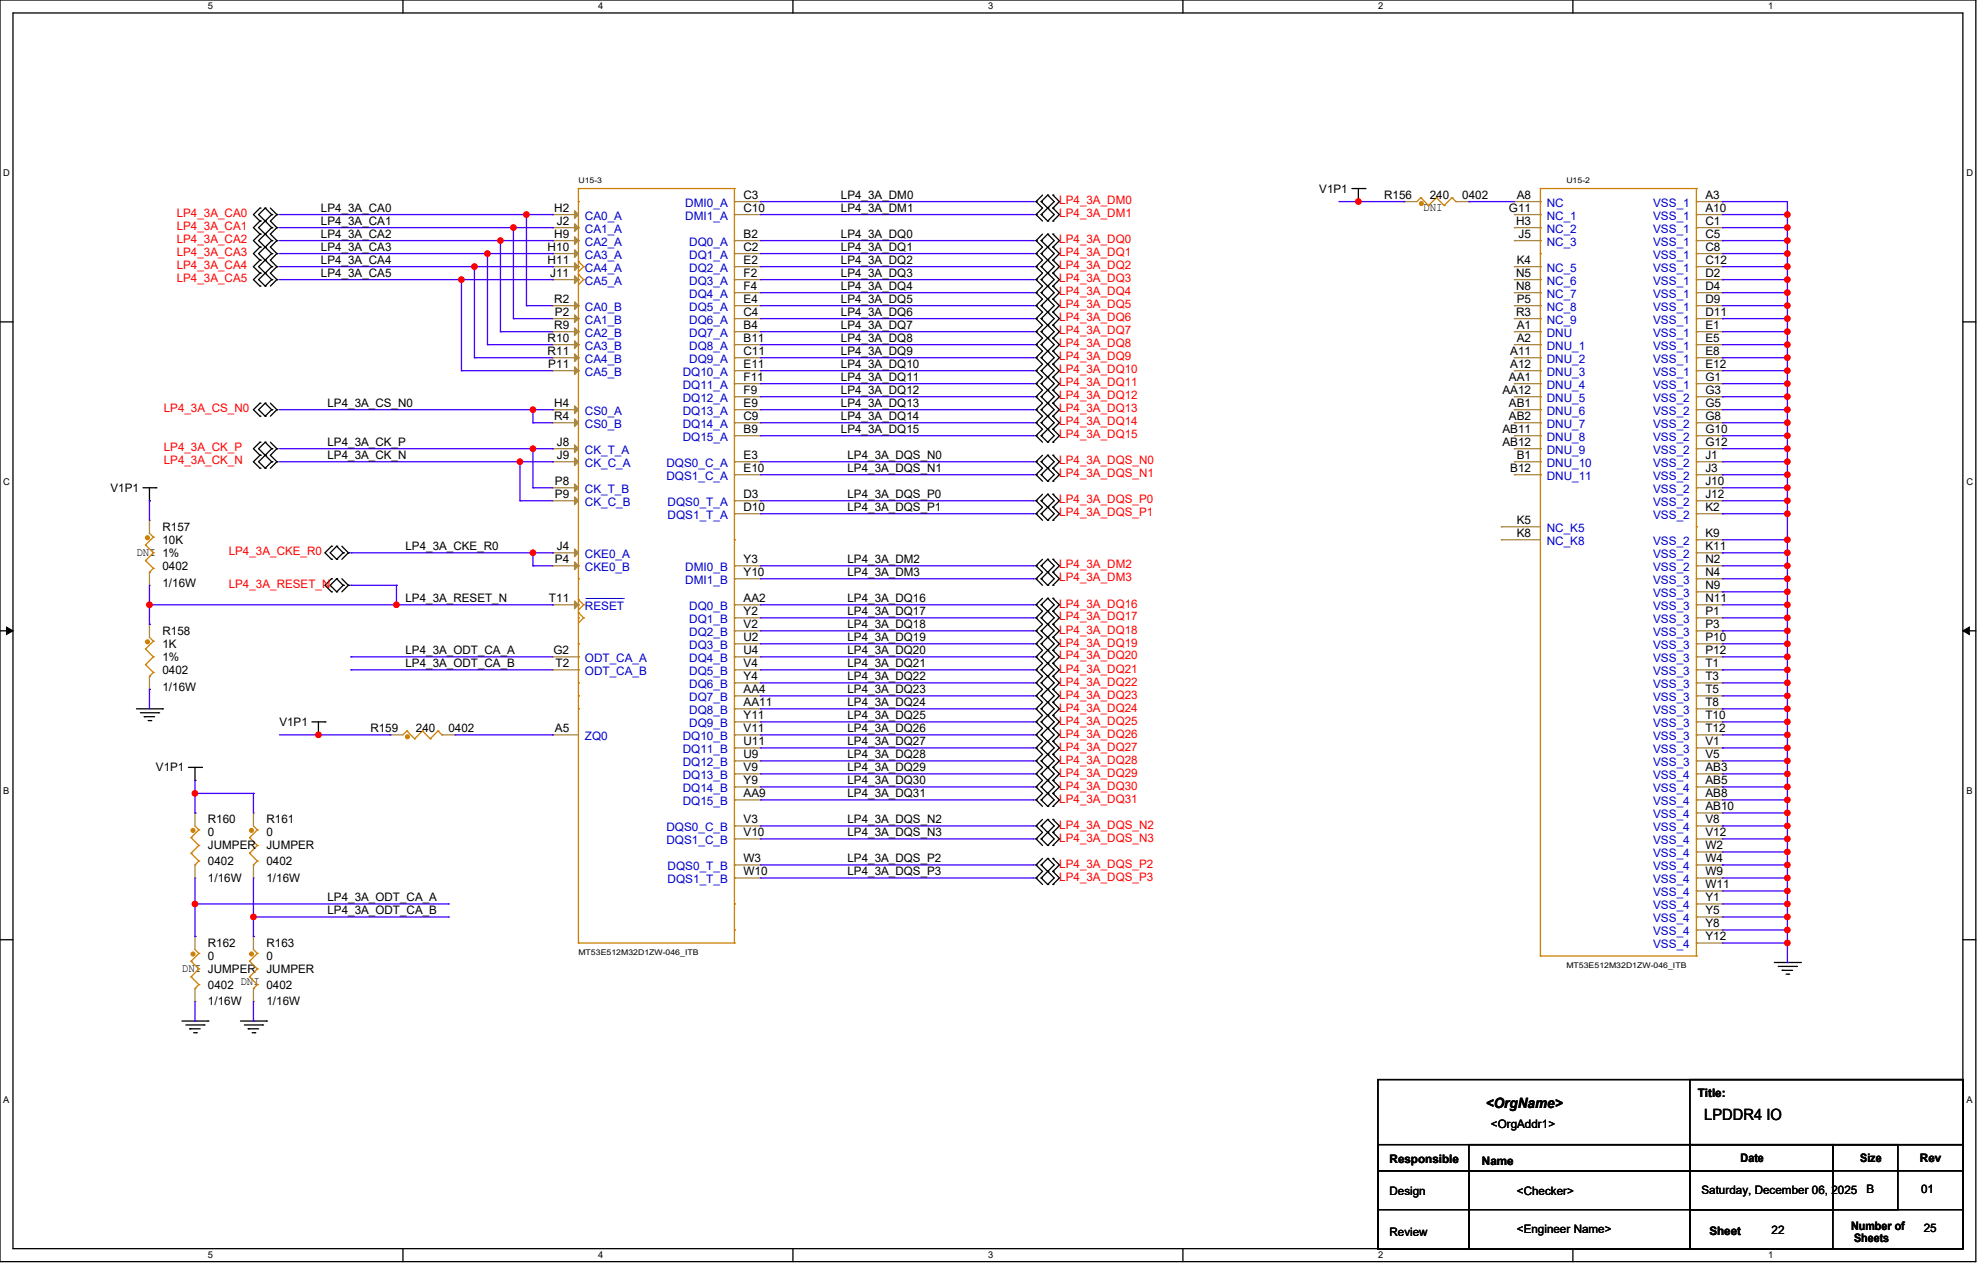
[picture p26: page 22]

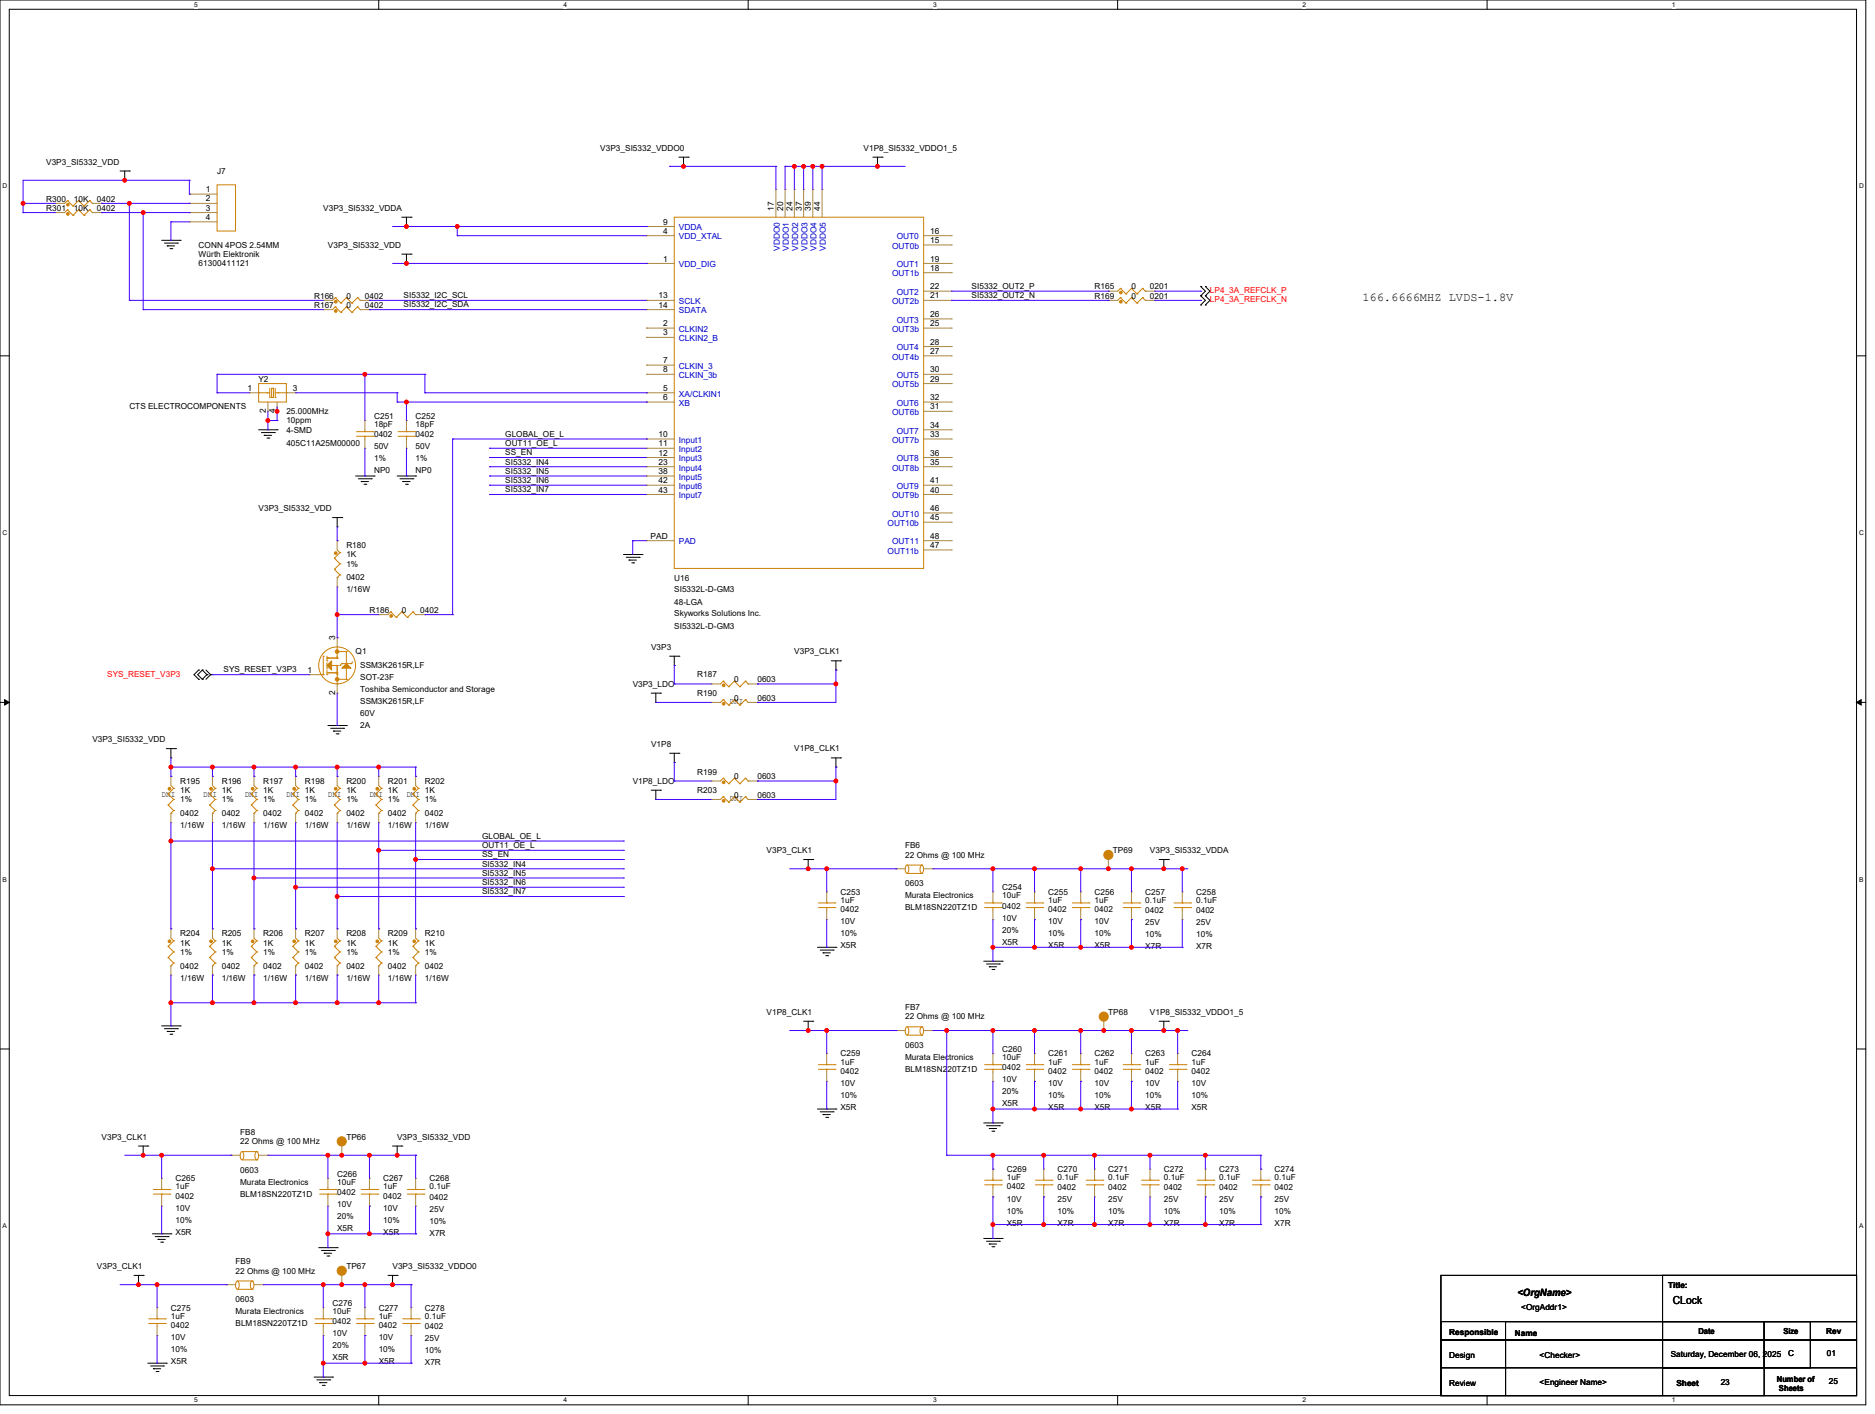
[picture p27: page 23]

V1P8

V1P8

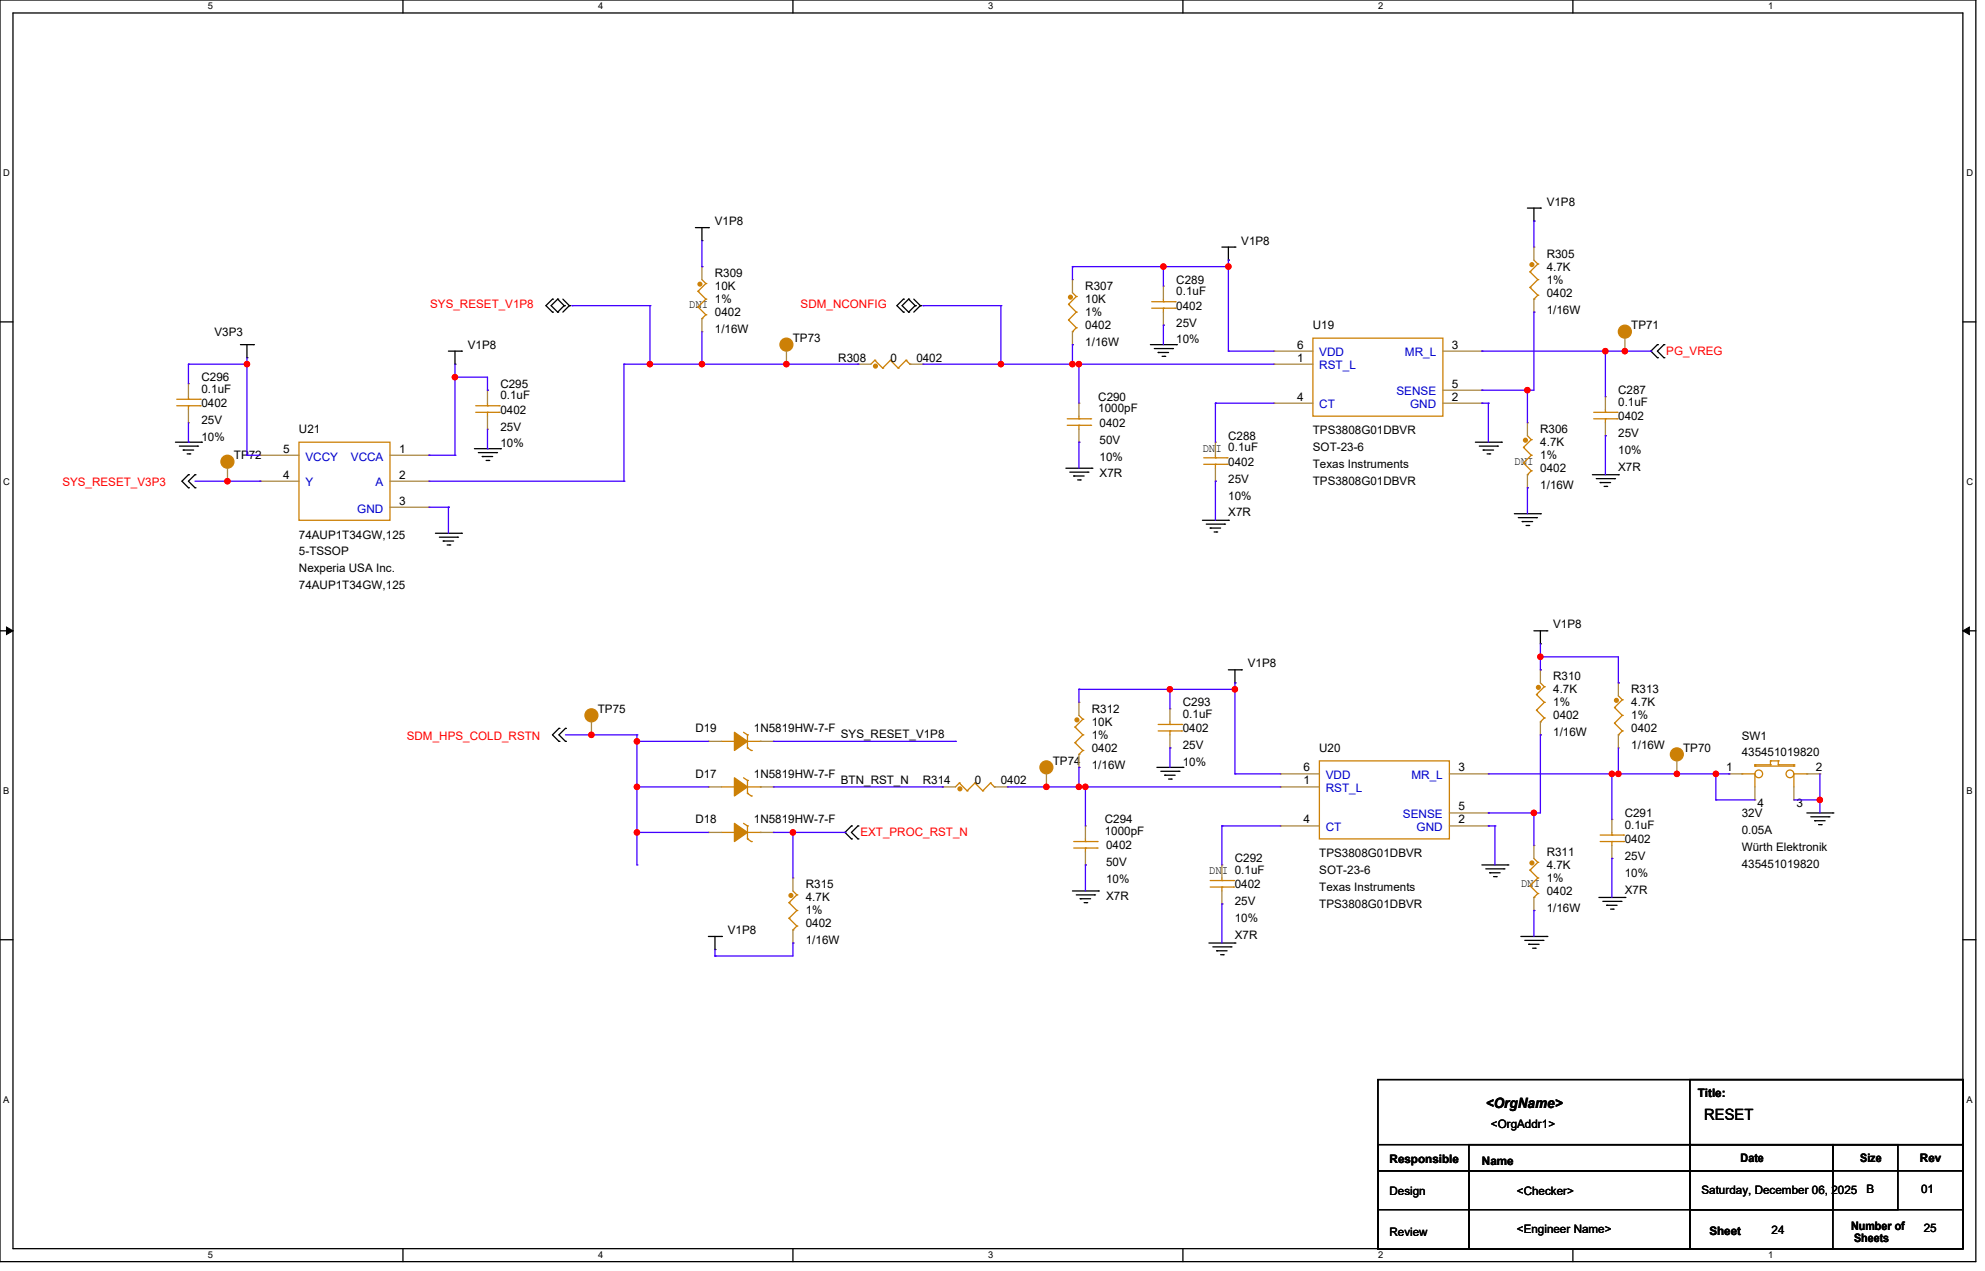
[picture p28: page 24]

### LDO_PD_V3P3

### VBUS_PP_EMI

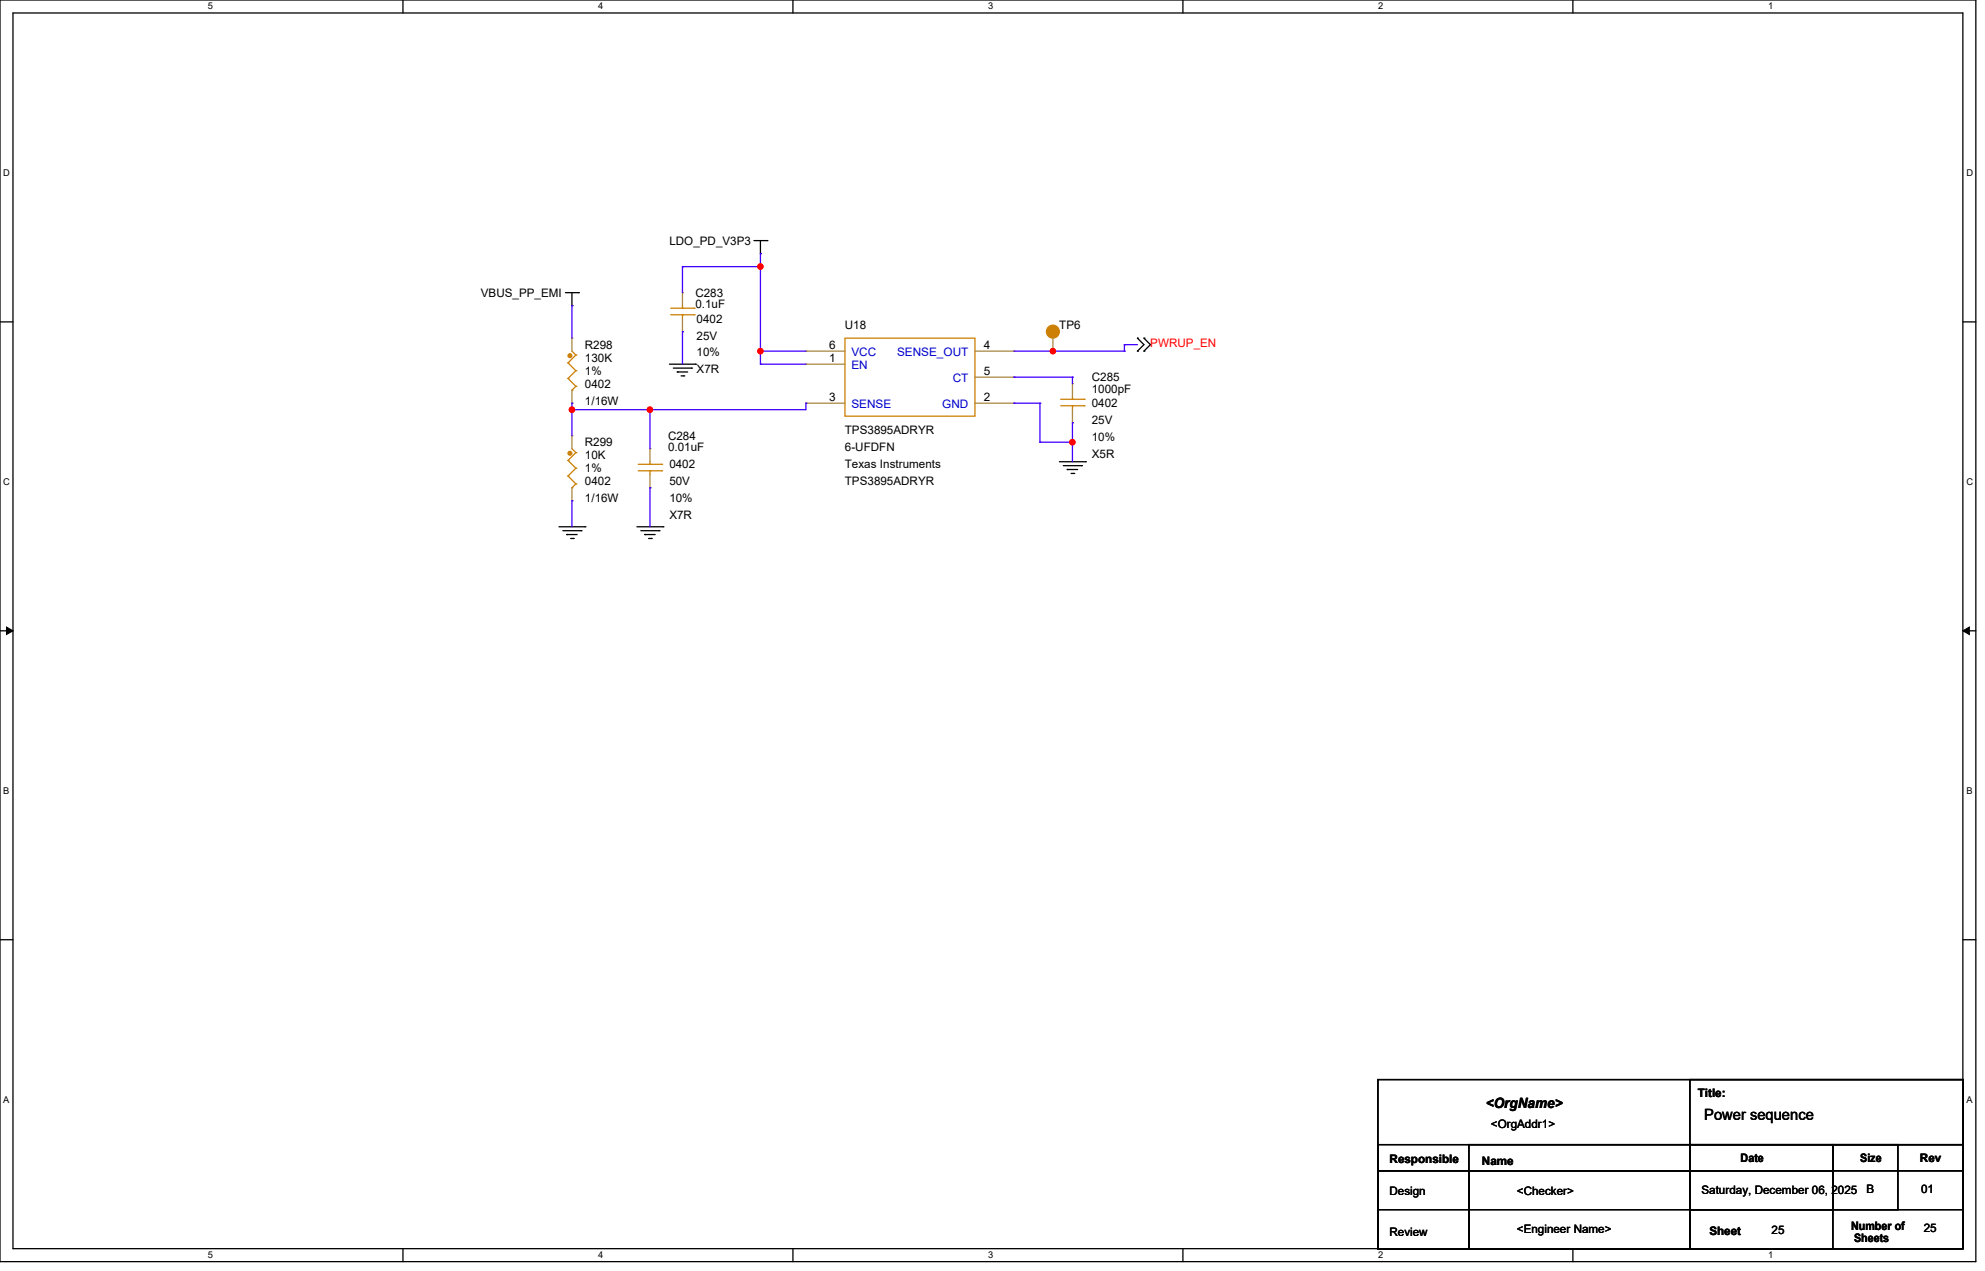
[picture p29: page 25]
PWRUP_EN; Title:; Size; Rev; Review; Sheet; Number of; Sheets; Design; Responsible; Name; Date; <OrgAddr1>; <Checker>; <Engineer Name>; Saturday, December 06, 2025; TPS3895ADRYR; 6-UFDFN; Texas Instruments; GND; 2 SENSE 3; SENSE_OUT; VCC 6

Power sequence <OrgName>
