flapkit/FLAP-0-BD3/(list of files, drawings)

Other design files:
hardware/bd3_rev01/schematics/BD3_A3CY050B_REV01_20251206.DSN
