flapkit/FLAP-0-BD3/(commit log)

2025-12-25 Add initial hardware files for BD3 A3CY050B REV01, including assembly PDFs, BOMs, 3D exports, PCB layout, and schematics.
    [BD3_A3CY050B_REV01_20251206.xlsx, BD3_A3CY050B_REV01_20251206_ASSY.xlsx]
2026-01-01 Update BD3_A3CY050B_REV01_20251206.DSN schematic file
    [BD3_A3CY050B_REV01_20251206.DSN]
